revk/SolarSystem/ESP32/README.md

This is the main Solar System ESP32 based platform.

Do not build with ESP IDF beyond 5.0.1 yet - it breaks
