revk/SolarSystem/PCB/AccessWAGO/README.md

# Access

These files are for use in [KiCad](https://www.kicad.org).

## Trademark

This is an open source project, but bear in mind you cannot sell boards bearing the Andrews & Arnold Ltd name, the A&A logo, the registered trademark AJK logo, or the GS1 allocated EANs assigned to Andrews & Arnold Ltd.

## Images

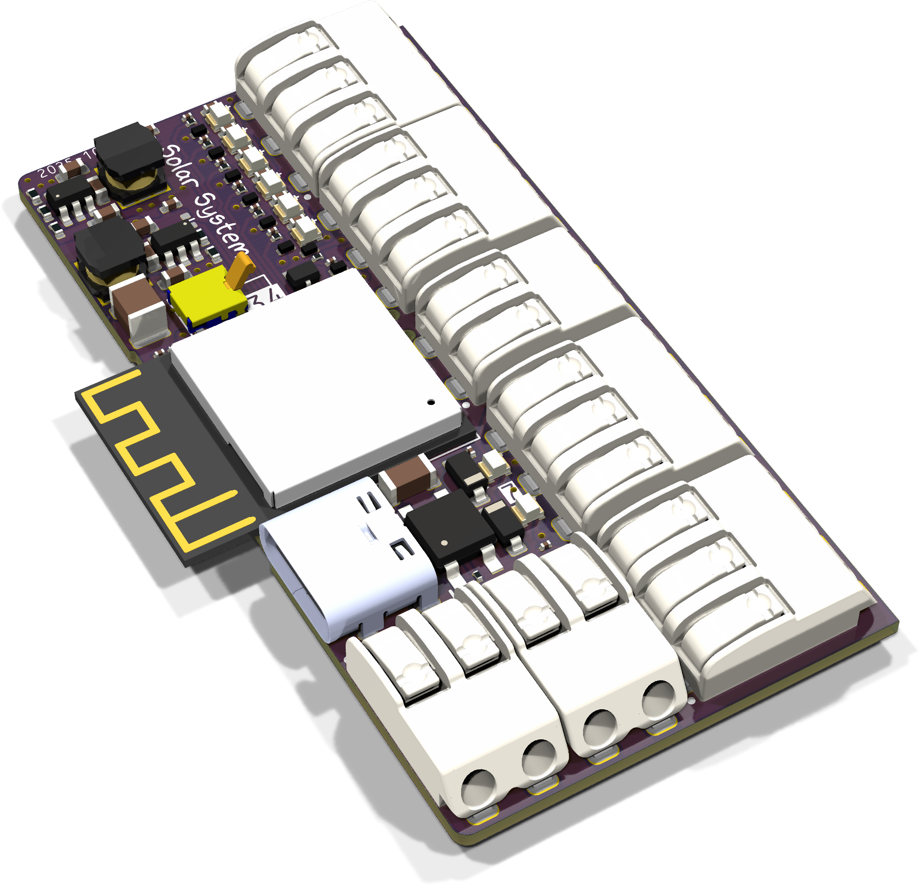
[picture p3: PCB/AccessWAGO/Access-90.png]
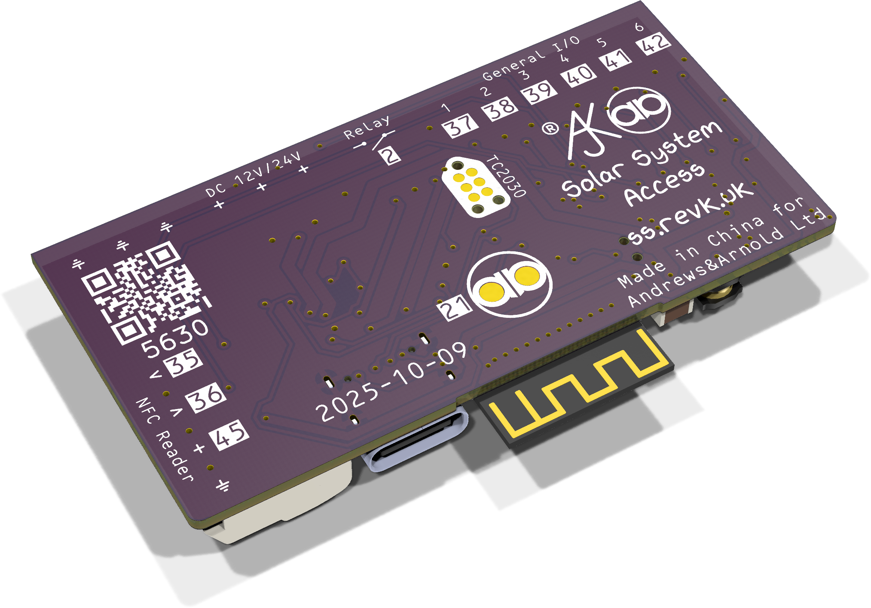
[picture p4: PCB/AccessWAGO/Access-bottom.png]

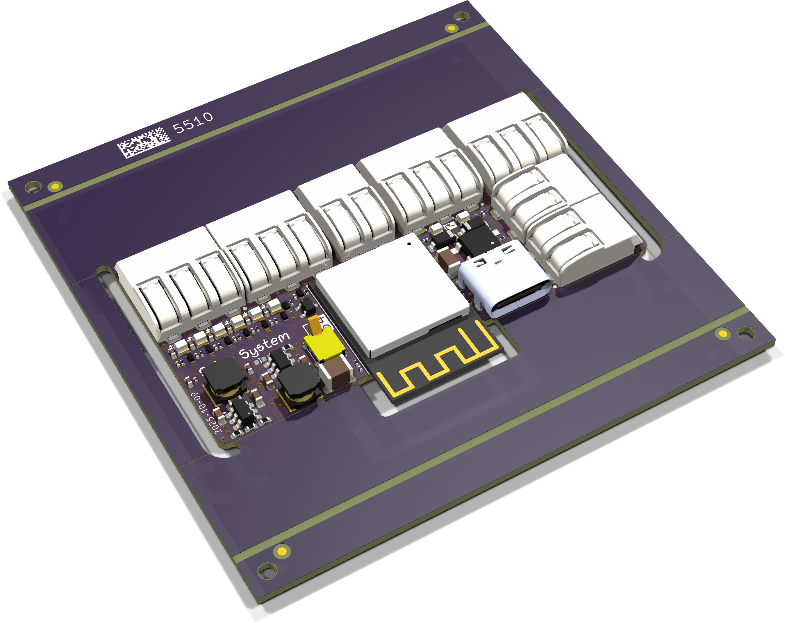
[picture p5: PCB/AccessWAGO/Access-panel.png]
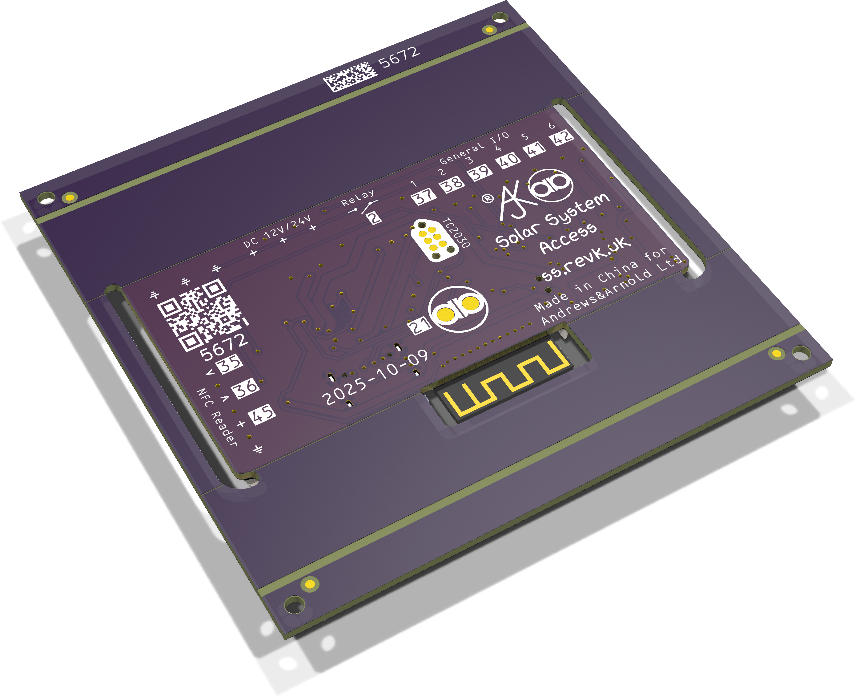
[picture p6: PCB/AccessWAGO/Access-panel-bottom.png]


*Auto generated 2025-08-13T09:46:36*
