revk/SolarSystem/PCB/Access/README.md

# Access

These files are for use in [KiCad](https://www.kicad.org).

## Trademark

This is an open source project, but bear in mind you cannot sell boards bearing the Andrews & Arnold Ltd name, the A&A logo, the registered trademark AJK logo, or the GS1 allocated EANs assigned to Andrews & Arnold Ltd.

## Images

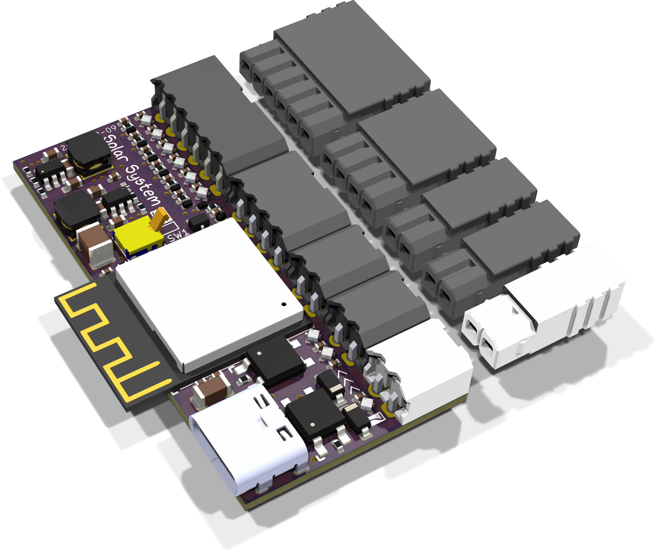
[picture p7: PCB/Access/Access-90.png]
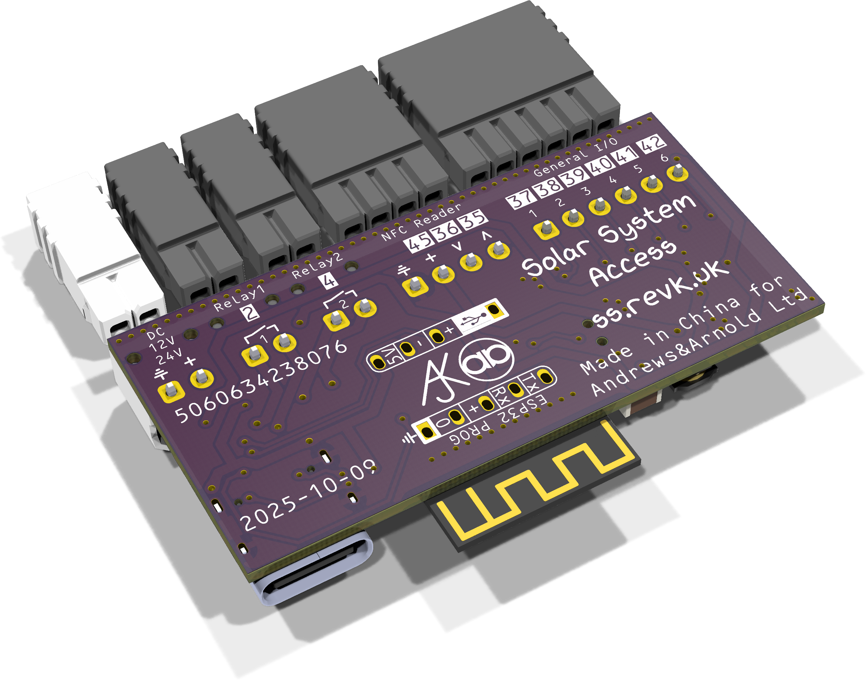
[picture p8: PCB/Access/Access-bottom.png]

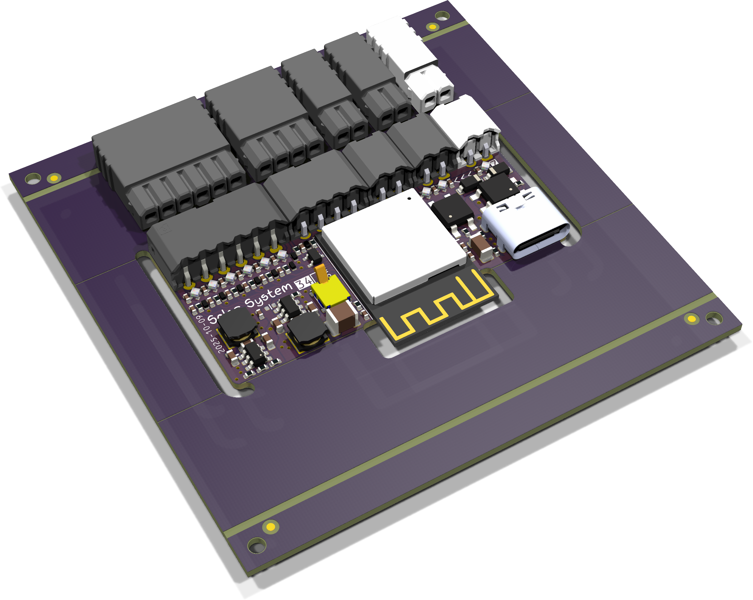
[picture p9: PCB/Access/Access-panel.png]
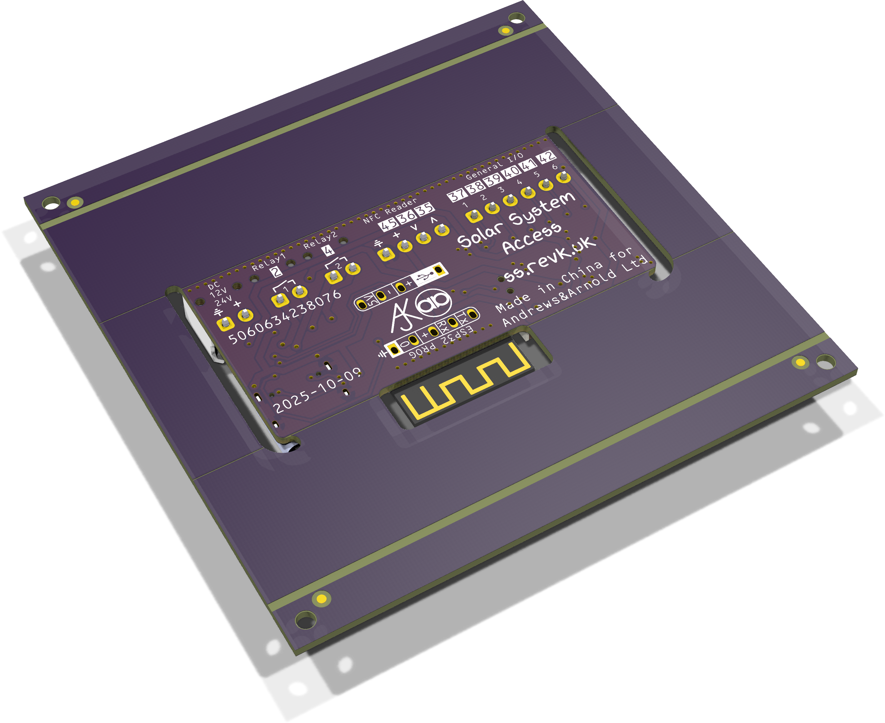
[picture p10: PCB/Access/Access-panel-bottom.png]


*Auto generated 2025-08-12T13:26:37*
