revk/SolarSystem/PCB/Bell/README.md

# Bell

These files are for use in [KiCad](https://www.kicad.org).

## Trademark

This is an open source project, but bear in mind you cannot sell boards bearing the Andrews & Arnold Ltd name, the A&A logo, the registered trademark AJK logo, or the GS1 allocated EANs assigned to Andrews & Arnold Ltd.

## Images

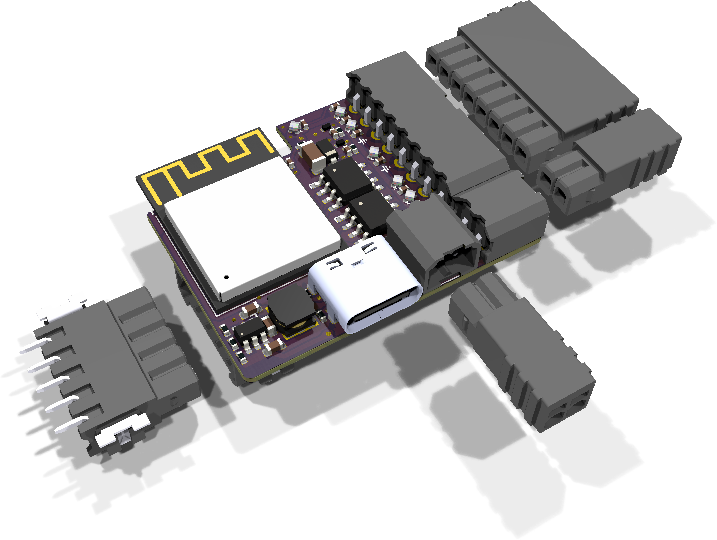
[picture p11: PCB/Bell/Bell.png]
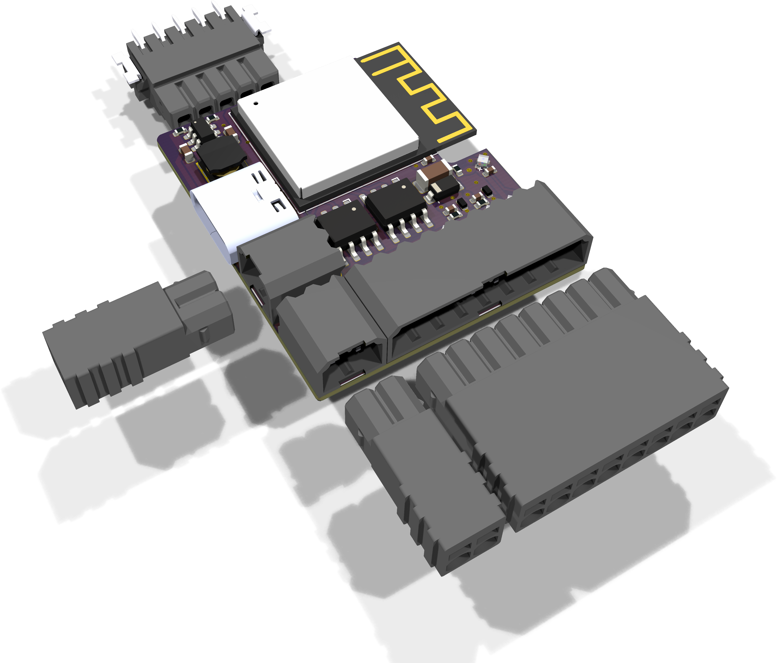
[picture p12: PCB/Bell/Bell-90.png]
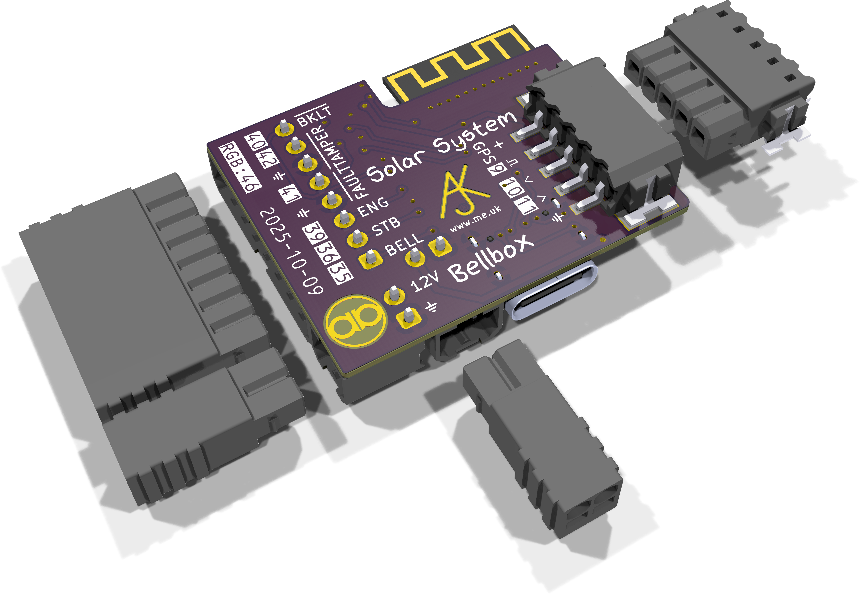
[picture p13: PCB/Bell/Bell-bottom.png]

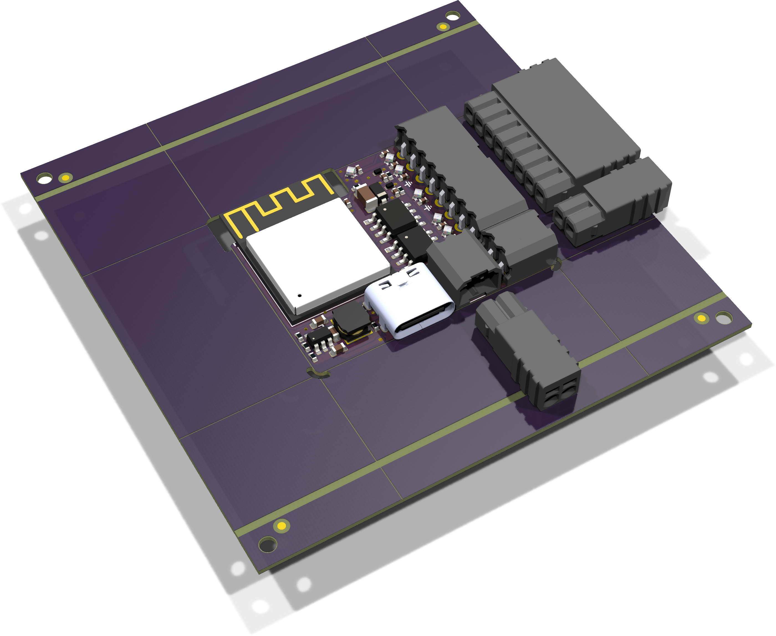
[picture p14: PCB/Bell/Bell-panel.png]
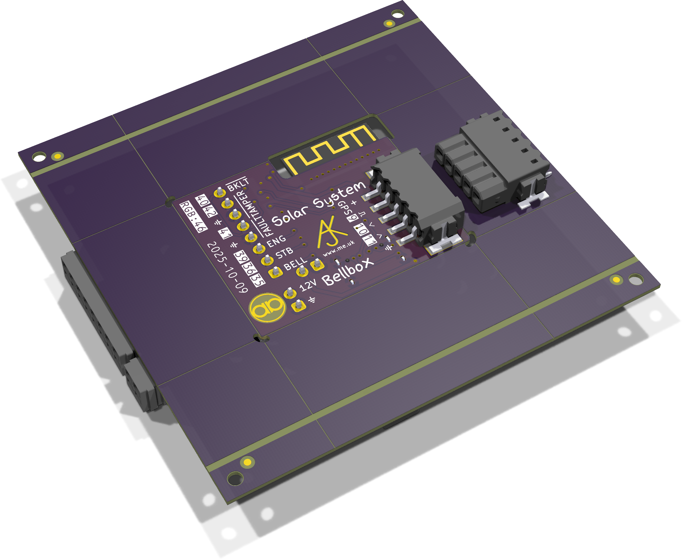
[picture p15: PCB/Bell/Bell-panel-bottom.png]


*Auto generated 2025-08-12T13:32:57*
