revk/SolarSystem/PCB/BellWAGO/README.md

# Bell

These files are for use in [KiCad](https://www.kicad.org).

## Trademark

This is an open source project, but bear in mind you cannot sell boards bearing the Andrews & Arnold Ltd name, the A&A logo, the registered trademark AJK logo, or the GS1 allocated EANs assigned to Andrews & Arnold Ltd.

## Images

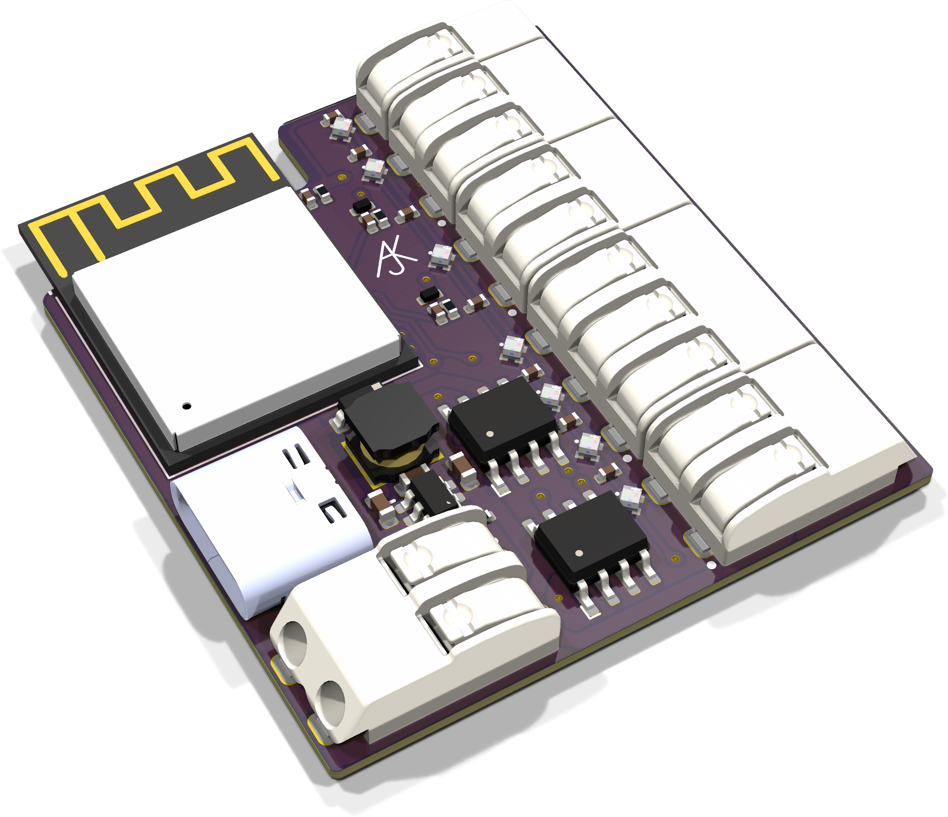
[picture p16: PCB/BellWAGO/Bell.png]
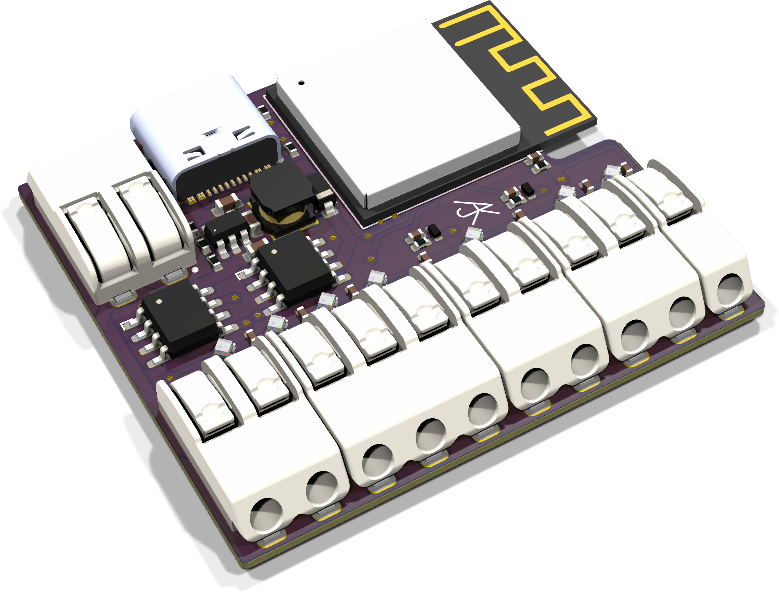
[picture p17: PCB/BellWAGO/Bell-90.png]
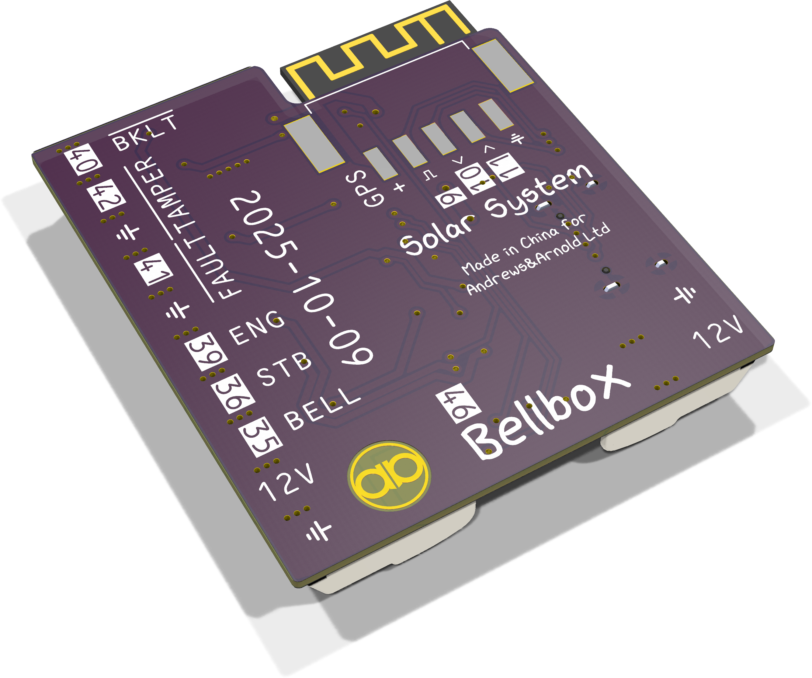
[picture p18: PCB/BellWAGO/Bell-bottom.png]

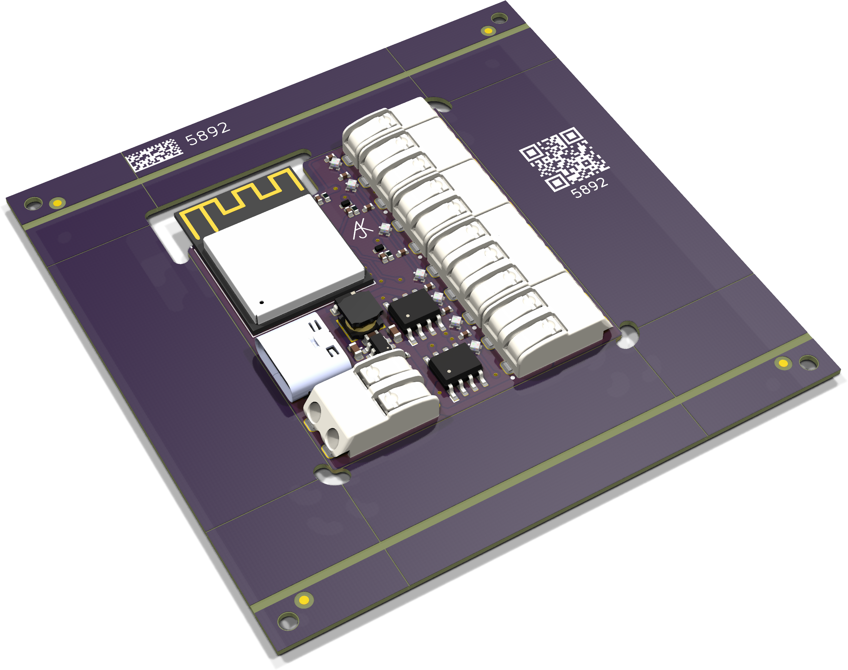
[picture p19: PCB/BellWAGO/Bell-panel.png]
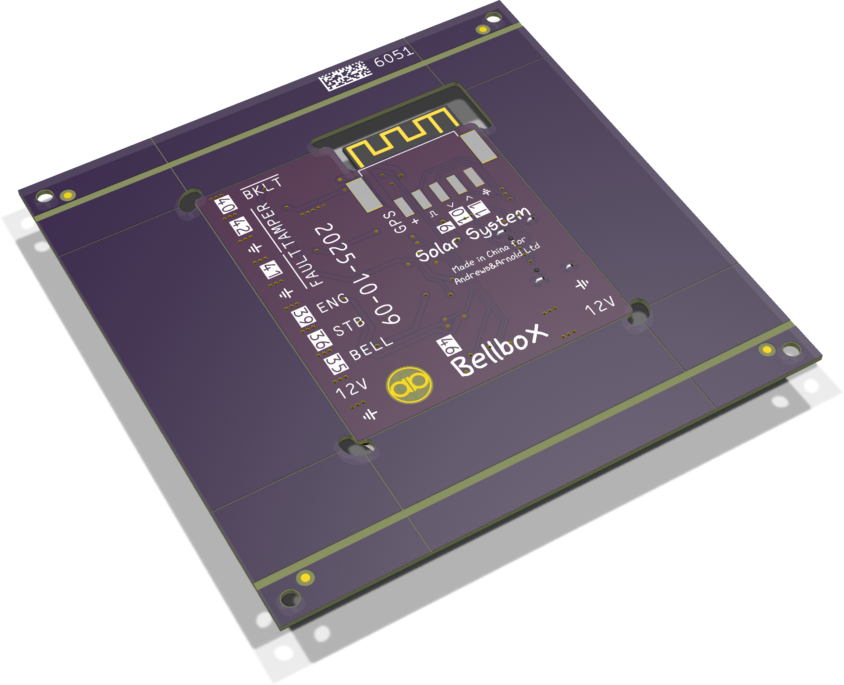
[picture p20: PCB/BellWAGO/Bell-panel-bottom.png]


*Auto generated 2025-08-12T13:36:08*
