revk/SolarSystem/PCB/Generic/README.md

# Generic

These files are for use in [KiCad](https://www.kicad.org).

## Trademark

This is an open source project, but bear in mind you cannot sell boards bearing the Andrews & Arnold Ltd name, the A&A logo, the registered trademark AJK logo, or the GS1 allocated EANs assigned to Andrews & Arnold Ltd.

## Images

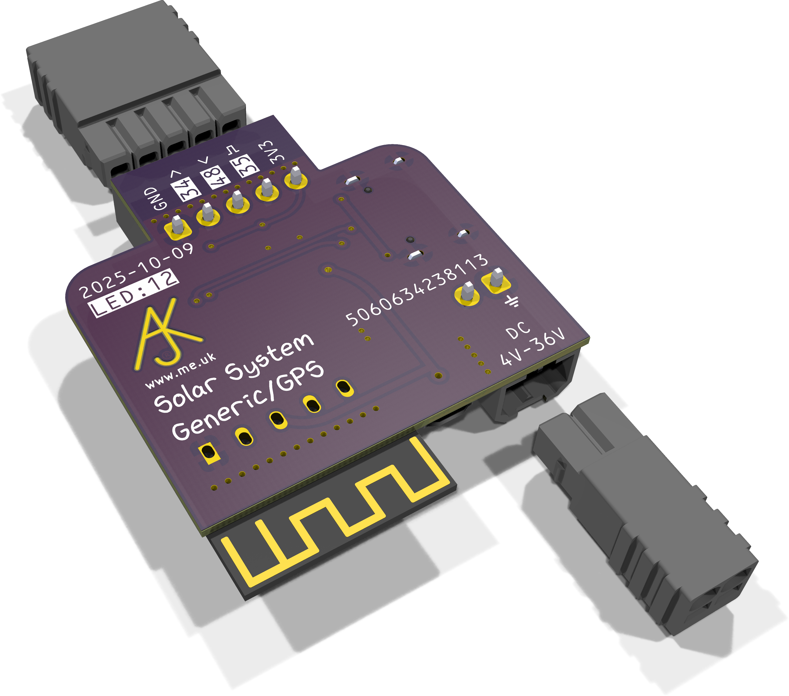
[picture p21: PCB/Generic/Generic.png]
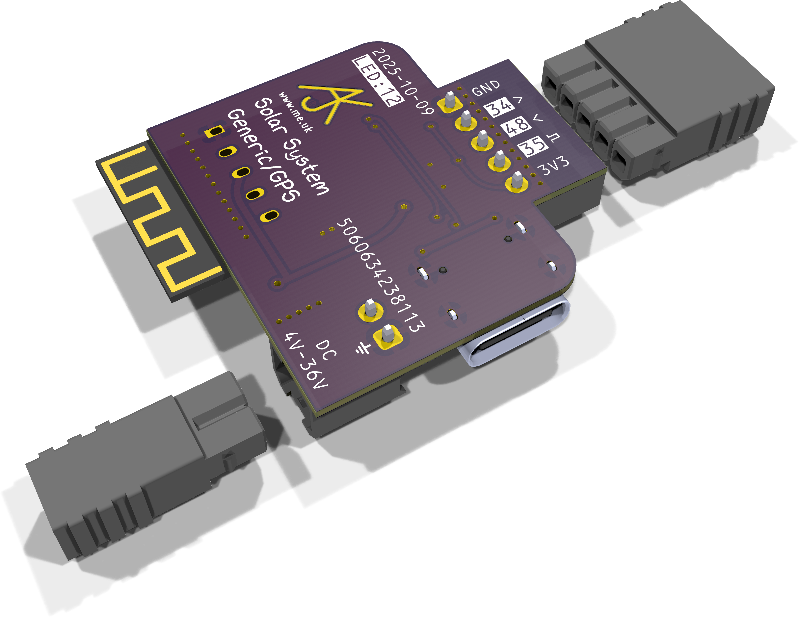
[picture p22: PCB/Generic/Generic-90.png]
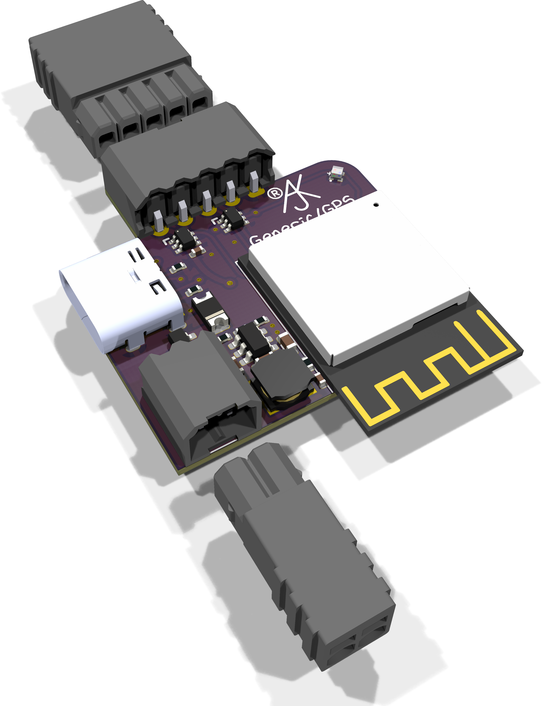
[picture p23: PCB/Generic/Generic-bottom.png]

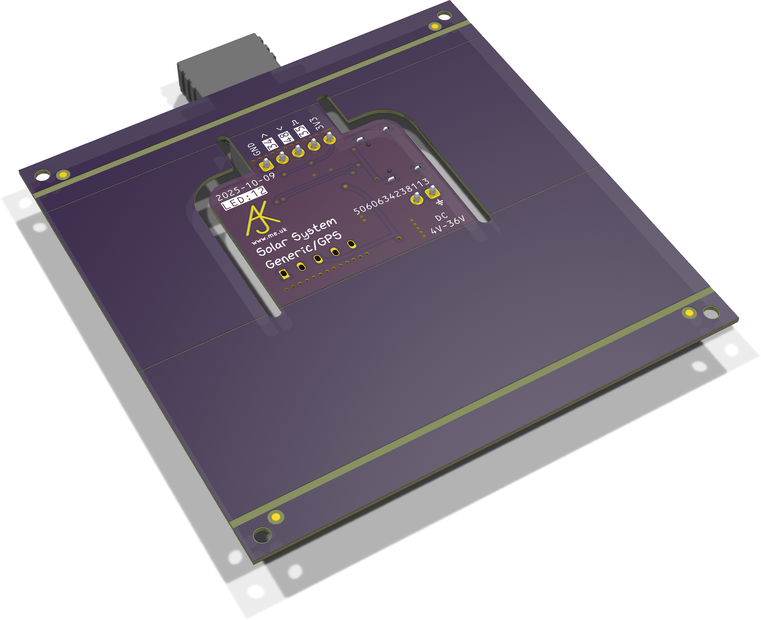
[picture p24: PCB/Generic/Generic-panel.png]
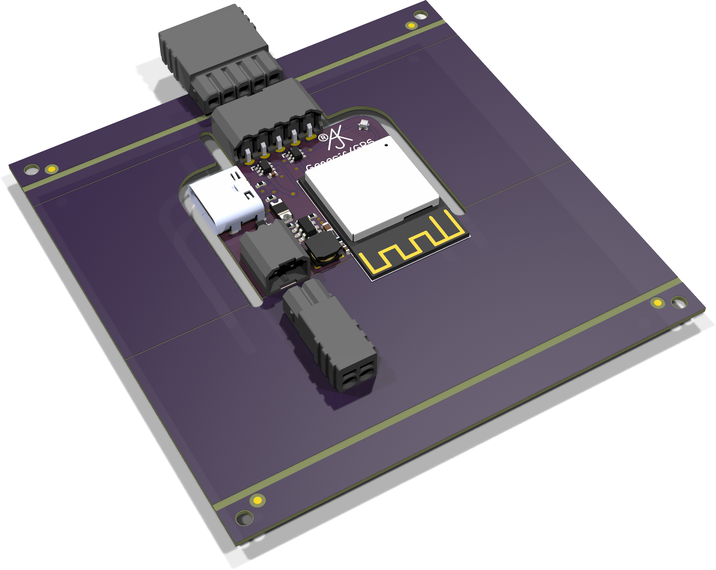
[picture p25: PCB/Generic/Generic-panel-bottom.png]


*Auto generated 2025-08-12T13:39:20*
