revk/SolarSystem/PCB/Keypad/README.md

# Keypad

These files are for use in [KiCad](https://www.kicad.org).

## Trademark

This is an open source project, but bear in mind you cannot sell boards bearing the Andrews & Arnold Ltd name, the A&A logo, the registered trademark AJK logo, or the GS1 allocated EANs assigned to Andrews & Arnold Ltd.

## Images

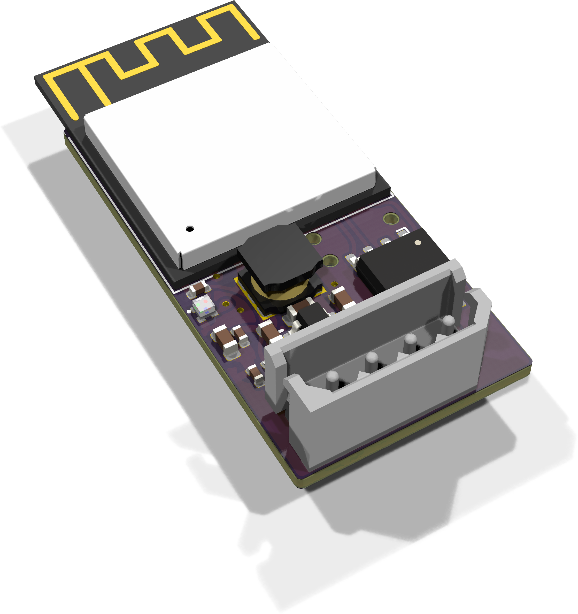
[picture p26: PCB/Keypad/Keypad.png]
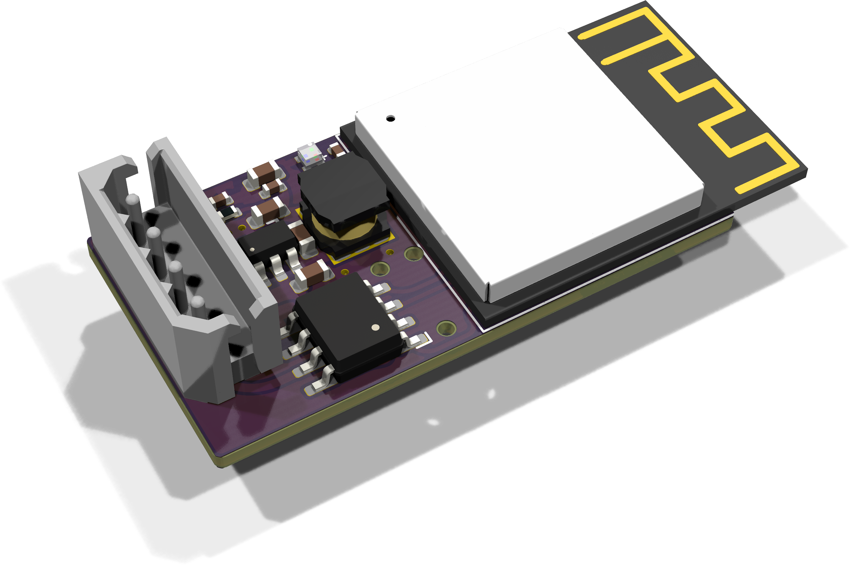
[picture p27: PCB/Keypad/Keypad-90.png]
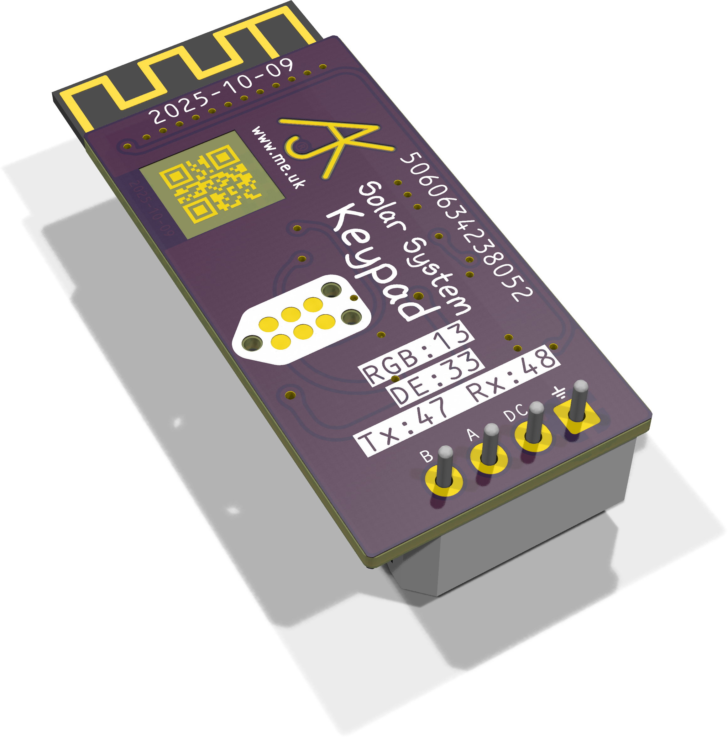
[picture p28: PCB/Keypad/Keypad-bottom.png]

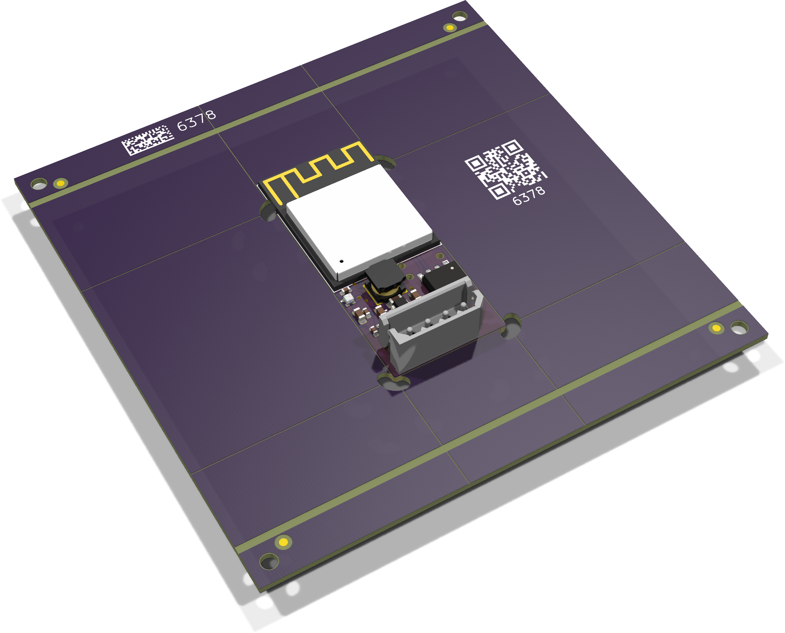
[picture p29: PCB/Keypad/Keypad-panel.png]
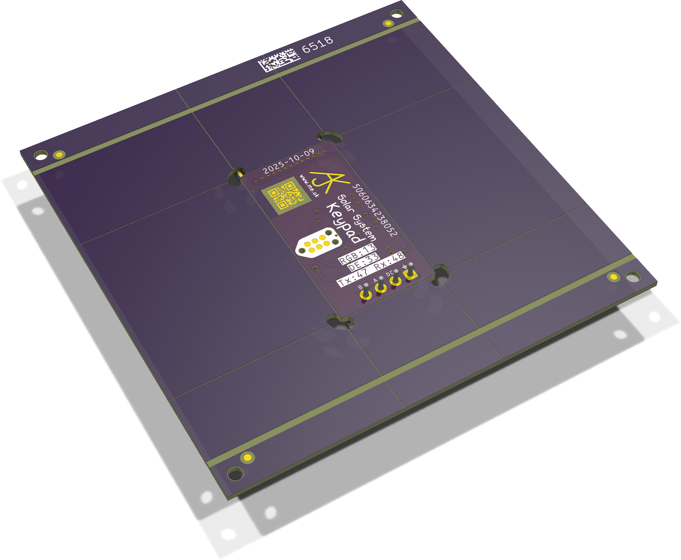
[picture p30: PCB/Keypad/Keypad-panel-bottom.png]


*Auto generated 2025-08-12T13:42:20*
