revk/SolarSystem/PCB/Output/README.md

# Output

These files are for use in [KiCad](https://www.kicad.org).

## Trademark

This is an open source project, but bear in mind you cannot sell boards bearing the Andrews & Arnold Ltd name, the A&A logo, the registered trademark AJK logo, or the GS1 allocated EANs assigned to Andrews & Arnold Ltd.

## Images

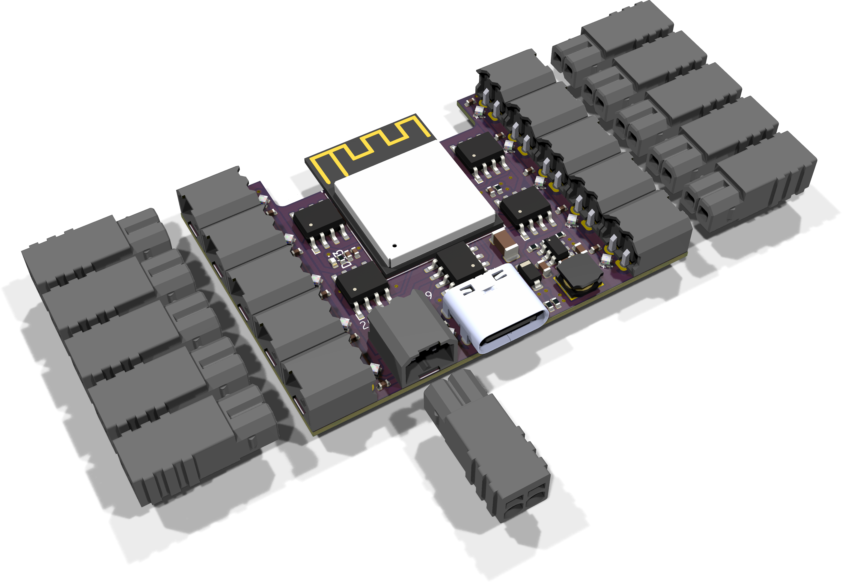
[picture p31: PCB/Output/Output.png]
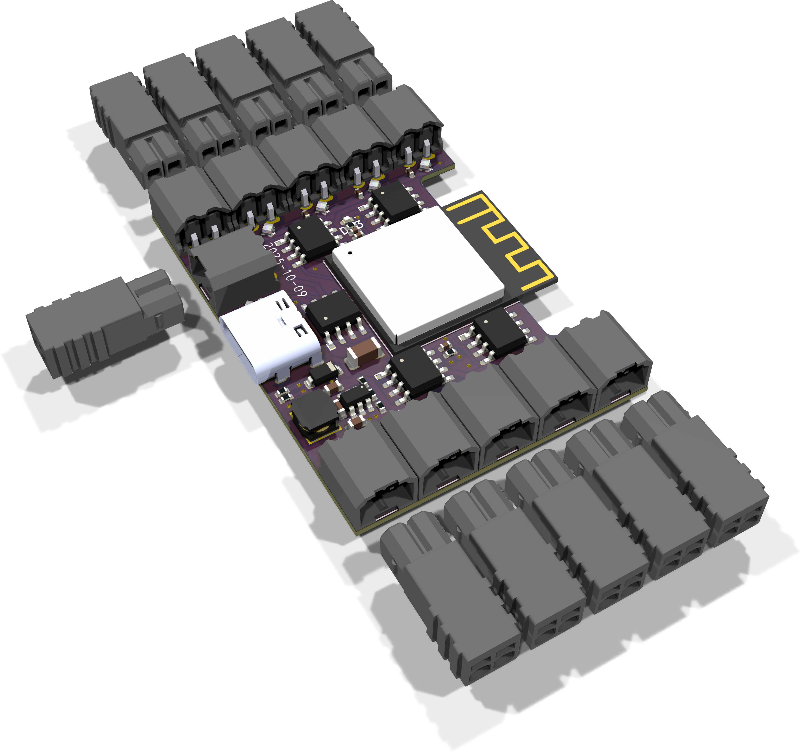
[picture p32: PCB/Output/Output-90.png]
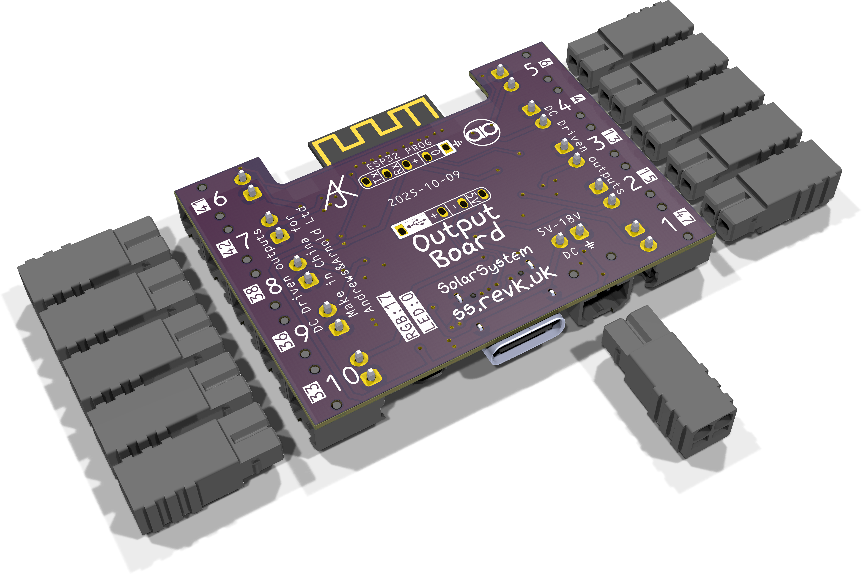
[picture p33: PCB/Output/Output-bottom.png]

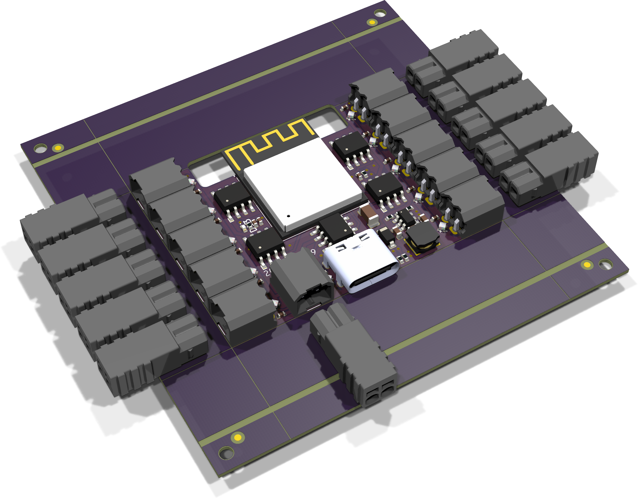
[picture p34: PCB/Output/Output-panel.png]
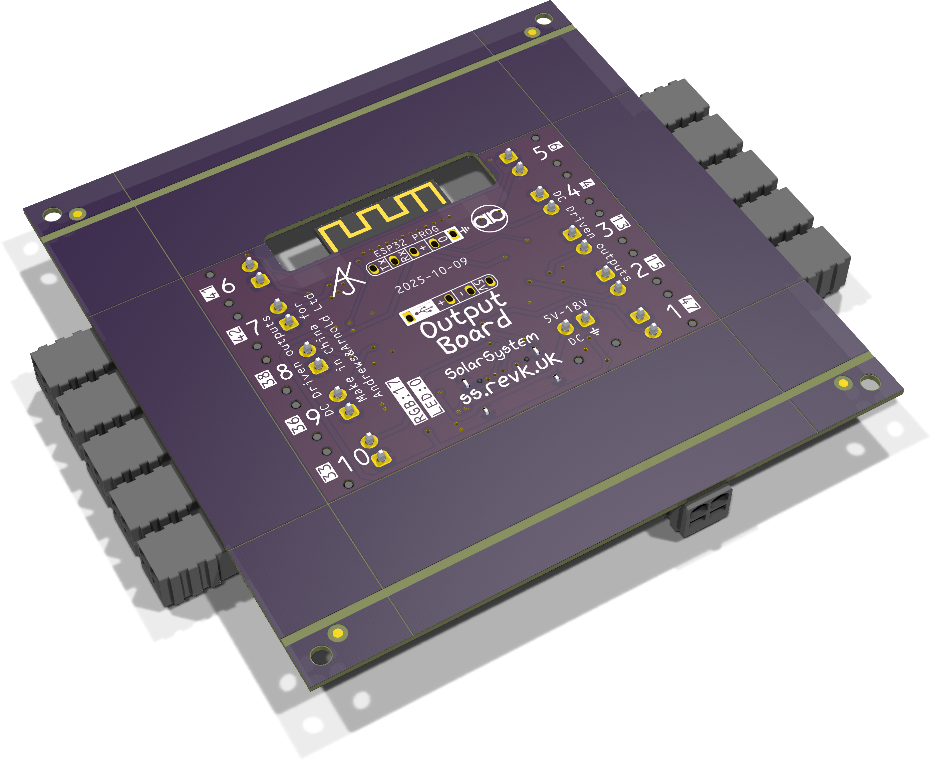
[picture p35: PCB/Output/Output-panel-bottom.png]
