revk/SolarSystem/keypad.png

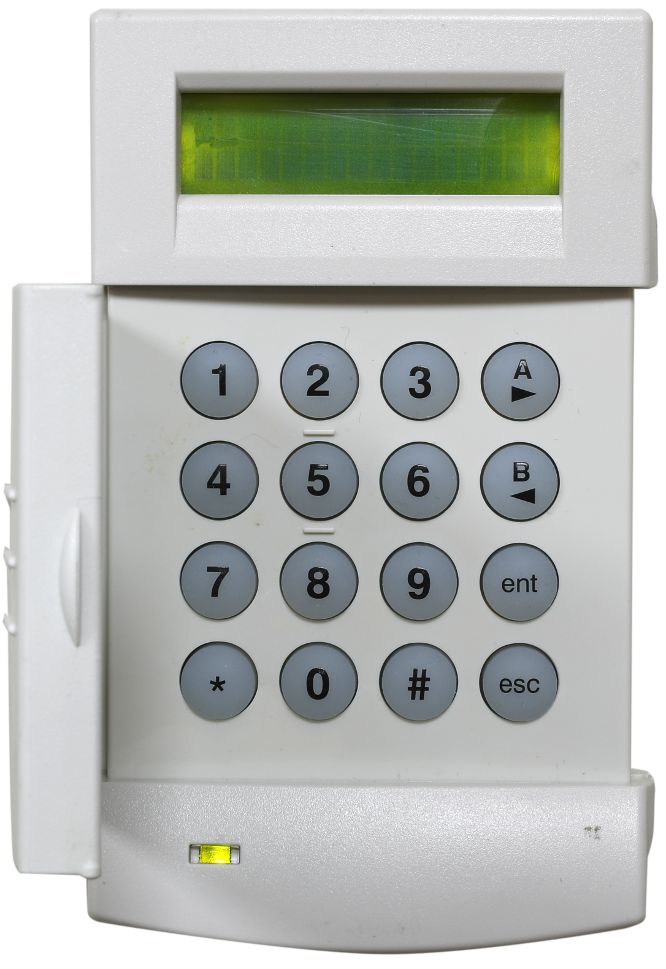
keypad.png
