revk/SolarSystem/PCB/BellWAGO/production/bom.csv

Designator | Footprint | Quantity | Value | LCSC Part #
C1 | C_0603_ | 1 | 10uF 35V | C194427
C10, C11, C12, C13, C4, C5, C6 | C_0402 | 7 | 100nF
C2, C3 | C_0402 | 2 | 33pF
C7 | C_0603_ | 1 | 10uF 6.3V | C1691
C8 | C_0402 | 1 | 1uF
C9 | C_0603_ | 1 | 100nF
D1, D10 | DFN1006-2L | 2 | ~ | C5137770
D2, D4, D5, D6, D7, D8, D9 | SMD1010 | 7 | XL-1010RGBC-WS2812B | C5349953
D3 | D_SOD-123 | 1 | MBR0530 | C5204746
J1 | USB-C-Socket-H | 1 | USB-C-Socket-V | C709357
J10, J11 | WAGO-2060-452-998-404 | 2 | FAULT | C2765055
J2 | WAGO-2060-451-998-404 | 1 | BL | C2765054
J7 | WAGO-2060-453-998-404 | 1 | BELL | C2765056
J8, J9 | WAGO-2060-452-998-404 | 2 | PWR | C2765055
L2 | L_4x4_ | 1 | 10uH | C167879
R1 | R_0402_ | 1 | 124k
R2 | R_0402_ | 1 | 40k2
R3 | R_0402_ | 1 | 1M
R4, R7 | R_0402 | 2 | 100R
R5, R6 | R_0402 | 2 | 5K1
R8 | R_0402 | 1 | 10K
U1 | SOT-23-6-MD8942 | 1 | MD8942 | C2684786
U3, U4 | SO-8_3.9x4.9mm_P1.27mm | 2 | ISL89410 | C635887
U6 | ESP32-S3-MINI-1 | 1 | ESP32-S3-MINI-1 | C3013941
