revk/SolarSystem/PCB/Access/AccessB.stl

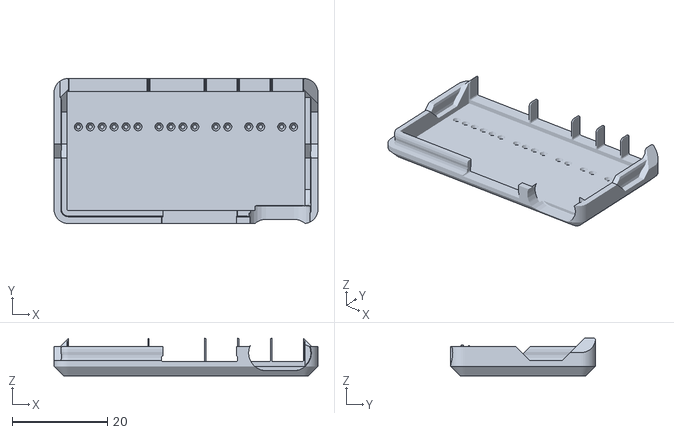
[picture p37: CAD file, 2025-10-17]
PCB/Access/AccessB.stl
55.3 x 30.4 x 7.95
