revk/SolarSystem/PCB/AccessWAGO/AccessT.stl

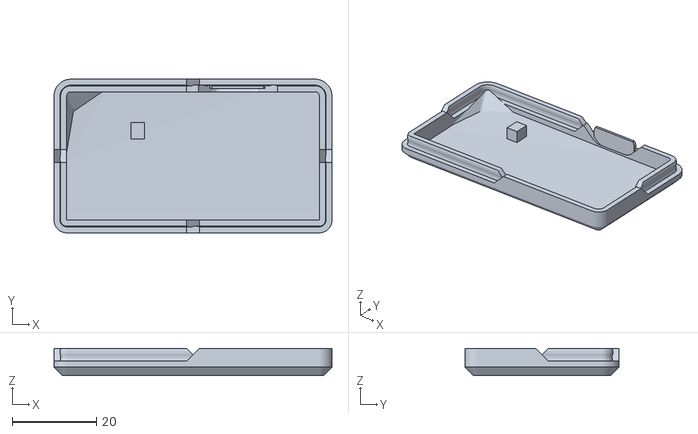
[picture p38: CAD file, 2025-10-17]
PCB/AccessWAGO/AccessT.stl
66.0 x 36.5 x 6.49
