revk/SolarSystem/PCB/Bell/BellT.stl

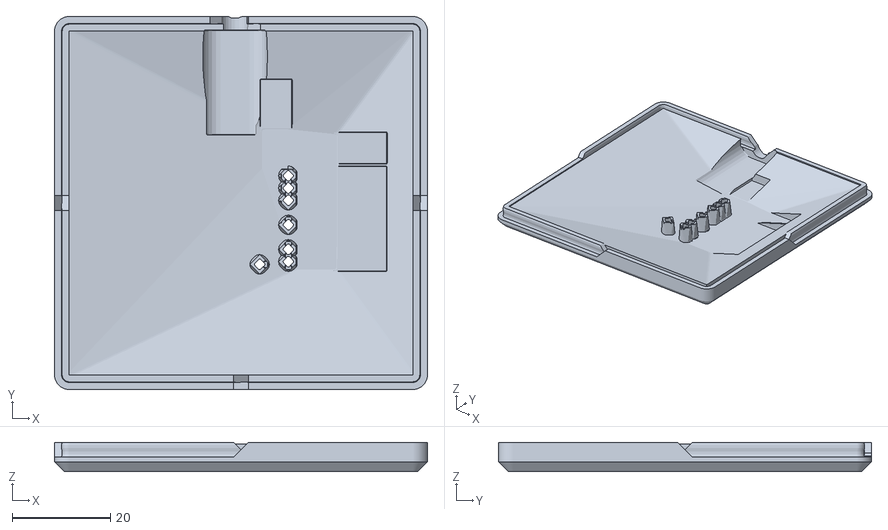
[picture p39: CAD file, 2025-10-17]
PCB/Bell/BellT.stl
76.0 x 76.0 x 5.99
