revk/SolarSystem/PCB/Bell2/Bell.stl

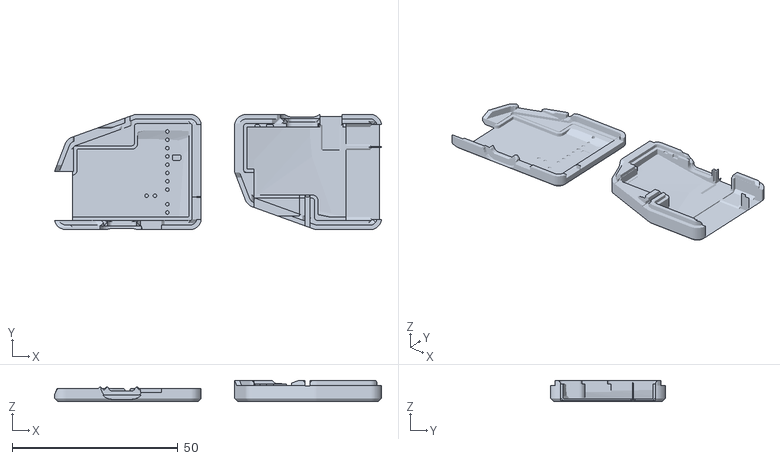
[picture p40: CAD file, 2023-04-06]
PCB/Bell2/Bell.stl
98.5 x 34.7 x 6.40
