revk/SolarSystem/PCB/Generic/GenericT.stl

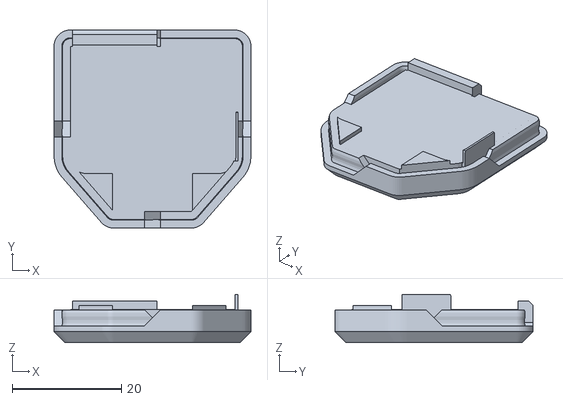
[picture p41: CAD file, 2025-10-17]
PCB/Generic/GenericT.stl
36.0 x 36.2 x 8.80
