revk/SolarSystem/PCB/Keypad/Keypad.stl

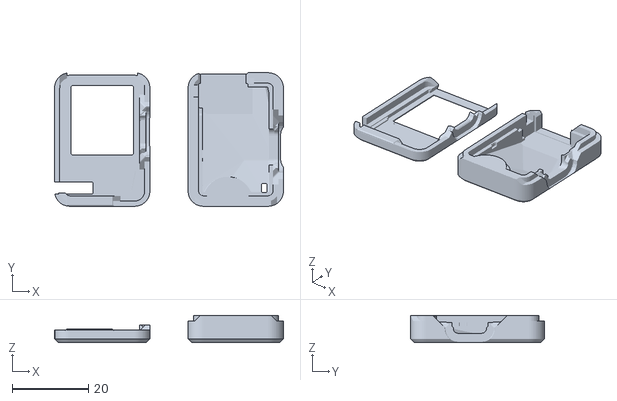
[picture p42: CAD file, 2023-01-11]
PCB/Keypad/Keypad.stl
60.0 x 35.0 x 7.20
