revk/SolarSystem/PCB/Output/OutputT.stl

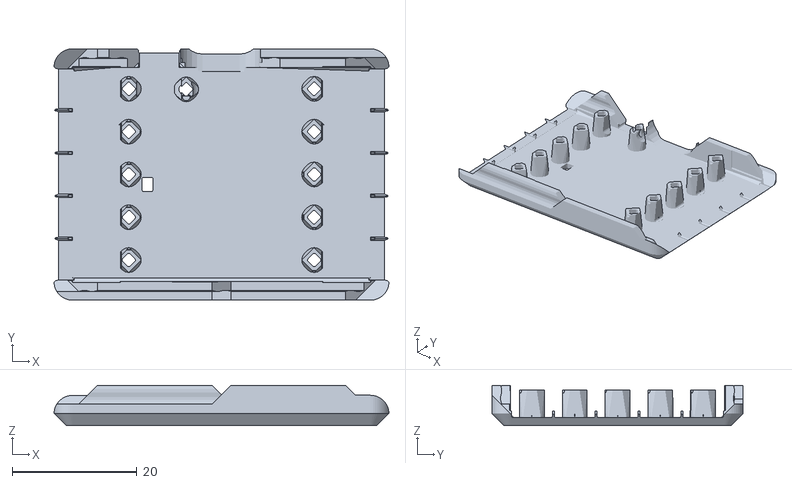
[picture p43: CAD file, 2025-10-17]
PCB/Output/OutputT.stl
53.7 x 40.3 x 6.49
