revk/SolarSystem/PCB/Relay8/Relay8.stl

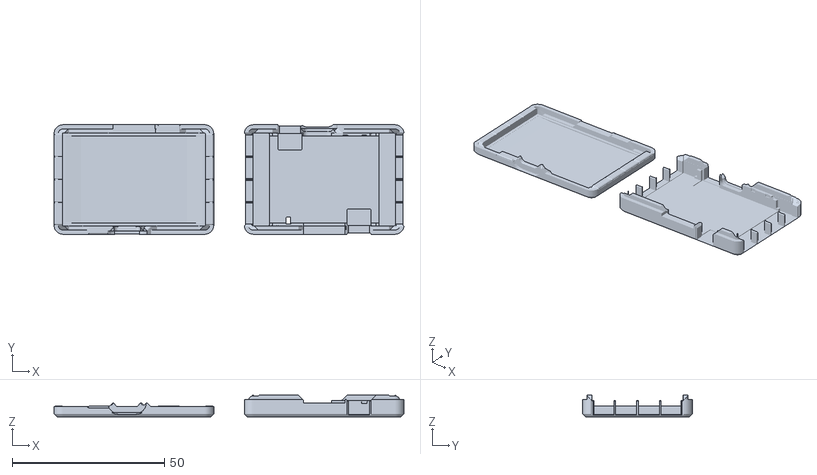
[picture p44: CAD file, 2023-03-26]
PCB/Relay8/Relay8.stl
115.0 x 36.0 x 7.20
