revk/SolarSystem/PCB/Access/AccessT.stl

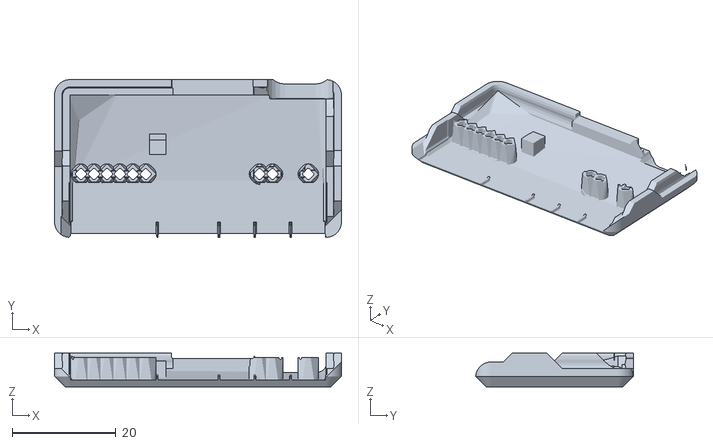
[picture p45: CAD file, 2025-10-17]
PCB/Access/AccessT.stl
55.3 x 30.4 x 6.49
