revk/SolarSystem/PCB/AccessWAGO/AccessB.stl

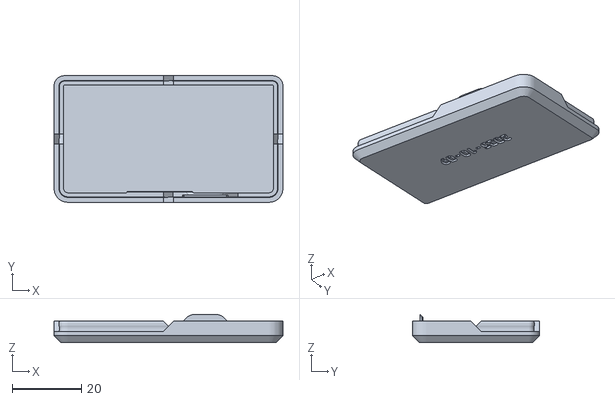
[picture p46: CAD file, 2025-10-17]
PCB/AccessWAGO/AccessB.stl
66.0 x 36.5 x 8.15
