revk/SolarSystem/PCB/Bell/BellB.stl

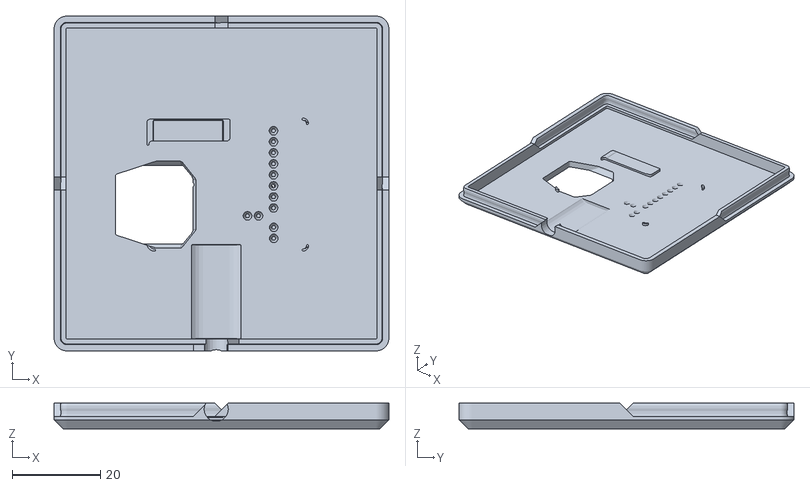
[picture p47: CAD file, 2025-10-17]
PCB/Bell/BellB.stl
76.0 x 76.0 x 5.80
