revk/SolarSystem/PCB/Generic/GenericB.stl

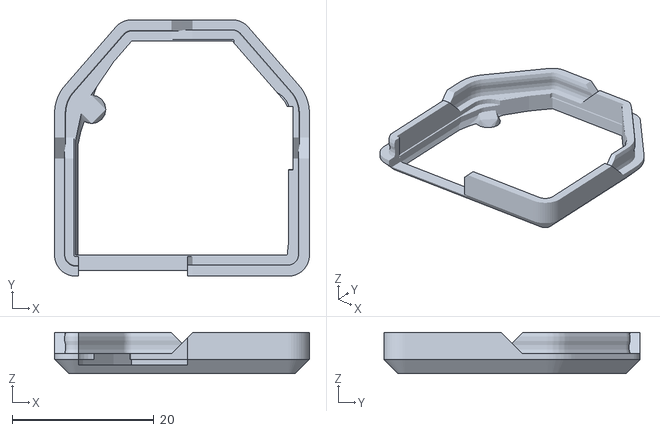
[picture p48: CAD file, 2025-10-17]
PCB/Generic/GenericB.stl
36.0 x 36.2 x 5.80
