revk/SolarSystem/PCB/Output/OutputB.stl

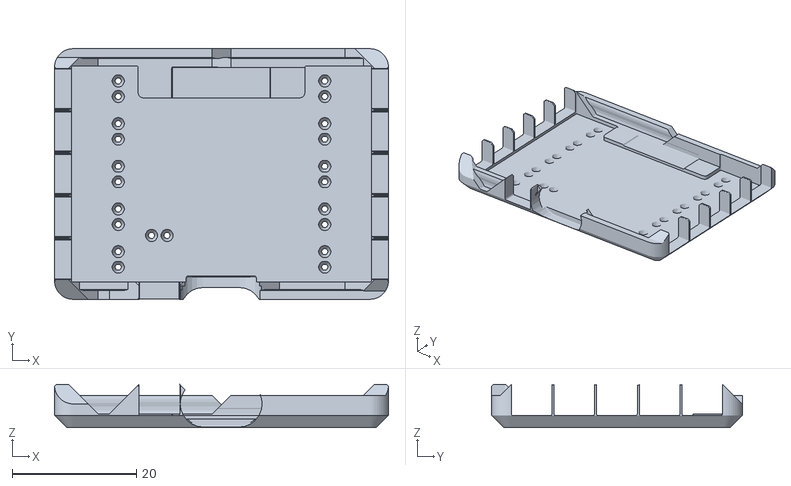
[picture p49: CAD file, 2025-10-17]
PCB/Output/OutputB.stl
53.7 x 40.3 x 6.98
