revk/SolarSystem/PCB/Bell/Bell.stl

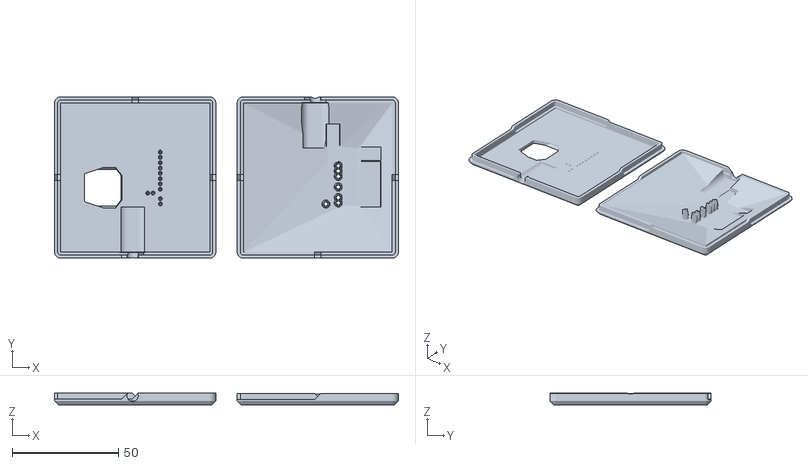
[picture p50: CAD file, 2025-08-09]
PCB/Bell/Bell.stl
162.0 x 76.0 x 5.80
