revk/SolarSystem/PCB/Generic/Generic.stl

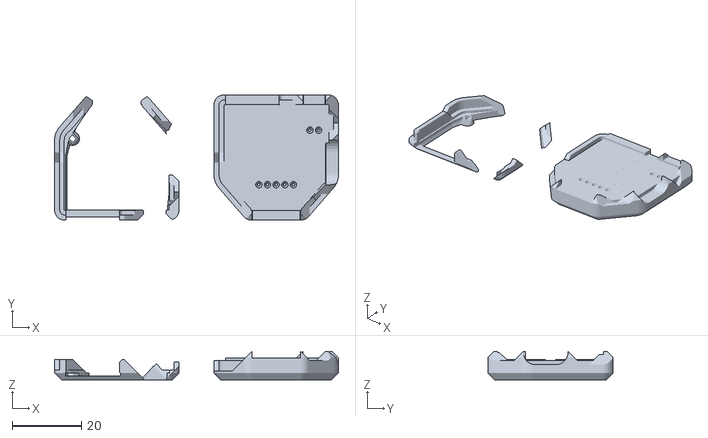
[picture p51: CAD file, 2025-08-09]
PCB/Generic/Generic.stl
82.0 x 36.2 x 8.26
