revk/SolarSystem/PCB/Output/Output.stl

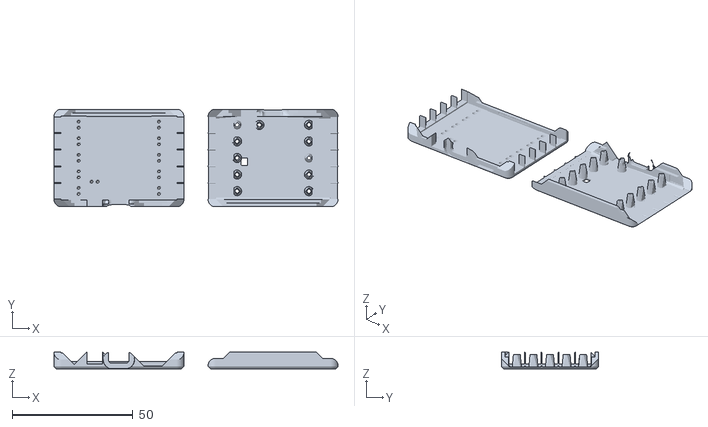
[picture p52: CAD file, 2024-01-05]
PCB/Output/Output.stl
117.4 x 40.3 x 7.03
