revk/SolarSystem/Old-PCB/Bell/Bell.stl

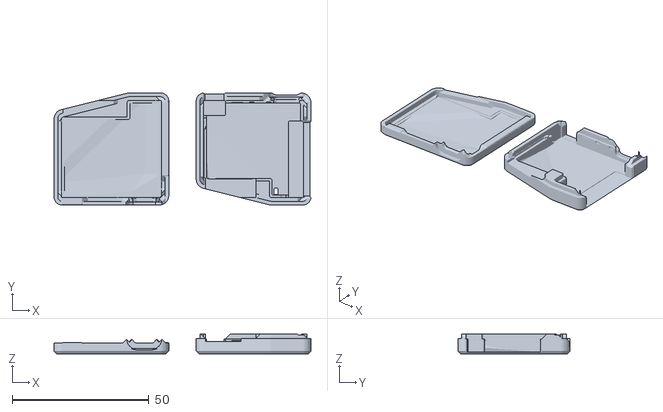
[picture p53: CAD file, 2023-01-11, an earlier design]
Old-PCB/Bell/Bell.stl
94.0 x 41.0 x 7.20
