revk/SolarSystem/(list of files, cad)

Other CAD files:
PCB/Access/AccessT.scad
PCB/AccessWAGO/AccessB.scad
PCB/AccessWAGO/AccessT.scad
PCB/Bell/BellB.scad
PCB/Bell/BellT.scad
PCB/Bell2/Bell.scad
PCB/Generic/Generic.scad
PCB/Generic/GenericB.scad
PCB/Generic/GenericT.scad
PCB/Keypad/Keypad.scad
PCB/Output/Output.scad
PCB/Output/OutputB.scad
PCB/Output/OutputT.scad
PCB/Relay8/Relay8.scad
Old-PCB/Bell/Bell.scad
Old-PCB/Keypad/Keypad.scad
Old-PCB/Relay8/Relay8.scad
