revk/SolarSystem/Manuals/Output.jpg

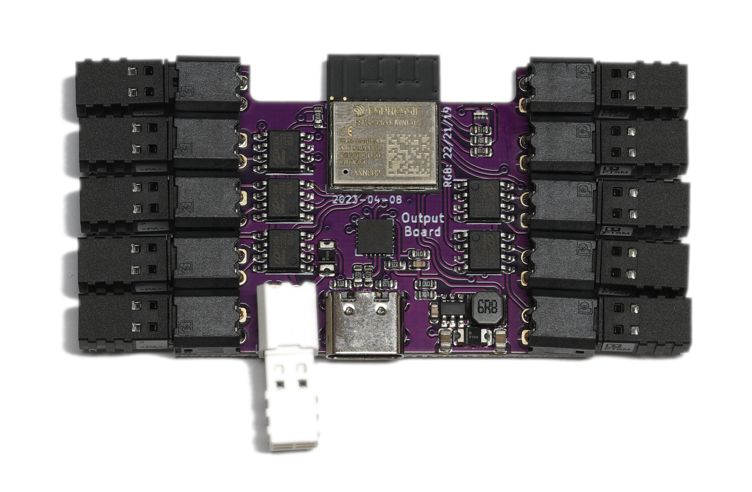
Manuals/Output.jpg
