revk/SolarSystem/(threads)

Thread 14 (2017-07-22):

Pulsed output

revk, 2017-07-22:
Current code has no pulsed output - this looks like something the galaxybus.c code would have to do, and time - it should not be too hard, but would work to resolution of next poll cycle which should be fine.

Would need config in alarmpanel.c to set the pulse time. I assume pulse cut short if output goes off?

revk, 2019-07-11:
Don't think we need this.

Closed 2019-07-11.

Thread 16 (2017-07-22):

RF/RIO

revk, 2017-07-22:
Need to decode how they work on Galaxy panel and add logic to allow them to be associated with RF PIRs and devices.

revk, 2017-07-29:
The good news is that it looks like the RF RIO simply sends the messages it receives over radio. The G2 assigns serial numbered devices to one of 8 ports it seems. However, the RIO does not get told this, it just sends the messages. So sounds like we can make a system that simply has a serial number set as an input type and allow as many as you like. Needs more testing to understand low battery and tamper and so on.

revk, 2017-07-29:
The V2GY protocol stuff looks like a doddle, the Alpha protocol not so, and not obvious how to tell apart. Plan is to code the V2GY stuff for now.

revk, 2019-05-26:
Moving away from Galaxy parts and using ESP/WiFi, I think we can drop this.

Closed 2019-05-26.

Thread 17 (2017-07-24):

Optimise poll timing

revk, 2017-07-24:
It seems that a gap after a message is used as part of the protocol, as we know. But we don't know for sure exactly what gap is needed. It is likely we need a per device type pre-send and post-send time to allow devices to be polled at maximum speed. i.e. some devices seem happy with a shorter gap and so allow faster polling. Some devices seem to vary, e.g. max readers take longer to respond when they have a fob present and even longer when one they do not understand. If talking to a device a second time we would expect it not to need as long as it is not looking for a gap. We also do not know how accurate the linux realtime scheduling is and if it is creating the timings we expect. Bus poll latency is critical to responsiveness of door entry and so on, so optimising poll cycle by adjusting timings is prudent. Needs a lot more testing, and possibly playing with a scope.

revk, 2017-07-26:
I have a scope on the bus now for more testing - seems to expect 10ms inter message gap, and some devices driver the bus before and after their message for some time within that...

revk, 2017-07-26:
Keypad seems to be happy with 5ms timeout, and then doing around 5ms driving bus at start of message, so we can talk to it with only a 5ms gap.

revk, 2017-07-29:
I think the issue with terminating resistors is we see a BREAK as a result of our own sending message, so ignoring an initial NULL now. Need to test on longer line.

revk, 2017-08-23:
I think I have done all I can for now - looking pretty good, even on longer lines.

Closed 2017-08-23.

Thread 28 (2019-01-19):

Option to use this code to monitor galaxy system?

NLRene, 2019-01-19:
More of a question/request to author instead of issue. I have an existing Honeywell Galaxy system (G2-44), and I was hoping to be able to use this code to capture the status of the various sensors (PIR, etc) for my home automation system by monitoring the RS485 bus with an rpi and this code.

So far I'm able to get consistent HEX output using the galaxybus.c code, but I struggle to get make any sense of it / trace it back to any devices/sensors/etc. Any hints/thoughts? Possible at all?

Thx!

revk, 2019-01-20:
I don't think they are well documented. The code does handle several Galaxy devices (keypad, Max reader, and I/O units) which we have mostly worked out. If you have other things, it would need some trial and error.

NLRene, 2019-01-26:
Dear RevK, Adrian,

Thank you for your response. I hope you can also help me out with just
understanding how I can use the code to read RIO and keypad data. Let me
explain my setup first:

- I have a running Honeywell Galaxy G2-44+
- I have a rPi3 running your code, using an USB RS485
- I have connected the USB with the RS 485 bus of the galaxy
- I have adapted your code a bit: not writing to the bus, only reading:

   - Use galaxybus.c / galaxubus.h only
   - Have adapted code a bit, using calling in the main function only poller
   - Outcommented function sendcmd to avoid sending commands
   - With debug on I get the following dump, which shows some repeating hex
   output, but I struggle to interpret this feed
   - Can you give me some hints on how to interpret the received bytes?

I've attached a dump of the feedback received.

Thx again!

Rene.

Op zo 20 jan. 2019 om 09:19 schreef RevK <notifications@github.com>:

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

pi@raspberrypi:~/Scripts/Galaxy $ ./galaxybus.o
starting poller, busid 1
galaxybus.o: Cannot open /sys/bus/usb-serial/devices/ttyUSB1/latency_timer: Permission denied
XXX200 < 6D B9 2D 77 42 FF FF FF FF FF A9 D7 FD 57 77 80 11 BF C3 69 77 01 02 23 4F 9F 00 77 80 8B 6D B9 2D 77 (0.0ms)
Bad checksum
XXX200 < 6D B9 (0.0ms)
XXX200 < 77 42 FF FF FF FF FF (0.0ms)
XXX200 < D7 FD (0.0ms)
XXX200 < 77 80 (0.0ms)
XXX200 < BF C3 (0.0ms)
XXX200 < 77 01 01 (0.0ms)
XXX200 < 4F 9F (0.0ms)
XXX200 < 77 80 (0.0ms)
XXX200 < 6D B9 (0.0ms)
XXX200 < 77 42 FF FF FF FF FF (0.0ms)
XXX200 < BF C3 (0.0ms)
XXX200 < 77 01 02 (0.0ms)
XXX200 < 4F 9F (0.0ms)
XXX200 < 77 (0.0ms)
XXX200 < FF FF FF FF FF FF FF FF FF FF FF (0.0ms)
PAD200 found new
PAD200 lost
PAD200 < 6D B9 (0.0ms)
PAD200 < 77 42 FF FF FF FF FF (0.0ms)
PAD200 < D7 FD (0.0ms)
PAD200 < 77 80 (0.0ms)
PAD200 < BF C3 69 77 01 02 (0.0ms)
PAD200 < 4F 9F (0.0ms)
PAD200 < 77 80 (0.0ms)
PAD200 < 6D B9 (0.0ms)
PAD200 < 77 42 FF FF FF FF FF (0.0ms)
PAD200 < BF E3 FF F3 F3 ED E7 E1 23 4D (0.0ms)
PAD200 < 77 00 B7 6A F2 (0.0ms)
PAD200 < 4F 9F 00 77 80 (0.0ms)
PAD200 < BF E3 FF F3 F3 ED E7 E1 23 4D (0.0ms)
PAD200 < 77 00 B7 6A 79 (10.8ms)
PAD200 < 6D B9 (10.2ms)
PAD200 < 77 42 FF FF FF FF FF (0.0ms)
PAD200 < D7 FD (0.0ms)
PAD200 < 77 80 (1.7ms)
PAD200 < BF C3 (0.1ms)
PAD200 < 77 07 7E 07 7E 07 7E 07 7E 07 7E 07 7E 07 7E 07 7E 07 D9 C0 FF FE E7 (8.7ms)
PAD200 < 4F 9F 00 77 80 (9.6ms)
PAD200 < 6D B9 (0.0ms)
PAD200 < 77 42 FF FF FF FF FF (0.2ms)
PAD200 < D7 FD (2.7ms)
PAD200 < 77 80 (0.2ms)
PAD200 < BF C3 (0.0ms)
PAD200 < 77 01 01 (0.0ms)
PAD200 < 4F 9F 00 77 80 (0.0ms)
PAD200 < 6D B9 (0.0ms)
PAD200 < 77 42 FF FF FF FF FF (0.0ms)
PAD200 < BF C3 (0.0ms)
PAD200 < 77 01 02 (0.0ms)
PAD200 < 4F 9F (0.0ms)
PAD200 < 77 80 (0.0ms)
PAD200 < 6D B9 (0.0ms)
PAD200 < 77 42 FF FF FF FF FF (0.0ms)
PAD200 < D7 FD (0.0ms)
PAD200 < 77 80 (4.7ms)
PAD200 < BF C3 69 77 01 02 (10.1ms)
PAD200 < 4F 9F 00 77 80 (0.0ms)
PAD200 < 6D B9 (8.8ms)
PAD200 < 77 42 FF FF FF FF FF (7.2ms)
PAD200 < BF C3 (0.0ms)
PAD200 < 77 07 7E 87 76 7E 87 76 7E 07 7E 07 7E 07 7E 07 D9 C0 FF FE E7 (0.1ms)
PAD200 < 4F 9F (0.0ms)
PAD200 < 77 80 (4.6ms)
PAD200 < 6D B9 (2.4ms)
PAD200 < 77 42 FF FF FF FF FF (5.2ms)
PAD200 < D7 FD (0.0ms)
PAD200 < 77 80 (0.0ms)
PAD200 < BF C3 69 77 01 02 (0.0ms)
PAD200 < 4F 9F 00 77 04 FF FF FF FF FF FF FF FF FF FF FF (19.4ms)
PAD200 < 6D B9 (1.4ms)
PAD200 < 77 42 FF FF FF FF FF (13.3ms)
PAD200 < D7 FD (0.0ms)
PAD200 < 77 80 (7.2ms)
PAD200 < BF C3 69 77 01 02 (0.0ms)
PAD200 < 4F 9F 00 77 80 (7.0ms)
PAD200 < 6D B9 (0.0ms)
PAD200 < 77 42 FF FF FF FF FF (6.0ms)
PAD200 < BF C3 69 77 01 01 23 4F 9F (50.2ms)
PAD200 < 77 80 (0.0ms)
PAD200 < 6D B9 (0.0ms)
PAD200 < 77 42 FF FF FF FF FF (1.4ms)
PAD200 < D7 FD (0.0ms)
PAD200 < 77 80 (0.0ms)
PAD200 < BF C3 (0.0ms)
PAD200 < 77 07 7E 07 7E 87 76 7E 87 76 7E 87 76 7E 87 99 C8 FE FF (0.0ms)
PAD200 < 4F 9F (0.0ms)
PAD200 < 77 80 (0.2ms)
PAD200 < 6D B9 (0.0ms)
PAD200 < 77 42 FF FF FF FF FF (10.2ms)
PAD200 < D7 FD 57 77 80 (16.8ms)
PAD200 < BF C3 (0.0ms)
PAD200 < 77 01 01 (0.0ms)
PAD200 < 4F 9F (0.0ms)
PAD200 < 77 80 (0.6ms)
PAD200 < 6D B9 (0.0ms)
PAD200 < 77 42 FF FF FF FF FF (0.0ms)
PAD200 < BF C3 (0.0ms)
PAD200 < 77 01 02 (0.0ms)
PAD200 < 4F 9F (0.0ms)
PAD200 < 77 80 (0.0ms)
PAD200 < 6D B9 (0.0ms)
PAD200 < 77 42 FF FF FF FF FF (0.0ms)
Bad checksum
PAD200 < 17 FD 7F 7C FB FB 9B 8D BF 71 6D 63 77 75 5B 75 63 BF BF FB BF BF BF 7B 75 53 75 6D 67 6D 71 6D 63 71 BF BF (0.0ms)
PAD200 < 77 80 (0.0ms)
PAD200 < BF C3 69 77 01 02 (6.9ms)
PAD200 < 4F 9F (0.6ms)
PAD200 < 77 80 (0.1ms)
PAD200 < 6D B9 (0.0ms)
PAD200 < 77 42 FF FF FF FF FF (2.1ms)
PAD200 < 57 FD (0.0ms)
PAD200 < 77 80 (0.1ms)
PAD200 < BF C3 (0.0ms)
PAD200 < 77 07 7E 07 7E 07 7E 07 7E 07 7E 87 76 7E 87 76 99 81 FE FF CE (0.0ms)
PAD200 < 4F 9F (0.0ms)
PAD200 < 77 80 (0.0ms)
PAD200 < 6D B9 (0.0ms)
PAD200 < 77 42 FF FF FF FF FF (1.4ms)
PAD200 < D7 FD (0.1ms)
PAD200 < 77 80 (0.0ms)
PAD200 < BF C3 (0.0ms)
PAD200 < 77 01 01 (0.1ms)
PAD200 < 4F 9F (0.0ms)
PAD200 < 77 04 FF FF FF FF FF FF FF FF FF FF FF (0.5ms)
PAD200 < 6D B9 (0.0ms)
PAD200 < 77 42 FF FF FF FF FF (0.2ms)
PAD200 < D7 FD (0.0ms)
PAD200 < 77 80 (0.0ms)
PAD200 < BF C3 (0.0ms)
PAD200 < 77 01 04 (0.0ms)
PAD200 < 4F 9F (0.0ms)
PAD200 < 77 80 (0.0ms)
PAD200 < 6D B9 (0.0ms)
PAD200 < 77 42 FF FF FF FF FF (0.0ms)
PAD200 < BF C3 (0.0ms)
PAD200 < 77 01 02 (0.0ms)
PAD200 < 4F 9F (0.0ms)
PAD200 < 77 80 (0.0ms)
PAD200 < 6D B9 (0.0ms)
PAD200 < 77 42 FF FF FF FF FF (0.0ms)
PAD200 < D7 FD (0.0ms)
PAD200 < 77 80 (0.0ms)
PAD200 < BF C3 (0.0ms)
PAD200 < 77 07 7E 07 7E 07 7E 07 7E 07 7E 07 7E 87 76 7E 07 66 0F FF FE (0.0ms)
PAD200 < 4F 9F (0.0ms)
PAD200 < 77 80 (0.0ms)
PAD200 < 6D B9 (0.0ms)
PAD200 < 77 42 FF FF FF FF FF (0.0ms)
PAD200 < BF C3 (0.0ms)
PAD200 < 77 01 02 (0.0ms)
PAD200 < 4F 9F (0.0ms)
PAD200 < 77 80 (0.0ms)
PAD200 < 6D B9 (0.0ms)
PAD200 < 77 42 FF FF FF FF FF (0.7ms)
Bad checksum
PAD200 < D7 FD (0.0ms)
PAD200 < 77 80 (0.0ms)
PAD200 < BF C3 (0.0ms)
PAD200 < 77 01 02 (0.0ms)
PAD200 < 4F 9F (0.0ms)
PAD200 < 77 80 (0.0ms)
PAD200 < 6D B9 (0.0ms)
PAD200 < 77 42 FF FF FF FF FF (0.0ms)
PAD200 < BF C3 69 77 01 02 (0.0ms)
PAD200 < 4F 9F 00 77 80 (0.0ms)
PAD200 < 6D B9 (0.0ms)
PAD200 < 77 42 FF FF FF FF FF (0.2ms)
PAD200 < D7 FD (0.0ms)
PAD200 < 77 80 (0.0ms)
PAD200 < BF C3 (0.0ms)
PAD200 < 77 07 7E 07 7E 87 76 7E 07 7E 07 7E 07 7E 07 7E 07 66 3E FF FE (0.0ms)
PAD200 < 4F 9F (0.0ms)
PAD200 < 77 80 (0.0ms)
PAD200 < 6D B9 (0.0ms)
PAD200 < 77 42 FF FF FF FF FF (0.0ms)
PAD200 < D7 FD (0.0ms)
PAD200 < 77 80 (0.0ms)
PAD200 < BF C3 (0.0ms)
PAD200 < 77 01 01 (0.7ms)
PAD200 < 4F 9F (5.2ms)
PAD200 < 77 04 FF FF FF FF FF FF FF FF FF FF FF (0.1ms)
PAD200 < 6D B9 (0.0ms)
PAD200 < 77 42 FF FF FF FF FF (0.0ms)
PAD200 < BF C3 (0.1ms)
PAD200 < 77 01 02 (0.0ms)
PAD200 < 4F 9F (0.0ms)
PAD200 < 77 80 (0.0ms)
PAD200 < BF E3 FF F5 F3 ED E7 E1 23 4F (0.0ms)
PAD200 < 77 00 B7 6A F2 (0.0ms)
PAD200 < 6D B9 (0.0ms)
PAD200 < 77 42 FF FF FF FF FF (0.0ms)
PAD200 < BF E3 FF F5 F3 ED E7 E1 23 4F (0.0ms)
PAD200 < 77 00 37 6A F2 (0.0ms)
PAD200 < D7 FD (0.0ms)
PAD200 < 77 80 (0.0ms)
PAD200 < BF C3 69 77 01 01 (0.3ms)
PAD200 < 4F 9F (0.0ms)
PAD200 < 77 80 (0.0ms)
PAD200 < 6D B9 (0.0ms)
PAD200 < 77 42 FF FF FF FF FF (0.0ms)
PAD200 < BF C3 (0.0ms)
PAD200 < 77 07 7E 87 76 7E (0.0ms)
PAD200 < 76 7E 07 7E 87 76 7E 87 99 C8 FE FF (0.0ms)
PAD200 < 4F 9F (0.0ms)
PAD200 < 77 80 (0.0ms)
PAD200 < 6D B9 (0.0ms)
PAD200 < 77 42 FF FF FF FF FF (0.1ms)
PAD200 < D7 FD (0.0ms)
PAD200 < 77 80 (0.0ms)
PAD200 < BF C3 (0.6ms)
PAD200 < 77 01 02 (0.0ms)
PAD200 < 4F 9F (0.0ms)
PAD200 < 77 80 (0.0ms)
PAD200 < 6D B9 (0.1ms)
PAD200 < 77 42 FF FF FF FF FF (0.0ms)
PAD200 < D7 FD (0.0ms)
PAD200 < 77 80 (0.0ms)
PAD200 < BF C3 (0.0ms)
PAD200 < 77 01 01 (0.1ms)
PAD200 < 4F 9F (0.0ms)
PAD200 < 77 80 (0.0ms)
PAD200 < 6D B9 (0.0ms)
PAD200 < 77 42 FF FF FF FF FF (0.0ms)
PAD200 < BF C3 (0.8ms)
PAD200 < 77 01 04 (0.0ms)
PAD200 < 4F 9F (0.1ms)
PAD200 < 77 80 (0.0ms)
PAD200 < 6D B9 (0.0ms)
PAD200 < 77 42 FF FF FF FF FF (0.0ms)
PAD200 < D7 FD (0.0ms)
PAD200 < 77 80 (0.0ms)
PAD200 < BF C3 (0.0ms)
PAD200 < 77 07 7E 07 7E 07 7E 07 7E 07 7E 87 76 7E 87 76 99 C8 FE FF (0.0ms)
PAD200 < 4F 9F (0.0ms)
PAD200 < 77 80 (0.0ms)
PAD200 < 6D B9 (0.0ms)
PAD200 < 77 42 FF FF FF FF FF (0.0ms)
PAD200 < BF C3 (0.0ms)
PAD200 < 77 01 02 (0.1ms)
PAD200 < 4F 9F (0.1ms)
PAD200 < 77 04 FF FF FF FF FF FF FF FF FF FF FF (0.4ms)
PAD200 < 6D B9 (0.0ms)
PAD200 < 77 42 FF FF FF FF FF (0.5ms)
PAD200 < D7 FD (0.0ms)
PAD200 < 77 80 (0.0ms)
PAD200 < BF C3 (0.1ms)
PAD200 < 77 01 01 (0.0ms)
PAD200 < 4F 9F (0.0ms)
PAD200 < 77 80 (0.0ms)
PAD200 < 6D B9 (0.0ms)
PAD200 < 77 42 FF FF FF FF FF (0.0ms)
PAD200 < BF C3 (0.0ms)
PAD200 < 77 01 02 (0.0ms)
PAD200 < 4F 9F (0.2ms)
PAD200 < 77 80 (0.0ms)
PAD200 < 6D B9 (0.0ms)
PAD200 < 77 42 FF FF FF FF FF (0.0ms)
PAD200 < D7 FD (0.0ms)
PAD200 < 77 80 (0.0ms)
PAD200 < BF C3 (0.0ms)
PAD200 < 77 07 7E 87 76 7E 87 76 7E 87 76 7E 87 76 99 88 FF FE (0.0ms)
PAD200 < 4F 9F (0.0ms)
PAD200 < 77 80 (0.0ms)
PAD200 < 6D B9 (0.0ms)
PAD200 < 77 42 FF FF FF FF FF (0.0ms)
PAD200 < D7 FD (0.0ms)
PAD200 < 77 80 (0.1ms)
PAD200 < BF C3 (0.0ms)
PAD200 < 77 01 01 (0.0ms)
PAD200 < 4F 9F (0.0ms)
PAD200 < 77 80 (0.0ms)
PAD200 < 6D B9 (0.1ms)
PAD200 < 77 42 FF FF FF FF FF (0.0ms)
PAD200 < BF C3 (0.0ms)
PAD200 < 77 01 02 (0.2ms)
PAD200 < 17 FD FD F1 BF BF BF 53 A3 BF 71 6D 63 77 75 5B 75 63 BF BF FB BF BF BF 7B 75 53 75 6D 67 6D (0.0ms)
PAD200 < 6D 63 71 BF BF AD (0.0ms)
PAD200 < 77 80 (0.0ms)
PAD200 < 4F 9F (0.0ms)
PAD200 < 77 80 (0.0ms)
PAD200 < 6D B9 (0.0ms)
PAD200 < 77 42 FF FF FF FF FF (0.0ms)
PAD200 < 57 FD (0.0ms)
PAD200 < 77 80 (2.8ms)
PAD200 < BF C3 (0.1ms)
PAD200 < 77 01 02 (0.3ms)
PAD200 < 4F 9F 00 77 80 (6.7ms)
PAD200 < 6D B9 (0.0ms)
PAD200 < 77 42 FF FF FF FF FF (0.0ms)
PAD200 < BF C3 (0.0ms)
PAD200 < 77 07 7E 07 7E 87 76 7E 07 7E 07 7E 07 7E 87 76 99 81 FE FF CE (0.0ms)
PAD200 < 4F 9F (0.0ms)
PAD200 < 77 80 (0.0ms)
PAD200 < 6D B9 (0.0ms)
PAD200 < 77 42 FF FF FF FF FF (0.0ms)
PAD200 < D7 FD (0.0ms)
PAD200 < 77 80 (0.0ms)
PAD200 < BF C3 (0.0ms)
PAD200 < 77 01 02 (0.0ms)
PAD200 < 4F 9F (0.0ms)
PAD200 < 77 (2.6ms)
PAD200 < FF FF FF FF FF FF FF FF FF FF FF (0.0ms)
PAD200 found
PAD200 lost
PAD200 < 6D B9 (0.0ms)
PAD200 < 77 42 FF FF FF FF FF (0.0ms)
PAD200 < D7 FD (0.0ms)
PAD200 < 77 80 (0.0ms)
PAD200 < BF C3 (0.0ms)
PAD200 < 77 01 02 (0.0ms)
PAD200 < 4F 9F (0.0ms)
PAD200 < 77 80 (0.0ms)
PAD200 < 6D B9 (0.0ms)
PAD200 < 77 42 FF FF FF FF FF (0.0ms)
PAD200 < BF C3 (0.0ms)
PAD200 < 77 01 01 (0.0ms)
PAD200 < 4F 9F (2.7ms)
PAD200 < 77 80 (0.0ms)
PAD200 < 6D B9 (0.0ms)
PAD200 < 77 42 FF FF FF FF FF (0.5ms)
PAD200 < D7 FD (0.0ms)
PAD200 < 77 80 (0.0ms)
PAD200 < BF E3 (0.0ms)
PAD200 < 77 00 B7 6A 79 (0.0ms)
PAD200 < 4F 9F (0.0ms)
PAD200 < 77 80 (0.1ms)
PAD200 < 6D B9 (0.0ms)
PAD200 < 77 42 FF FF FF FF FF (0.6ms)
PAD200 < BF C3 (0.0ms)
PAD200 < 77 07 7E 07 7E 87 76 7E 87 76 7E 87 76 7E 87 99 C8 FE FF (0.0ms)
PAD200 < 4F 9F 00 77 80 (0.0ms)
PAD200 < 6D B9 (2.7ms)
PAD200 < 77 42 FF FF FF FF FF (0.0ms)
PAD200 < D7 FD (0.0ms)
PAD200 < 77 80 (0.0ms)
PAD200 < BF C3 (0.0ms)
PAD200 < 77 01 01 (0.0ms)
PAD200 < 4F 9F (0.0ms)
PAD200 < 77 80 (0.0ms)
PAD200 < 6D B9 (0.0ms)
PAD200 < 77 42 FF FF FF FF FF (0.1ms)
PAD200 < BF C3 (0.0ms)
PAD200 < 77 01 01 (0.0ms)
PAD200 < 4F 9F (5.2ms)
PAD200 < 77 80 (0.0ms)
PAD200 < 6D B9 (0.1ms)
PAD200 < 77 42 FF FF FF FF FF (0.0ms)
PAD200 < D7 FD (0.0ms)
PAD200 < 77 80 (0.0ms)
Bad checksum
PAD200 < BF C3 (0.0ms)
PAD200 < 77 01 02 (0.0ms)
PAD200 < 4F 9F (0.1ms)
PAD200 < 77 80 (0.0ms)
PAD200 < 6D B9 (0.0ms)
PAD200 < 77 42 FF FF FF FF FF (0.0ms)
PAD200 < BF C3 (0.0ms)
PAD200 < 77 07 7E 87 76 7E 07 7E 07 7E 07 7E 07 7E 07 7E 87 99 81 FE FF CE (0.0ms)
PAD200 < 4F 9F (0.0ms)
PAD200 < 77 (0.0ms)
PAD200 < FF FF FF FF FF FF FF FF FF FF FF (0.0ms)
PAD200 found
PAD200 lost
PAD200 < BF E3 FF F7 F3 ED E7 E1 23 51 00 77 00 B7 6A 79 (0.0ms)
PAD200 < 6D B9 (0.0ms)
PAD200 < 77 42 FF FF FF FF FF (0.0ms)
PAD200 < ? BF (0.6ms)
PAD200 < E3 FF F7 F3 ED E7 E1 23 51 (0.4ms)
RIO200 clash PAD F7 F3 ED
RIO200 lost
RIO200 < 77 00 B7 D4 79 (0.1ms)
RIO200 < D7 FD (0.0ms)
RIO200 < 77 80 (0.2ms)
RIO200 < BF C3 (0.0ms)
RIO200 < 77 01 02 (0.0ms)
RIO200 < 4F 9F (0.0ms)
RIO200 < 77 80 (0.0ms)
RIO200 < 6D B9 (0.0ms)
RIO200 < 77 42 FF FF FF FF FF (0.0ms)
RIO200 < D7 FD 57 77 80 (0.2ms)
RIO200 < BF C3 69 77 01 01 (0.5ms)
RIO200 < 4F 9F (0.0ms)
RIO200 < 77 80 (0.0ms)
RIO200 < 6D B9 (0.2ms)
RIO200 < 77 42 FF FF FF FF FF (2.3ms)
RIO200 < BF C3 (0.0ms)
RIO200 < 77 01 01 (0.1ms)
RIO200 < 4F 9F (0.0ms)
RIO200 < 77 80 (0.8ms)
RIO200 < 6D B9 (0.0ms)
RIO200 < 77 42 FF FF FF FF FF (12.8ms)
RIO200 < D7 FD (0.0ms)
RIO200 < 77 80 (6.2ms)
RIO200 < BF C3 (6.1ms)
RIO200 < 77 07 7E 07 7E 87 76 7E 87 76 7E 87 76 7E 87 99 88 FF FE (0.0ms)
RIO200 < 4F 9F (0.0ms)
RIO200 < 77 80 (0.0ms)
RIO200 < 6D B9 (0.0ms)
RIO200 < 77 42 FF FF FF FF FF (0.0ms)
RIO200 < D7 FD (0.1ms)
RIO200 < 77 80 (0.0ms)
RIO200 < BF C3 (0.0ms)
RIO200 < 77 01 02 (0.0ms)
Bad checksum
RIO200 < 4F 9F 00 77 80 (0.4ms)
RIO200 < 6D B9 (0.0ms)
RIO200 < 77 42 FF FF FF FF FF (1.0ms)
RIO200 < BF C3 69 77 01 02 (20.7ms)
RIO200 < 4F 9F (0.5ms)
RIO200 < 77 80 (0.9ms)
RIO200 < 6D B9 (0.0ms)
RIO200 < 77 42 FF FF FF FF FF (0.0ms)
RIO200 < D7 FD (0.0ms)
RIO200 < 77 80 (0.0ms)
RIO200 < BF C3 (0.0ms)
RIO200 < 77 01 02 (0.0ms)
RIO200 < 4F 9F 00 77 80 (0.0ms)
RIO200 < 6D B9 (0.0ms)
RIO200 < 77 42 FF FF FF FF FF (0.0ms)
RIO200 < BF C3 (0.0ms)
RIO200 < 77 07 7E 07 7E 87 76 7E 87 76 7E 87 76 7E 87 99 01 FF FE E7 (0.0ms)
RIO200 < 4F 9F 00 77 (0.0ms)
RIO200 < FF FF FF FF FF FF FF FF FF FF FF (0.0ms)
PAD200 clash RIO FF FF FF
PAD200 lost
PAD200 < 6D B9 (0.0ms)
PAD200 < 77 42 FF FF FF FF FF (0.0ms)
PAD200 < D7 FD (0.1ms)
PAD200 < 77 80 (0.0ms)
PAD200 < BF C3 (0.1ms)
PAD200 < 77 01 01 (0.0ms)
PAD200 < 4F 9F (0.1ms)
PAD200 < 77 80 (0.0ms)
PAD200 < 6D B9 (0.0ms)
PAD200 < 77 42 FF FF FF FF FF (0.0ms)
PAD200 < BF C3 (3.4ms)
PAD200 < 77 01 02 (0.0ms)
PAD200 < 4F 9F (0.0ms)
PAD200 < 77 80 (0.9ms)
PAD200 < 6D B9 (0.0ms)
PAD200 < 77 42 FF FF FF FF FF (0.3ms)
PAD200 < D7 FD (0.0ms)
PAD200 < 77 80 (0.0ms)
PAD200 < BF C3 (0.0ms)
PAD200 < 77 01 01 (0.0ms)
PAD200 < 4F 9F (0.0ms)
PAD200 < 77 80 (0.0ms)
PAD200 < 6D B9 (0.0ms)
PAD200 < 77 42 FF FF FF FF FF (0.0ms)
PAD200 < BF C3 (5.4ms)
PAD200 < 77 07 7E 07 7E 07 7E 07 7E 87 76 7E 87 76 7E 87 99 88 FF FE (0.0ms)
^C

revk, 2019-01-27:
You will need to do more than simply not sending data. There is polling and so each response is a response to a poll. To passively monitor you need code that understands the poll and then the response to that poll. It would also have to work out, or know. What type of device is at each address.

I did write up quite a bit on my blog I believe. That may help.

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

Thread 31 (2021-03-29):

Installation guide

OptimusGREEN, 2021-03-29:
Hi,

This looks like a great project so thanks for creating it.

I am struggling to find the installation guide within the manual pages though. I see you can install it on a pi and then connect the pi to the rs485 bus which is great.

Could you point me to the install guide for installing the software on my pi please?

revk, 2021-03-29:
Hmm, I'll have to look. It used off the shelf USB->RS485 widgets, and I thought there were even RS part numbers in there. The code just needs making and running. How far did you get?

OptimusGREEN, 2021-03-29:
yeah its just the software build i couldnt find info for.

`john@MacBook SolarSystem % make
git submodule update --init
cc -g -Wall -Wextra -O -c -o galaxybus.o galaxybus.c -I. -IAXL -DLIB -pthread
galaxybus.c:28:10: fatal error: 'popt.h' file not found
#include <popt.h>
         ^~~~~~~~
1 error generated.
make: *** [galaxybus.o] Error 1`

make isn't something im familiar with.

revk, 2021-03-29:
Ah well install popt for a start!

OptimusGREEN, 2021-03-29:
yup, i've installed each requirement as it errored but now having an issue with mqtt being undeclared.

`git submodule update --init
cc -g -Wall -Wextra -O -o alarmpanel alarmpanel.c galaxybus.o port.o afile.o door.o -I. -IAXL -IDataformat -Iwebsocket -IDESFireAES/include AXL/axl.o Dataformat/dataformat.o websocket/websocketxml.o DESFireAES/desfireaes.o -lcurl -pthread -lpopt -DLIBWS   -lcrypto -lssl
alarmpanel.c: In function ‘mqtt_door’:
alarmpanel.c:382:10: warning: implicit declaration of function ‘mosquitto_publish’ [-Wimplicit-function-declaration]
          mosquitto_publish(mqtt, NULL, topic, afilelen, afile, 1, 0);
          ^~~~~~~~~~~~~~~~~
alarmpanel.c:382:28: error: ‘mqtt’ undeclared (first use in this function)
          mosquitto_publish(mqtt, NULL, topic, afilelen, afile, 1, 0);
                            ^~~~
alarmpanel.c:382:28: note: each undeclared identifier is reported only once for each function it appears in
alarmpanel.c: In function ‘mqtt_led’:
alarmpanel.c:401:22: error: ‘mqtt’ undeclared (first use in this function)
    mosquitto_publish(mqtt, NULL, topic, strlen(seq), seq, 1, 0);
                      ^~~~
alarmpanel.c: In function ‘mqtt_output’:
alarmpanel.c:417:22: error: ‘mqtt’ undeclared (first use in this function)
    mosquitto_publish(mqtt, NULL, topic, 1, &msg, 1, 0);
                      ^~~~
alarmpanel.c: In function ‘keypad_send’:
alarmpanel.c:766:25: error: ‘mqtt’ undeclared (first use in this function)
       mosquitto_publish(mqtt, NULL, topic, 32, message, 1, 0);
                         ^~~~
alarmpanel.c: In function ‘doevent’:
alarmpanel.c:3664:34: error: ‘mqtt’ undeclared (first use in this function)
                mosquitto_publish(mqtt, NULL, topic, afilelen, afile, 1, 0);
                                  ^~~~
make: *** [Makefile:33: alarmpanel] Error 1`

im just running make from the main solar system directory. Are there other steps required to build?
Sorry, this stuff is kind of new, i know some python but thats no help here lol.

OptimusGREEN, 2021-03-29:
ok, i had the wrong mosquitto lib installed and have got passed that bit.

I'm now stuck with what only seems like warnings to me rather than the build erroring out but I don't have a build so I guess I'm wrong.

`git submodule update --init
Submodule path 'DESFireAES': checked out 'b61d46c4ac81d042bb7dc18f8539fde37a1c596b'
make -C DESFireAES
make[1]: Entering directory '/media/psf/Home/Development/git/SolarSystem/DESFireAES'
cc -fPIC -O -DLIB -c -o desfireaes.o -Iinclude desfireaes.c
make[1]: Leaving directory '/media/psf/Home/Development/git/SolarSystem/DESFireAES'
cc -g -Wall -Wextra -O -o alarmpanel alarmpanel.c galaxybus.o port.o afile.o door.o -I. -IAXL -IDataformat -Iwebsocket -IDESFireAES/include AXL/axl.o Dataformat/dataformat.o websocket/websocketxml.o DESFireAES/desfireaes.o -lcurl -pthread -lpopt -DLIBWS  -DLIBMQTT -lmosquitto -lcrypto -lssl
alarmpanel.c: In function ‘do_keypad_update’:
alarmpanel.c:2992:27: warning: ‘%02d’ directive output may be truncated writing between 2 and 11 bytes into a region of size between 5 and 12 [-Wformat-truncation=]
    snprintf(l2, 17, "%04d-%02d-%02d %02d:%02d", lnow.tm_year + 1900, lnow.tm_mon + 1, lnow.tm_mday, lnow.tm_hour, lnow.tm_min);
                           ^~~~
alarmpanel.c:2992:21: note: directive argument in the range [-2147483647, 2147483647]
    snprintf(l2, 17, "%04d-%02d-%02d %02d:%02d", lnow.tm_year + 1900, lnow.tm_mon + 1, lnow.tm_mday, lnow.tm_hour, lnow.tm_min);
                     ^~~~~~~~~~~~~~~~~~~~~~~~~~
alarmpanel.c:2992:4: note: ‘snprintf’ output between 17 and 60 bytes into a destination of size 17
    snprintf(l2, 17, "%04d-%02d-%02d %02d:%02d", lnow.tm_year + 1900, lnow.tm_mon + 1, lnow.tm_mday, lnow.tm_hour, lnow.tm_min);
    ^~~~~~~~~~~~~~~~~~~~~~~~~~~~~~~~~~~~~~~~~~~~~~~~~~~~~~~~~~~~~~~~~~~~~~~~~~~~~~~~~~~~~~~~~~~~~~~~~~~~~~~~~~~~~~~~~~~~~~~~~~~
alarmpanel.c:2805:42: warning: ‘%2d’ directive output may be truncated writing between 2 and 10 bytes into a region of size 3 [-Wformat-truncation=]
          snprintf(l1, 17, "SETTING ALARM %2d", left);
                                          ^~~
alarmpanel.c:2805:27: note: directive argument in the range [0, 2147483647]
          snprintf(l1, 17, "SETTING ALARM %2d", left);
                           ^~~~~~~~~~~~~~~~~~~
alarmpanel.c:2805:10: note: ‘snprintf’ output between 17 and 25 bytes into a destination of size 17
          snprintf(l1, 17, "SETTING ALARM %2d", left);
          ^~~~~~~~~~~~~~~~~~~~~~~~~~~~~~~~~~~~~~~~~~~
alarmpanel.c: In function ‘doevent’:
alarmpanel.c:3549:51: warning: ‘%02u’ directive output may be truncated writing between 2 and 10 bytes into a region of size 4 [-Wformat-truncation=]
             snprintf(doorno, sizeof(doorno), "DOOR%02u", d);
                                                   ^~~~
alarmpanel.c:3549:46: note: directive argument in the range [0, 2147483647]
             snprintf(doorno, sizeof(doorno), "DOOR%02u", d);
                                              ^~~~~~~~~~
alarmpanel.c:3549:13: note: ‘snprintf’ output between 7 and 15 bytes into a destination of size 8
             snprintf(doorno, sizeof(doorno), "DOOR%02u", d);
             ^~~~~~~~~~~~~~~~~~~~~~~~~~~~~~~~~~~~~~~~~~~~~~~
alarmpanel.c:3304:51: warning: ‘%02u’ directive output may be truncated writing between 2 and 10 bytes into a region of size 4 [-Wformat-truncation=]
             snprintf(doorno, sizeof(doorno), "DOOR%02u", d);
                                                   ^~~~
alarmpanel.c:3304:46: note: directive argument in the range [0, 2147483647]
             snprintf(doorno, sizeof(doorno), "DOOR%02u", d);
                                              ^~~~~~~~~~
alarmpanel.c:3304:13: note: ‘snprintf’ output between 7 and 15 bytes into a destination of size 8
             snprintf(doorno, sizeof(doorno), "DOOR%02u", d);
             ^~~~~~~~~~~~~~~~~~~~~~~~~~~~~~~~~~~~~~~~~~~~~~~
cc -g -Wall -Wextra -O -o cardissue cardissue.c -I. -IDESFireAES/include DESFireAES/desfireaes.o -IAXL AXL/axl.o -lcrypto -lpopt -pthread -lcurl -lmosquitto afile.o
cardissue.c: In function ‘recvt’:
cardissue.c:334:29: warning: passing argument 2 to restrict-qualified parameter aliases with argument 4 [-Wrestrict]
     int r = select (fd + 1, &fset, NULL, &fset, &t);
`

Any help would be greatly appreciated.

revk, 2021-03-30:
You can probably ignore the warnings. I'll have to look at them sometime as compilers have got a lot more fussy these days.

OptimusGREEN, 2021-04-03:
Ok so I've managed to get it built and installed on my pi using the following deps command

`sudo apt install git libpopt-dev libxmlsec1-dev libcurl4-openssl-dev libmosquitto-dev mosquitto mosquitto-clients mosquitto-dev`

I'm having issues getting it to tie in with my existing system without it saying reset tamper etc but I think this is mostly because I don't understand how to setup my xml file properly for my components.

My existing setup:

- Galaxy g2-20 panel
- RF Portal (Address 5)
- 3 x RF PIR
- 1 x RF reed switch
- CP038 keypad with built in prox reader (Address 0)

The existing keypad is connected to my panel using the A:B lines.

My pi is connected to my panel using the A:B lines via a max485 usb adapter.

This is what i have in my config. I know PAD110 is my physical pad, I have also tried with a virtual pad at 120.

`<?xml version="1.0" encoding="UTF-8"?>
<panel>
   <system name="SolarSystem" ws-port="80" engineering="*" mqtt-host="ssmqtt.iot" mqtt-user="solarsystem" mqtt-pass="**********" mqtt-ca="/etc/mosquitto/ca.crt" iot-$
   <group id="0" name="TeamGREEN"/>
   <keypad id="PAD110" message="KeyPad" name="Kpad" prox="190" silent="true" groups="*"/>
   <user name="john" pin="1234" pass="test" full-name="John Green" reset="*" arm="*" disarm="*" rearm="*"/>
</panel>`

If you had my setup, what would your config file look like?

I have also pasted my log [here](https://pastebin.com/raw/hczjTgzy) case there is any info in there that might trigger something. It just keeps saying there is a tamper on my keypad but when I remove my pi/SS and reset my alarm it is all normal.

Any detailed help would be greatly appreciated.

selfmon-automation, 2021-04-10:
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

@OptimusGREEN the SolarSystem is supposed to replace your G2-20 panel, so you need to disconnect the panel and replace it with something like a power RIO.

While the SolarSystem project adds additional features and workarounds for some of the Galaxy settings that annoyed @revk with his own Galaxy system, it does lack some features that the standard Galaxy panels provide in their efforts to cover many installation scenarios and as part of their standards compliance for insurance approved systems.

OptimusGREEN, 2021-04-11:
AHH, I didn't realise this. I thought it was in addition to the panel to allow mqtt communication.

I appreciated you taking the time to give me this info.

I'll close this now as it's obviously not the project for me.

selfmon-automation, 2021-04-11:
Take a look at the SelfMon vmod.  It adds mqqt and will provide RF device payloads along with virtualised keypad and more. Unfortunately, the vmod module is a product and not an open source project.

Closed 2021-04-11.

Thread 32 (2021-07-14):

Keypad operation

revk, 2021-07-14:
We need a whole UI for the keypad in the SS code.

A simple matter of covering specific areas and showing key states such as PREARM, PREALARM, ALARM, TAMPER, FAULT, WARNING, etc.

A way to arm, perhaps one button (A).

A way to disarm with a PIN.

Options for silent, and light off, and so on.

revk, 2021-07-19:
Fixed several bugs in galaxy bus code - amazed it used to work!

Display and keypad working properly - just needs a UI or some sort to be devices.

revk, 2021-07-20:
A basic Ui is in place - needs some beeps

revk, 2021-07-20:
Beeps, blinking LED, backlight, and all tidied up.

revk, 2021-07-21:
I'm going to close this one for now - once we have keypads in use we can look at the requirements for operation. We currently have beeps for pre-alarm, and display status. Once we have logging we can review how to show log entries locally.

Closed 2021-07-21.

Thread 34 (2021-07-14):

Clearing of faults, tampers, alarmed

revk, 2021-07-14:
Should fobs be able to clear faults, tampers, alarms?

This could be a fob setting, and a device setting, so using an admin fob at a special reader, to clear things?

That means new fob tag for what areas can be cleared, and a new device setting for what areas can be cleared.

Would it be simpler to have a self clear time for these, even if like 12 hours as default?

Another possibility is clearing on re-arming - simple and clean.

Clearing alarmed on rearm makes sense, certainly.

revk, 2021-07-15:
I think, at least for now, simplest is to clear these latched states by re-arm.

Closed 2021-07-15.

Thread 35 (2021-07-14):

Pre-alarm timer, and needs to latch

revk, 2021-07-14:
Pre-alarm needs to latch so causes alarm even if triggers go.

Pre-alarm needs timer, with site wide config and code in ESP.

Only cleared by ALARM bits or ARM cleared.

revk, 2021-07-15:
Done

Closed 2021-07-15.

Thread 40 (2021-07-14):

Button disarm/arm

revk, 2021-07-14:
Have option in SS code and management to set a disarm area for exit button.

Have option in SS code and management to set arm area for exit button held down. Configure hold down time.

revk, 2021-07-15:
Added to ESP code

revk, 2021-07-15:
Done

Closed 2021-07-15.

Thread 42 (2021-07-14):

Split settings

revk, 2021-07-14:
Server needs to auto split settings to ensure never too long for mesh relay.

revk, 2021-07-14:
Done

Closed 2021-07-14.

Thread 45 (2021-07-14):

LED

revk, 2021-07-14:
Some devices have one LED, some now have full RGB LED.

Devise and document a meaningful set of LED codes.

revk, 2021-07-16:
Of course, I could cheat and make this configurable :-)

revk, 2021-07-16:
Documented, needs cloud back end.

revk, 2021-07-16:
Make cloud back end

revk, 2021-07-18:
To be honest, this is all overkill - people will not see these LEDs, so leave for now.

revk, 2021-07-18:
Simplify this all - make a slow/fast LED but for RGB make it a single colour to mean something.

revk, 2021-07-18:
Done, and documented

Closed 2021-07-18.

Thread 49 (2021-07-14):

mbedTLS bug

revk, 2021-07-14:
mbedTLS has buffer overrun when using dynamic buffers.

Once fixed, change default config and warnings to recommend dynamic buffers so we can free the certs, etc, once negotiated.

revk, 2021-07-17:
Fix will be to switch to wolfSSL

Closed 2021-07-17.

Thread 50 (2021-07-14):

Document modules

revk, 2021-07-14:
Document each ESP32 device as separate document.

For separate projects, like the ESP32-BatMon, this can be based on that documentation, but specifically documented for its use in solarsystem.

Include pictures, pin outs, and examples of usage.

revk, 2021-07-15:
Done

Closed 2021-07-15.

Thread 51 (2021-07-14):

Fob name

revk, 2021-07-14:
The design allows for a name to be stored in the fob. At present nothing reads that.

Consider reading fob name for arm and disarm so can be logged or even included in SMS for arm/disarm. This will be slower, but not an issue for fob-held for arm. Probably not an issue for disarm.

It means fob provisioning needs to be able to set the name, which is easy.

Tricky to allow name to be changed as fobs are not good at that. Maybe we do a fixed 16 byte name field or some such so easy to overwrite. If reporting for arm/disarm sends name then control system can send a corrected name if it has changed.

Needs SS code to read name, and command to change name.

It may be better to include the name in the access file, that makes it easier to read and change if needed. If so, we may want to adjust the initial read to more data, but overall we allow 256 bytes, so plenty of space for a name. The current design would limit to 15 characters, which is not really an issue for logging. We could even make a name len 0 record in the access file (as opposed to no record) meaning "read the name file", or maybe name len 1 means read the name file, it is this long... Simple enough to prohibit one letter names by having 0 pad if needed.

revk, 2021-07-16:
Ok decided `40` will be name in name file, no writable, and `4X` means name in access file so easy to change.

revk, 2021-07-16:
Done

Closed 2021-07-16.

Thread 60 (2021-07-15):

More settings for devices

revk, 2021-07-15:
There are a load of timers and so on for door control, lock engage timeout, etc.

We should add these to database, settings sending, and web UI so users can find tune as needed.

revk, 2021-07-15:
Done

Closed 2021-07-15.

Thread 66 (2021-07-15):

warning and fault for mesh

revk, 2021-07-15:
Until we get 100% stable we probably want missing devices to count as warning, and below quorum as a fault.

A bell box could consider local fault as an area for which it rings bell...

revk, 2021-07-15:
Fault for no quorum is easy

A persistent warning locally created is not really in system - may want to add something...

Closed 2021-07-15.

Thread 68 (2021-07-15):

Re-test late-arm logic as may have been broken by door logic improvements

revk, 2021-07-15:

revk, 2021-07-16:
Looks like a simple bug.

Closed 2021-07-16.

Thread 71 (2021-07-16):

Slight restructure of mesh reporting cycle

revk, 2021-07-16:
The RevK library handles settings, wifi, OTA and MQTT. It makes sense for it to handle mesh.

This means it handles mesh OTA relaying binary data (even though mesh seems unreliable for some reason), and MQTT relaying mesh messages to/from broker(s).

This works well with other applications which do not have to care that they are direct WiFi or via a mesh (apart from MQTT message size limitations).

However it all handles the alarm reporting cycle, which is inconsistent - this is SS specific, and means messy hooks in to SS.

I suggest leaving ReVk library handling binary (OTA) and MQTT messages, but passing inter device JSON to the application and providing a call to allow sending of inter device JSON. The alarm reporting cycle can them move more cleanly to alarm.c. This then allows it to better handle the missing device logic that is planned without embroiling the RevK library in storing the AWOL flags for devices, etc.

revk, 2021-07-16:
Sorted - ready for more complicated work if needed.

Closed 2021-07-16.

Thread 74 (2021-07-16):

Inconsistent armok/disarmok

revk, 2021-07-16:
In JSON event reporting for a fob event...

We say armok if arming is allowed for the areas we arm.
We say disarmok if disarming is allowed for areas we disarm, and those are armed.

We should do one or the other really. Or an attribute to say we did the arm/disarm.

Maybe we do like we do like elsewhere as a third state, `"armok":null` meaning we are allowed to arm but there is nothing to arm...

ghenry, 2021-07-16:
armstat:

armok
disarmok
null

Something like that or https://vanderlee.github.io/tristate/

Just an enum, no?

revk, 2021-07-16:
They are separate flags, and currently boolean. A fob can be Ok to arm, and Ok to disarm. It is mainly down to the settings in the fob.

I could just report based on fob setting, or report on whether there is any effect, i.e. we are armed, so armok false.

I am thinking armok:true means we are allowed to arm, amok:false means we are not allowed to arm, and amok:null means it is a moot point as we are not armed for what the fob is allowed to do. Or some such.

It's all JSON based, and would be used by a control system decided what to do if the door is not in an autonomous mode.

ghenry, 2021-07-16:
OK, understood.

Is it not better to report what state it is in?

armed: true
armed: false

Thanks.

revk, 2021-07-16:
Well armed is slightly more complex and reported in a different way.
But I think the best one is not send armok if armed. Same with disarmok... No confusion then.

ghenry, 2021-07-16:
That makes more sense and doesn't hurt my head.

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

revk, 2021-07-17:
OK, I am going to write up the logic and implement it separately - this ends up as part of a larger clarification of the operation of fobs at doors.

Closed 2021-07-17.

Thread 77 (2021-07-17):

Possibility of an input button to open a door remotely

revk, 2021-07-17:

revk, 2021-07-19:
Covered by https://github.com/revk/SolarSystem/issues/91

Closed 2021-07-19.

Thread 87 (2021-07-18):

Consider new door control board

revk, 2021-07-18:
Would need to be a bit longer, but would be nice to have push/pull drivers for outputs rather than the solid state relay.

Would be nice for two or maybe even 4 outputs, so the full set of lock, deadlock, error, beep.

Would be nice to have the extra PCB space for RGB LED as well.

Would make one hell of a RIO as well, 6 inputs and 4 outputs.

revk, 2021-07-21:
Stared a more general RIO board with 8 in and 4 out and NFC which may get finished.
Non urgent, closing.

Closed 2021-07-21.

Thread 92 (2021-07-19):

Better control of IoT messages

revk, 2021-07-19:
We have IoT messages linked to door control for open/close/arm/disarm.

This is good for open/close, but for arm/disarm it should be when the arm/disarm is complete. At present it will happen immediately on arm attempt. If used as an indication of arming, e.g. office lights all go off, someone could leave before lights come back on due to arm fail.

Maybe have arm/disarm IoT messages as part of and/set logic.

revk, 2021-07-21:
Moved to arm/set logic

Closed 2021-07-21.

Thread 93 (2021-07-19):

Less clutter to cloud MQTT

revk, 2021-07-19:
Currently the RevK library handles connections to multiple MQTT servers. This is used for secure MQTT to cloud and local IoT MQTT.

The library has _copy functions allow messages to the main MQTT connection and copies to addition connections. These are used with various hot settings to copy messages to local IoT server.

However, this means a lot of clutter to main cloud server which is unnecessary - e.g. every input or output change or door state changed.

- Change library to allow sending to a bit map of servers
- Change MQTT mesh relay to cater for bit map
- Handle "none" as option, simply discarding message
- Change all calls to send to selected servers - only selected necessary messages to cloud server
- Add setting to send all messages to cloud for debug
- Add cloud control of debug setting (probably site wide)

revk, 2021-07-19:
Done

ghenry, 2021-07-19:
I'm sure you're aware, but in your git commit message, if you do Closes #93 then this issue gets closed when you git push. It's a nice way to tie up your work with the issue. Or Fixes #95

https://github.blog/2013-01-22-closing-issues-via-commit-messages/

Thanks.

revk, 2021-07-19:
Thank, I a far from an expert in git.

Closed 2021-07-19.

Thread 95 (2021-07-19):

Fob arm and disarm separate from door control

revk, 2021-07-19:
At present fob arm/disarm is tied to door control.

This could logically not need a door.

This does mean NFC LED controls related to non door control.

revk, 2021-07-22:
We have actually made arm/disarm a level of setting of door control.

Simplest for a non door control access is set door control but no I/O or areas defined.

Closed 2021-07-22.

Thread 96 (2021-07-19):

Looks like power cycle is coming back armed

revk, 2021-07-19:
We should store armed state in flash, are we failing to store disarmed?

revk, 2021-07-19:
Yep, was never setting a non armed state, D'Oh.

Closed 2021-07-19.

Thread 97 (2021-07-19):

Keypad PCB layout does not fit!!!

revk, 2021-07-19:

revk, 2021-07-19:
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

Should now fit - space (top right in image) for where the buzzer goes, and connector (top left in image) should clear the notches and allow cable.

Closed 2021-07-19.

Thread 98 (2021-07-19):

Document keypad UI proposal

revk, 2021-07-19:

revk, 2021-07-19:
- keypadarea to control displayed state in idle screen
- keypadidle for idle text top line
- keypadarm for what can be armed, say hold A key?
- keypadforcearm for what can be force armed, say hold B key?
- ESC key to cancel arm
- keypadpin - PIN to disarm or clear things
- keypaddisarm - what areas can be disarmed
- A/B as arrow so scroll through states
- Eventually more details logs - maybe ENT on a state to access logs, A/B scroll, ESC back
- ESC back to idle, until something changes?

revk, 2021-07-21:
That is pretty much it ^
Revising if/when we add more.

Closed 2021-07-21.

Thread 100 (2021-07-23):

Buffering logs in flash when off line

revk, 2021-07-23:

revk, 2021-08-13:
We ideally need to allow for some 4MB devices. If we report details the root can pick a device to ask as a flash log.

revk, 2022-07-29:
Work on PICO with bigger flash is a start to this - I suspect we want to only log where we have the flash capacity

Thread 101 (2021-07-23):

EV2 provisioning sometimes fails, and needs retry

revk, 2021-07-23:
Odd, sometimes fails on format

revk, 2021-07-23:
It was then failing all fobs until we power cycled the reader/controller. Odd.

revk, 2021-09-18:
Need sample EV2 to test

revk, 2021-09-20:
For now, I'll recommend using EV1.
Re-open when we have new EV2 samples to test.

Closed 2021-09-20.

Thread 106 (2021-08-13):

Control system to allow strong-arm

revk, 2021-08-13:
Actually more likely to be needed as remote than from fob, if someone cannot arm due to an issue, then remote admin may want to force arm for now so issue can be addressed later / next day.

Closed 2021-08-18.

Thread 126 (2021-08-31):

PCB defaults and active low

revk, 2021-08-31:
At president the GPIO settings can be set active low, and defaults configured.

The issue is that if an input is default something that needs active low, you end up with a GPIO fixed as active low even if used for something different. Yes, it can be inverted but then the logic is all wrong. Worse when some GPIO are active low and some are not on the same connector, etc.

Propose an initinvert on the GPIO to allow the default invert status to be set for uses that expect an active low, allowing the GPIO to be set as normal. Obviously some will still be active low if the circuit itself needs this (e.g. LEDs, even relays), but for general PIO they can be set normal.

Closed 2021-08-31.

Thread 142 (2021-09-04):

Somehow can lock up until power cycle

revk, 2021-09-04:
During my various stuff, I got some nodes stuck never reconnecting.

Sounds like we need a last resort - if root and not online reboot say every hour or something?

revk, 2021-09-05:
Added a system to determine that we are alone and off line, and force a reset.

Should avoid reset if part of a mesh and off line.

Closed 2021-09-05.

Thread 147 (2021-09-07):

Clarify high/low on PCB

revk, 2021-09-07:
Best suggestion is PCB pin definitions actually have a label for what "on" and "off" mean, e.g. "low"/"high", "closed"/"open", etc, so these terms can be used on the device GPIO settings.

Closed 2021-09-07.

Thread 149 (2021-09-08):

Door catch issue

revk, 2021-09-08:
Some types of "catch" lock may need to be treated differently to a mag lock or motorised lock.

The issue is that an unlock will only be "cleared" by the door opening from closed, so if unlock done when door already open, it means closing will not lock.

This could be an option, or perhaps a general change as it may be OK with other lock types. Solonoid and motorised locks usually have their own detection of door close to avoid operating when the door is open. Do we need to cater for when this is not the case.

Basically...

Now: Unlock applied when unlock needed and maintained until door opened and then closed again.

Required: Unlock applied only if currently closed, and applied until door is opened. All other cases unlock is not applied.

revk, 2021-09-08:
Actually this is not as simple, we used the output state for unlock to control the lock state (ie locking) I think. But may be ok as long as door open also considered. Need to carefully check the lock state stuff.

Also need to consider case of no open input so unlocked for a time period only.

revk, 2021-09-08:
I have decided to make this a config option.

Closed 2021-09-08.

Thread 150 (2021-09-08):

More consistency in system level fault/tamper

revk, 2021-09-08:
Some way to event log the top level fault and tamper (eg on board tamper switch, nfc reader fault, etc).

And maybe make the state output for these also include an areas set from gpio on that device.

That was way we have events and state that cover both ways for faults and tampers to exist.

revk, 2021-09-15:
We can remove the main board tamper and set up as simple GPIO, so can be configured as normal tamper input.

We can map the NFC GPIO to high GPIO numbers and make input handle that, this means we can remove the NFC bell and tamper handling completely.

We can map the Keypad tamper to a high GPIO number, and remove keypad tamper.

The only remaining top level tamper is then the "lonely" state. This can be removed, and handled in a different way. Maybe also a high GPIO.

The control system needs to understand the high number GPIO mappings and so when selecting these they are listed as NFC 71, etc, and not as GPIO 63. Ideally a common include file to ensure consistency.

This removes all top level tamper state from the system.

Top level faults will have to be considered in a separate way I expect. There are many more, and they have textual explanation.

revk, 2021-09-15:
Changed made to pick up logical inputs, and provide as PCB template options. Have yet to remove existing tamper logic and NFC and keypad specific logic for these, so old and new in parallel for now.

revk, 2021-09-15:
Changes made now to remove system level tamper.

revk, 2021-09-15:
I think the changes will do for now - may revisit the fault stuff later.

revk, 2021-09-17:
Fault inputs moved to logic inputs

Closed 2021-09-15.

Thread 152 (2021-09-08):

Legacy references to organisation and site in session table

Serenity-Whitefall, 2021-09-08:
As per our chat there are a couple of cgi scripts with references to organisation and site fields in session table that no longer exist.

https://github.com/revk/SolarSystem/blob/675953dc5633a2a7e53566aa6f8cab09c8b52533/www/editorganisation.cgi#L14
https://github.com/revk/SolarSystem/blob/675953dc5633a2a7e53566aa6f8cab09c8b52533/www/editorganisation.cgi#L30

https://github.com/revk/SolarSystem/blob/675953dc5633a2a7e53566aa6f8cab09c8b52533/www/editsite.cgi#L27

Closed 2021-09-08.

Thread 153 (2021-09-08):

Initial table creation issue

Serenity-Whitefall, 2021-09-08:
When starting solarsystem for the first time it fails on database initialisation.

>solarsystem@debian:\~/SolarSystem$ ./solarsystem
solarsystem@debian:~/SolarSystem$ solarsystem: Creating database SSKey
solarsystem: Creating database SS
solarsystem: Creating table user
solarsystem: Creating table session
solarsystem: Creating table userorganisation
solarsystem: Creating link userorganisation/user/user
solarsystem: Creating link userorganisation/organisation/organisation
solarsystem: Creating table organisation
solarsystem: Creating table site
solarsystem: Creating table area
solarsystem: Creating table access
solarsystem: Creating table fob
solarsystem: Creating table fobaid
solarsystem: Creating link fobaid/fob/fob
solarsystem: Creating link fobaid/aid/aid
solarsystem: Creating table foborganisation
solarsystem: Creating link foborganisation/fob/fob
solarsystem: Creating link foborganisation/organisation/organisation
solarsystem: Creating table device
solarsystem: Creating table devicegpio
solarsystem: Creating link devicegpio/device/device
solarsystem: Creating link devicegpio/gpio/gpio
solarsystem: Creating table pending
solarsystem: Creating table pcb
solarsystem: Creating table gpio
solarsystem: Creating table aid
solarsystem: Creating table event
solarsystem: Creating field user/username
solarsystem: Creating field user/email
solarsystem: Creating field user/hash
solarsystem: Creating field user/admin
solarsystem: Creating link user/organisation/organisation
solarsystem: Creating link user/site/site
solarsystem: Creating link session/user/user
solarsystem: Creating field session/logintime
solarsystem: Creating field session/expires
solarsystem: Creating field session/loginip
solarsystem: Creating field session/useragent
solarsystem: Creating field userorganisation/userorganisationname
solarsystem: Creating field userorganisation/admin
solarsystem: Creating field userorganisation/caneditorganisation
solarsystem: Creating field userorganisation/caneditaccess
solarsystem: Creating field userorganisation/caneditsite
solarsystem: Creating field userorganisation/canedituser
solarsystem: Creating field userorganisation/caneditdevice
solarsystem: Creating field userorganisation/canviewdevice
solarsystem: Creating field userorganisation/canadoptfob
solarsystem: Creating field userorganisation/caneditfob
solarsystem: Creating field userorganisation/caneditarea
solarsystem: Creating field userorganisation/canarm
solarsystem: Creating field userorganisation/canstrongarm
solarsystem: Creating field userorganisation/candisarm
solarsystem: Creating field userorganisation/canunlock
solarsystem: Creating field userorganisation/canviewlog
solarsystem: Creating field userorganisation/canapi
solarsystem: Creating field userorganisation/apiexpires
solarsystem: Creating field organisation/organisationname
solarsystem: Creating link site/organisation/organisation
solarsystem: Creating field site/sitename
solarsystem: Creating field site/wifissid
solarsystem: Creating field site/wifibssid
solarsystem: Creating field site/wifipass
solarsystem: Creating field site/wifichan
solarsystem: Creating field site/iothost
solarsystem: Creating field site/nomesh
solarsystem: Creating field site/meshid
solarsystem: Creating field site/meshpass
solarsystem: Creating field site/meshkey
solarsystem: Creating field site/meshlr
solarsystem: Creating link site/device/root
solarsystem: Creating field site/smsuser
solarsystem: Creating field site/smspass
solarsystem: Creating field site/hookbearer
solarsystem: Creating field site/hookfob
solarsystem: Creating field site/hookalarm
solarsystem: Creating field site/hookpanic
solarsystem: Creating field site/hookfire
solarsystem: Creating field site/hooktamper
solarsystem: Creating field site/hookwarning
solarsystem: Creating field site/hookfault
solarsystem: Creating field site/engineer
solarsystem: Creating field site/faulted
solarsystem: Creating field site/tampered
solarsystem: Creating field site/alarmed
solarsystem: Creating field site/armed
solarsystem: Creating field site/prearm
solarsystem: Creating field site/prealarm
solarsystem: Creating field site/alarm
solarsystem: Creating field site/nodes
solarsystem: Creating field site/missing
solarsystem: Creating field site/armcancel
solarsystem: Creating field site/alarmdelay
solarsystem: Creating field site/alarmhold
solarsystem: Creating field site/ioteventarm
solarsystem: Creating field site/iotstatesystem
solarsystem: Creating field site/engineer
SQL failed (SS): Duplicate column name 'engineer'
ALTER TABLE `site` ADD `engineer` set('A','B','C','D','E','F','G','H','I','J','K','L','M','N','O','P','Q','R','S','T','U','V','W','X','Y','Z') NOT NULL DEFAULT ''
solarsystem: SQL query failed

A subsequent run seems to finish off the creation...

>solarsystem@debian:\~/SolarSystem$ ./solarsystem
solarsystem@debian:~/SolarSystem$ solarsystem: Creating field site/smsnumber
solarsystem: Creating field site/smsafp1
solarsystem: Creating field site/smsafp2
solarsystem: Creating field site/smsafp3
solarsystem: Creating field site/smsfrom
solarsystem: Creating field site/smsarm
solarsystem: Creating field site/smsdisarm
solarsystem: Creating field site/smsarmfail
solarsystem: Creating field site/smsalarm
solarsystem: Creating field site/smspanic
solarsystem: Creating field site/smsfire
solarsystem: Creating field site/mixand1
solarsystem: Creating field site/mixset1
solarsystem: Creating field site/mixarm1
solarsystem: Creating field site/mixdisarm1
solarsystem: Creating field site/mixand2
solarsystem: Creating field site/mixset2
solarsystem: Creating field site/mixarm2
solarsystem: Creating field site/mixdisarm2
solarsystem: Creating field site/mixand3
solarsystem: Creating field site/mixset3
solarsystem: Creating field site/mixarm3
solarsystem: Creating field site/mixdisarm3
solarsystem: Creating field site/mixand4
solarsystem: Creating field site/mixset4
solarsystem: Creating field site/mixarm4
solarsystem: Creating field site/mixdisarm4
solarsystem: Creating field site/mixand5
solarsystem: Creating field site/mixset5
solarsystem: Creating field site/mixarm5
solarsystem: Creating field site/mixdisarm5
solarsystem: Creating field site/debug
solarsystem: Creating link area/organisation/organisation
solarsystem: Creating link area/site/site
solarsystem: Creating field area/tag
solarsystem: Creating field area/areaname
solarsystem: Creating link access/organisation/organisation
solarsystem: Creating link access/site/site
solarsystem: Creating field access/accessname
solarsystem: Creating field access/enter
solarsystem: Creating field access/arm
solarsystem: Creating field access/strongarm
solarsystem: Creating field access/prop
solarsystem: Creating field access/disarm
solarsystem: Creating field access/expiry
solarsystem: Creating field access/sunfrom
solarsystem: Creating field access/sunto
solarsystem: Creating field access/monfrom
solarsystem: Creating field access/monto
solarsystem: Creating field access/tuefrom
solarsystem: Creating field access/tueto
solarsystem: Creating field access/wedfrom
solarsystem: Creating field access/wedto
solarsystem: Creating field access/thufrom
solarsystem: Creating field access/thuto
solarsystem: Creating field access/frifrom
solarsystem: Creating field access/frito
solarsystem: Creating field access/satfrom
solarsystem: Creating field access/satto
solarsystem: Creating field access/clock
solarsystem: Creating field access/override
solarsystem: Creating field access/armlate
solarsystem: Creating field access/log
solarsystem: Creating field access/count
solarsystem: Creating field access/commit
solarsystem: Creating field fob/provisioned
solarsystem: Creating field fob/capacity
solarsystem: Creating field fob/mem
solarsystem: Creating field fobaid/adopted
solarsystem: Creating field fobaid/ver
solarsystem: Creating link fobaid/access/access
solarsystem: Creating field foborganisation/blocked
solarsystem: Creating field foborganisation/confirmed
solarsystem: Creating field foborganisation/fobname
solarsystem: Creating field foborganisation/expires
solarsystem: Creating link device/device/via
solarsystem: Creating field device/devicename
solarsystem: Creating field device/keypadidle
solarsystem: Creating link device/organisation/organisation
solarsystem: Creating link device/site/site
solarsystem: Creating link device/pcb/pcb
solarsystem: Creating field device/outofservice
solarsystem: Creating field device/iotstatedoor
solarsystem: Creating field device/iotstateinput
solarsystem: Creating field device/iotstateoutput
solarsystem: Creating field device/iotstatefault
solarsystem: Creating field device/iotstatewarning
solarsystem: Creating field device/iotstatetamper
solarsystem: Creating field device/ioteventfob
solarsystem: Creating field device/iotkeypad
solarsystem: Creating field device/nfc
solarsystem: Creating field device/rgb
solarsystem: Creating field device/nfcadmin
solarsystem: Creating field device/nfctrusted
solarsystem: Creating field device/door
solarsystem: Creating field device/doorexitarm
solarsystem: Creating field device/doorexitdisarm
solarsystem: Creating field device/keypad
solarsystem: Creating field device/version
solarsystem: Creating field device/build
solarsystem: Creating field device/chan
solarsystem: Creating field device/bssid
solarsystem: Creating field device/ssid
solarsystem: Creating field device/encryptednvs
solarsystem: Creating field device/secureboot
solarsystem: Creating field device/flash
solarsystem: Creating link device/aid/aid
solarsystem: Creating field device/areaenter
solarsystem: Creating field device/areaarm
solarsystem: Creating field device/areastrongarm
solarsystem: Creating field device/areadisarm
solarsystem: Creating field device/areawarning
solarsystem: Creating field device/areafault
solarsystem: Creating field device/areatamper
solarsystem: Creating field device/areabell
solarsystem: Creating field device/areadeadlock
solarsystem: Creating field device/arealed
solarsystem: Creating field device/areakeypad
solarsystem: Creating field device/online
solarsystem: Creating field device/boot
solarsystem: Creating field device/lastonline
solarsystem: Creating field device/offlinereport
solarsystem: Creating field device/offlinereason
solarsystem: Creating field device/upgrade
solarsystem: Creating field device/progress
solarsystem: Creating field device/address
solarsystem: Creating field device/id
solarsystem: Creating field device/poke
solarsystem: Creating field device/tamper
solarsystem: Creating field device/fault
solarsystem: Creating field device/doorunlock
solarsystem: Creating field device/doorlock
solarsystem: Creating field device/dooropen
solarsystem: Creating field device/doorclose
solarsystem: Creating field device/doorprop
solarsystem: Creating field device/doorexit
solarsystem: Creating field device/doorpoll
solarsystem: Creating field device/doordebounce
solarsystem: Creating field device/dooriotunlock
solarsystem: Creating field devicegpio/type
solarsystem: Creating field devicegpio/invert
solarsystem: Creating field devicegpio/name
solarsystem: Creating field devicegpio/hold
solarsystem: Creating field devicegpio/pulse
solarsystem: Creating field devicegpio/engineer
solarsystem: Creating field devicegpio/faulted
solarsystem: Creating field devicegpio/tampered
solarsystem: Creating field devicegpio/alarmed
solarsystem: Creating field devicegpio/armed
solarsystem: Creating field devicegpio/prearm
solarsystem: Creating field devicegpio/prealarm
solarsystem: Creating field devicegpio/alarm
solarsystem: Creating field devicegpio/doorbell
solarsystem: Creating field devicegpio/warning
solarsystem: Creating field devicegpio/fault
solarsystem: Creating field devicegpio/access
solarsystem: Creating field devicegpio/presence
solarsystem: Creating field devicegpio/tamper
solarsystem: Creating field devicegpio/fire
solarsystem: Creating field devicegpio/panic
solarsystem: Creating field pending/online
solarsystem: Creating field pending/address
solarsystem: Creating field pending/id
solarsystem: Creating field pending/version
solarsystem: Creating field pending/build
solarsystem: Creating field pending/chan
solarsystem: Creating field pending/bssid
solarsystem: Creating field pending/ssid
solarsystem: Creating field pending/encryptednvs
solarsystem: Creating field pending/secureboot
solarsystem: Creating field pending/authenticated
solarsystem: Creating field pending/flash
solarsystem: Creating field pcb/pcbname
solarsystem: Creating field pcb/tamper
solarsystem: Creating field pcb/leda
solarsystem: Creating field pcb/ledr
solarsystem: Creating field pcb/ledg
solarsystem: Creating field pcb/ledb
solarsystem: Creating field pcb/keypadtx
solarsystem: Creating field pcb/keypadrx
solarsystem: Creating field pcb/keypadde
solarsystem: Creating field pcb/keypadre
solarsystem: Creating field pcb/nfctx
solarsystem: Creating field pcb/nfcrx
solarsystem: Creating field pcb/nfcpower
solarsystem: Creating field pcb/nfcred
solarsystem: Creating field pcb/nfcamber
solarsystem: Creating field pcb/nfcgreen
solarsystem: Creating field pcb/nfctamper
solarsystem: Creating field pcb/nfcbell
solarsystem: Creating field pcb/nfccard
solarsystem: Creating link gpio/pcb/pcb
solarsystem: Creating field gpio/pin
solarsystem: Creating field gpio/io
solarsystem: Creating field gpio/inittype
solarsystem: Creating field gpio/initname
solarsystem: Creating field gpio/inithold
solarsystem: Creating field gpio/initpulse
solarsystem: Creating field gpio/initinvert
solarsystem: Creating field gpio/value0
solarsystem: Creating field gpio/value1
solarsystem: Creating link aid/organisation/organisation
solarsystem: Creating link aid/site/site
solarsystem: Creating field aid/aidname
solarsystem: Creating link event/device/device
solarsystem: Creating field event/logged
solarsystem: Creating field event/suffix
solarsystem: Creating field event/data

Closed 2021-09-08.

Thread 154 (2021-09-08):

Code query

Serenity-Whitefall, 2021-09-08:
Initially I was wondering why there is no
>power[i]=0;

after https://github.com/revk/SolarSystem/blob/675953dc5633a2a7e53566aa6f8cab09c8b52533/ESP32/main/output.c#L231 similar to https://github.com/revk/SolarSystem/blob/675953dc5633a2a7e53566aa6f8cab09c8b52533/ESP32/main/output.c#L220

If I'm understanding correctly that is to disregard an output if it's not valid from the task and start functions. That then lead me to wonder about https://github.com/revk/SolarSystem/blob/675953dc5633a2a7e53566aa6f8cab09c8b52533/ESP32/main/output.c#L249

Looks to be logic to only start the task if there is at least 1 valid output. But if there are only power pins it still seems to start the task, is that necessary?

Also do you need a REVK_ERR_CHECK(gpio_hold_en(p)); after https://github.com/revk/SolarSystem/blob/675953dc5633a2a7e53566aa6f8cab09c8b52533/ESP32/main/output.c#L236 ?

Closed 2021-09-08.

Thread 159 (2021-09-10):

Keypad display use design

revk, 2021-09-10:
The current keypad use is to display the areas from summary from root, and PIN entry which does nothing.

Whilst an enhancement for PIN entry to allow arm/disarm is obvious, the display is probably the main use of the keypad.

I suggest we make the keypad display work as a remote from root. The root then advises (via JSON) if beeping, and if LED, and if backlight, and one or more messages to be displayed and cycled through. The root is likely to be in the best position to know what to display.

For this to work the keypad will need to advise the root, via its reports of areas it covers so the root can direct appropriate messages to the keypad.

Further, we need a way for devices that are, for example, producing active fault, tamper, panic, and warning conditions, and any active pre-arm inhibit conditions (i.e. access and presence while pre-arm), to tell root what is causing the condition.

There will need to be limits on what leafs tell root, and what root tells display, probably limited to one JSON message involved, and even then maybe system wide limits due to memory restrictions. This almost certainly needs to therefore apply in a priority order. So active inhibits first (presence, access, tampers), and then active panics, tampers, faults, warnings, so that most important always apply and can be picked for display.

revk, 2021-09-15:
It may be keypad display messages would work better as an area specific log. The beeping needs to relate to active events, but, for example, after a pre-arm fail, you want to be able to check keypad for what caused the inhibit, even though you are no longer trying to arm. As such it may make sense for keypad to hold a number of log type events (with timestamps)...

revk, 2021-09-16:
Events are not via root, so easier to capture for display messages now...

revk, 2021-09-16:
OK, events via root, nice, but I am not convinced we should do this as a log. I think a status is better.

revk, 2021-09-16:
OK, next step is making display show list of texts that it gets from root. Simple. How root decides on list is the more complex issue, and could, initially, be simple status like now.

revk, 2021-09-17:
Update now sends all input reports to root, and root makes display list, and root sends display to keypad, and keypad shows.

Needs improvement, separate issue.

Closed 2021-09-17.

Thread 161 (2021-09-11):

Setting alarm and lock forced condition

revk, 2021-09-11:
Seeing issue with lock forced, should not be forced, but not cleanly inhibiting alarm set either... May be nothing, but worth checking.

revk, 2021-09-11:
Given that the lock (dis)engaged and door open can themselves be alarm inputs, it may not be necessary for "lock forced" to be a fault condition in the same way anyway, or may be that it should be configurable. We have a door that can be affected by heat and expand and create lock errors that are transient and not an issue.

Closed 2021-09-14.

Thread 171 (2021-09-24):

Better reporting on arming and arm fail

revk, 2021-09-24:
We event the arm, and an armfail. The arming has details of why, including fob id and name.

The armfail is on the same device that started the arming, as it clears the control_arm setting.

We could make arming record the last set of details from the arm event, and use these when armfail. It could also use these when control_arm is fully cleared to report an armok event.

Obviously if, on the same device, someone does more than one arm (somewhat unlikely) the report will be the latest of these events only.

Further - it may be nice to have an sms for armok/armfail to fob holder, but that would mean number stored in fob if done on device.

We could also log disarm when disarm done?

revk, 2021-09-24:
It may make sense to consider that we are only ever, as an end device, trying to arm, strong-arm, or disarm.

revk, 2021-09-24:
Maybe we only log arm, strong-arm, armfail, disarm, when actually done - holding the JSON from the request until then?

revk, 2021-09-24:
OK, changed to make it event log when done. Overlapping requests are not ideal, but log relates to the last request.

Closed 2021-09-24.

Thread 175 (2021-10-11):

May be useful to allow more door inputs

revk, 2021-10-11:
Rather than fixed 4 in and 4 out make it that any input or output can be linked to a door related function.

This would allow more door functions such as explicit disarm (for key used outputs from some types of lock).

Need to consider if/how multiple inputs or outputs on same function is handed. May make sense for output where say one is inverted. May make sense for input where they do different alarm functions but the same door function.

revk, 2021-10-11:
Config could generate input and output bit maps for each function making it simple to see if the function is defined and if the raw input has any set and what outputs to control.

revk, 2022-06-04:
I suspect we need to define a function code for an input or output as an extra field. We need to make this backwards compatible, knowing not to do this if we are before a certain version. This would then allow each of the special door inputs and outputs to be assigned to multiple inputs or outputs. Multiple outputs is logically simple. Multiple inputs needs to be an or of the non idle state really, e.g. any door open input means door open, any exit button input means exit button pressed, same for lock disengaged, deadlock disengaged. Logging should identify the named input(s) used ideally so you can have separate logged triggers.

In addition we may want to add a "manual" operation input for doors. This would mean delaying door forced event to allow for a delayed manual input trigger from some locks which may electrically happen at around the same time as the lock disengaged input. I suspect the logic would be door forced, delayed reporting, and then changed to a normal door open if the manual input is triggered.

As mentioned, function tags for arm and disarm make sense, and if allowed combined with say an exit button, they could replace the existing special flags for these functions on exit button.

As for the config for this - the back end allows a function on any input/output already, so that needs no change (apart from extra input for manual), but we would need an inputfunc and output function field. This could be a simple int for a function number, with the default 0 meaning no special function. This does beg the question as to whether an input or output should be able to be attached to more than one function? Maybe a string of letters which are actually bit fields? Needs some consideration.

Any older device would have existing fixed assignments, and newer version would instead have function tags on inputs/outputs instead.

revk, 2022-06-04:
Actually, arm/disarm (and strongarm) probably should be area sets associated with an input rather than a "door function".

And use, a field set of letters makes sense for the inputfunc and outputfunc, e.g. (L)lock, (D)eadlock, (C)lose, (E)xit, (M)anual, for inputs, and (L)ock, (D)eadlock, (B)eep, (E)rror, outputs. This does, of course, also remove the "silent" mode setting as you simply don't set a beep output.

revk, 2022-06-05:
Interesting, input has arm/strongarm/disarm area sets. So I must have done that already. Once this can be set in parallel to an exit button, we won't need some of the special cases.

revk, 2022-06-06:
I have added input and output "function" records which are bit field uint8_t, and functions to test any/any inputs and set all outputs against function codes. Next step is config and ability to send these. Once done, then the change to door control logic to use these new settings.

Closed 2022-06-12.

Thread 184 (2022-01-16):

Memory leak?

Serenity-Whitefall, 2022-01-16:
https://github.com/revk/SolarSystem/blob/b17ef467bc8be78533f6f216191b6a4629d5daec/solarsystem.c#L992-L1003

I think this sql_free_result at line 1000 doesn't want to be inside the else.

Also I'm not sure of the purpose of line 994 "deviceid = v". It gets overwritten in line 998 and if there wasn't a result returned then it would return from the function at line 1002 anyway?

revk, 2022-01-16:
I agree on the free, that looks like a leek. Setting deviceid may be used later anyway as it has wider scope even after the return.

ghenry, 2022-01-16:
Since thus us an open source project you should put in. Coverity auto scan. Very helpful. See here https://github.com/SentryPeer/SentryPeer/actions/runs/1704107864/workflow

revk, 2022-01-16:
No idea how you do that...

ghenry, 2022-01-16:
Sign up:

https://scan.coverity.com/users/sign_up

Add your project.

Get your key from the bottom of that page.

Add it to https://github.com/revk/SolarSystem/settings/secrets/actions like
attached.

then create this file in a .github/worksflow folder in your repo:

https://github.com/SentryPeer/SentryPeer/blob/main/.github/workflows/coverity-scan.yml

Change these lines:

https://github.com/SentryPeer/SentryPeer/blob/main/.github/workflows/coverity-scan.yml#L57
https://github.com/SentryPeer/SentryPeer/blob/main/.github/workflows/coverity-scan.yml#L36
https://github.com/SentryPeer/SentryPeer/blob/main/.github/workflows/coverity-scan.yml#L64

etc.

That's it.

Want me to do a fork and PR for you? You do the sign up bit and get your
Project Token from the Settings page in Coverity.

Thanks.

revk, 2022-01-16:
Yeh, a PR would be easiest for me as I have never done that! Give me a mo.

revk, 2022-01-16:
Ok not finding the settings, sorry, not trying to be thick here!

ghenry, 2022-01-16:
Settings on GitHub or Coverity?

revk, 2022-01-16:
Coverity - I have account settings. It has a thing asking me to add projects...

revk, 2022-01-16:
Ok I added solar system on there

revk, 2022-01-16:
Ah, Ok I have a token.

ghenry, 2022-01-16:
Cool. Are you going to figure it out using the example SentryPeer one?

revk, 2022-01-16:
Somewhat out of my depth with this one, to be honest. I don't even see a .github directory let alone workflow, so I assume I have to make them. Happy to take any help I can get!

ghenry, 2022-01-16:
Yeah, create that folder and file in your local git repo and then commit
etc.

It will then show up here:

https://github.com/revk/SolarSystem/actions

You'll need to read the yml file and update it on how to build your project
as if you're on a Ubuntu machine. Ubuntu containers come with these
installed:

https://github.com/actions/virtual-environments/blob/main/images/linux/Ubuntu2004-Readme.md

Also, other things you can do for reporting issues:

https://github.com/SentryPeer/SentryPeer/tree/main/.github/ISSUE_TEMPLATE

and the free analysis tools from Github:

https://github.com/SentryPeer/SentryPeer/tree/main/.github/workflows

https://github.com/SentryPeer/SentryPeer/blob/main/.github/workflows/codeql-analysis.yml

revk, 2022-01-16:
OK on debian... I may try and catch up with this later...

ghenry, 2022-01-16:
Feel free to give me repo access and add me to the coverity project
and I'll set it all up for you. Then revoke my project access.
Probably easiest :)

Closed 2022-01-16.

Thread 187 (2022-02-14):

Keypad PIN entry flakey

revk, 2022-02-14:
Very hard too pin down, but PIN entry not always working.

Also, noticed sometimes extra input on start of PIN entry, so keypad input itself is slightly flakey, but even when exact PIN entered correctly with no extra *s shown it could still fail until next reset.

Also, noticed the iot logging for keys not working?

revk, 2022-02-14:
- Fixed iotkeypad as was not being set.
- Fixed keypad entry - much simpler
- Fixed PIN check - was not terminated so extra digits ever would linger in the PIN, e.g. 88888 then 1234 looked like 12348.

Closed 2022-02-14.

Thread 189 (2022-03-14):

Improve GPS time sync

revk, 2022-03-14:
Some reporting for signal, e.g. number of sats, as otherwise you can find GPS loses any sync, but because of battery it holds clock which could drift. It has fault for no GPS module, but needs some warning for no GPS sync so maybe extra logical input for such. Obviously as only used for clock sync only needs to report if no signal at all or something meaning clock not reliable.

revk, 2022-03-14:
OK added new GPSWarn set when no sats seen.

Closed 2022-03-14.

Thread 190 (2022-03-14):

s/w upgrade does not relay right file

revk, 2022-03-14:
In mixed environment with ESP32-WROOM and ESP32-PICO, the upgrade done via  root node will be the root node's URL not the leaf node's and so wrong code can be loaded.

revk, 2022-03-14:
OK I think I have it now.

Thread 197 (2022-06-12):

Making one device out of server reboots all

revk, 2022-06-12:
We change meshmax based on number out of service so they all reboot.

revk, 2022-06-12:
Have separate meshexpect for alerting and make meshmax be max devices for site regardless of in/out service.

revk, 2022-06-12:
Needs second commit once devices updated so they know meshexpect.

Closed 2022-06-12.

Thread 201 (2022-07-28):

Auto arm

revk, 2022-07-28:
It may be useful to have an automatic arm feature, i.e. a time of day when it arms, or at least tries to.

No idea if this needs to be per area, or needs a set of areas to auto arm.

revk, 2022-07-28:
I have created a Timer1 which is a logical input, active for 1 minute at a specified time. This can be configured to do something like any other input.

Closed 2022-07-28.

Thread 203 (2022-07-29):

ESP32 temperature

revk, 2022-07-29:
Read and log temperature, even show on control pages

revk, 2022-07-29:
Ok I am not sure if the basic ESP32 has a temp sensor or not now.

Closed 2022-07-29.

Thread 206 (2022-08-22):

Disarm / presence race

revk, 2022-08-22:
Need to improve case where disarm and presence at same time trip pre-alarm...

revk, 2023-03-22:
I believe this is all fixed now

Closed 2023-03-22.

Thread 207 (2022-12-07):

Multi occupancy site issues

revk, 2022-12-07:
Setting a classic two floor working where some robes arm/disarm/enter one floor and some the other, but both can work the lobby.

It is not working. Fobs allowed to disarm one floor could not enter or disarm if the other floor was armed.

Needs checking, fixing if a bug, and documenting as an example.

Thread 210 (2022-12-11):

Additional security

revk, 2022-12-11:
I have been almost paranoid about the enrolment of new blank fobs. If someone was to fake a card, they could get the keys for a whole site.

This is an inherent risk with the DESFire. It was a bit theoretical, but with things like a flipper zero, it becomes a lot easier. Indeed I have put in a feature request to emulate a new blank DESFire EV1 and show keys - which seems to fit with a pen-test device.

But I had an idea of one small improvement, which, with a bit of care, could be backwards compatible.

At present the AID used has a key used for the whole site. But what if the key was actually the card UID encrypted using the site key. We get the UID up front and so can make the keys to use on the fly in the reader.

It would mean that if you emulate a card you get keys, but only keys for that UID. The same key would not work for another UID, and you could not enrol an existing UID.

It is a risk still, as the key on the UID you have made would allow you to change the underlying security settings on that fob, and hope to be quick enough to allow access before it was corrected by the system. Indeed, we could log such changes when something other than just expiry refresh as added security.

But you would not get keys allowing you to make other card UIDs, or to access other cards to make changes on other cards.

I am not sure how much it is worth while doing this as the compromise even on one card is enough to allow some access.

But it is such a simple change that it seems like it may be worth considering - and as I say, in a backwards compatible way.

It probably means, at the same time, implementing a key roll over in the linux side. The readers already have key roll over logic if sent new and old keys. The trick would be to add a flag saying the keys are "indirect", and we can then roll over a site from current to new logic in controlled ways.

revk, 2023-04-09:
Incorporated in to issue #226

Closed 2023-04-09.

Thread 212 (2022-12-20):

Debounce PN532 inputs

revk, 2022-12-20:
Seeing very occasional tamper input when clearly not chance of tamper switch tripping, so simple debounce needed.

revk, 2022-12-20:
Looks like may have been red herring as looks like sensor in question had a dry joint, but a simple debounce does no harm.

Closed 2022-12-20.

Thread 215 (2023-01-13):

DoorFault input

revk, 2023-01-13:
We have some types of door fault, or lock fault, status, including exit button stuck.

Maybe these should be flagged as a new logical input.

Thread 217 (2023-02-24):

Devices can be left in pending table

revk, 2023-02-24:
Looks like it relates to provisioning of a previously provisioned device. Should be simple enough to fix.

Closed 2023-02-24.

Thread 218 (2023-03-22):

Pulsed output on either edge

revk, 2023-03-22:
We have pulsed output, ie only active for a specific period.

However some locks need separate pulsed LOCK and UNLOCK. Rather than making a distinct LOCK output type we could have UNLOCK with and inverted pulsed output. Perhaps using a signed timer for this, negative meaning pulse the “off” state and revert to “on” after timer.

Closed 2023-03-28.

Thread 219 (2023-03-22):

Better provisioning of new controllers

revk, 2023-03-22:
Currently connects to pre-set SSID/password.

Could be built with AP mode and WiFi config - but only until it is provisioned when AP mode is disabled.

One delete it should be reset to have AP mode again for sale.

revk, 2023-03-28:
Closing for now as this means a major change to library logic which currently does not do AP mode when configured for mesh logic.

May want change to manual to explain maybe simple mobile hotspot as way to get on line and switched to right wifi.

Closed 2023-03-28.

Thread 220 (2023-03-23):

Consider choice of connector on controller

revk, 2023-03-23:
Can we try pluggable screw terminals in the same space?

Look in to circuit design options that still allow space saving SPOX connectors but allow alternatives as well.

revk, 2023-03-28:
Pheonix Contact seem a good compromise, no crimp tool needed but pluggable.

only board not done is keypad as no space, so supply with plug and leads to solder.

Closed 2023-03-28.

Thread 223 (2023-03-28):

Better MQTT setup as part of provisioning

revk, 2023-03-28:
In line with easier provisioning, allow insecure 1883 which simple sends the setting for secure connect (`mqttcert`) to get a reconnect.

Yes this opens man in the middle but as the next stage to assign a client cert should only be done from trusted local IP this should be pretty safe.

it allows simple set up from WiFi AP mode without knowing the cert and simple deport to other controller (which does not set a cert).

revk, 2023-03-28:
Obviously change default factory reset of ESP32 to expect this (as well as allowing AP mode)

Closed 2023-03-28.

Thread 224 (2023-03-28):

Edge input logic for multiple (or) inputs

revk, 2023-03-28:
When, for example, multiple exit buttons, handle button stuck per button and still allow a working exit button.

At present it is aggregate of inputs.

One way to handle this would be the pulsed “input” logic so the stuck input is seen as logically no longer active after a while. This is a previous issue which was never done but now has a practical use case. However it would hide that the input is stuck and make diagnosis really difficult.

So maybe this needs some “edge” logic for aggregated inputs more generally such as “exit” button. Indeed exit button may be the only one?

We report name of input now, from the function, maybe always report most recent name and we can see name changed as new trigger when needed.

Closed 2023-03-29.

Thread 234 (2023-05-04):

feature: time profiles for doors

relaystar, 2023-05-04:
ie this door should be unlocked between these times on these days of the week

revk, 2024-02-21:
Slightly messy possibly fix, you can set a "TIMER" input on some devices, actually any devices, only one timer so far (maybe I make a second one). And you can set that, like any input, to change the armed state of a zone. You can use that zone to control door open.

I use to "arm" a door zone at 10pm, but have a button to manually arm sooner, on a Shelly I4.

It is not day of week specific as yet.

Thread 235 (2023-05-18):

feature: fob metadata

relaystar, 2023-05-18:
being able to store more information about the fob, the person that fob has been assigned to would be very useful.

Arbitrary key:value pairs would be best, but otherwise fields like:

- firstname
- lastname
- username (ie to key with another system such as an ldap)
- email address
- department
- status (ie permenant, visitor, contractor etc.)

These would be useful when doing things like:

- viewing logs
- searching for a user to block when they loose a fob
- setting expiry on all of 1 type of card, for instance visitor badges.

revk, 2023-05-18:
Given https://www.kalzumeus.com/2010/06/17/falsehoods-programmers-believe-about-names/ I am inclined to go for "fullname" as a simple text field to be honest. But yes, I'll look next week.

revk, 2023-05-18:
Actually, considering the "Arbitrary key:value pairs" and given this is all done as JSON (in logs and on posts to third party servers) it could be a general JSON object format "userdata" field perhaps. Would that make sense?

relaystar, 2023-05-18:
> Actually, considering the "Arbitrary key:value pairs" and given this is all done as JSON (in logs and on posts to third party servers) it could be a general JSON object format "userdata" field perhaps. Would that make sense?

Yes, that's a bit more work to display, filter, update etc. but it does allow more flexibility in the long term.

Thread 236 (2023-05-22):

updating the 'name' of a fob doesn't work on its own

relaystar, 2023-05-22:
If you update _only_ the name of a fob in the management system, it continues to log with the previous name, until you do something more drastic, such as change the access rights.

revk, 2023-05-22:
It should log with what is on the fob.

It can take time to update fob. If use is too brief it does not.

You can force updates but makes access slower.

But usually after one or two uses the fob will have updated.

Closed 2023-05-23.

Thread 239 (2023-08-15):

More GPIOs

revk, 2023-08-15:
The current design allows for GPIOs: 0, 2, 4, 5, 7, 8, 12, 13, 14, 15, 16, 17, 18, 19, 20, 21, 22, 23, 25, 26, 27, 32, 33, 34, 35, 36, and 39.

These specifically related to the ESP32 S1. However, with ESP32-S3 builds, this needs changing. The ESP32-S3 has GPIOs 0-48 (with some that are unusable).

# GPIO 48

The current code uses an 8 bit value or GPIO, with top bit for *set* and next for *inverted*, leaving 0-63. This is enough for S3, except for the fact that the general inputs have special cases for GPIOs 48 to 63. GPIO 48-55 are mapped to the eight NFC GPIOPs, and 56-63 (as well as inverted 56-63) are mapped to logical inputs such as `NFCFault`, etc. This means GPIO 48 clashes.

The obvious change is to move to 16 bits, with top bit for *set*, and next for *inverted* we could add other port specific bits such as *pull-down* (which is currently bodged in to `inputfunc`) and so on. This would easily allow more than enough GPIOs, so suggesting at least 0-255 for future proofing. We could also make *logical* GPIOs a prefix such as `L` rather than simply using otherwise unused GPIO numbers.

The downside is this is a change to the PCB table and existing code all at the same time. We could, perhaps, map new GPIOs to old based on version number of device. This is probably worth doing in the long run.

# Module table

Another change that makes sense is to have a table defining which GPIOs are usable for which module, and assigning a module to the PCB table entries. This would then restrict which PCBs are available to a device, so as to avoid mistakes, and keep the GPIO selections sensible.

Even so, the GPIO selection could be improved rather than just a big pull down.

# Short term fix

One short term fix is don't use GPIO 48, but the current S3 Access board in production uses it for NFC.

A short term fix for now is allowing all GPIOs 0-47 everywhere, and allowing 48 for anything other than `input`. This would allow GPIO 48 for NFC.

revk, 2023-08-15:
Database changes for all GPIOs done.

Internal port validity checks on module code for S1/S3 done.

Port duplicate checks will fall foul of P30 NFC clash with GPIO 48... Needs working out.

revk, 2023-08-15:
Ready for testing on new S3 Access board later this week.

revk, 2023-09-07:
OK, working now - but is the simple solution of allowing extra ports where there is no clash with special port functions.

Closed 2023-09-07.
