revk/SolarSystem/Reader532/Reader532.ino

// RFID Card reader for Solar System
// ESP-12F based for use with PN532

// Wiring for ESP-12F
// PN531 connnections (in addition to GND/3V3)
// GPIO13 MOSI
// GPIO12 MISO
// GPIO14 SCK (CLK)
// GPIO16 SDA (SS)

#define HOLDTIME 3000
#define RELEASETIME 1000

#include <ESP8266RevK.h>

ESP8266RevK revk(__FILE__, __DATE__ " " __TIME__);

#include <PN532_SPI.h>
#include "PN532.h"

PN532_SPI pn532spi(SPI, 16);
PN532 nfc(pn532spi);

boolean app_setting(const char *setting, const byte *value, size_t len)
{ // Called for settings retrieved from EEPROM
  return false; // Done
}

boolean app_cmnd(const char*suffix, const byte *message, size_t len)
{ // Called for incoming MQTT messages
  return false;
}

void setup()
{
  Serial.begin(115200);
  nfc.begin();

  uint32_t versiondata = nfc.getFirmwareVersion();
  if (! versiondata) {
    Serial.println("Didn't find PN53x board");
    while (1); // halt
  }
  Serial.printf("Version %u\n", versiondata);
  nfc.setPassiveActivationRetries(1);
  nfc.SAMConfig();
}

static byte lastuid[7] = {}, lastlen = 0;
void report(const char *tag)
{
  char tid[15];
  int n;
  for (n = 0; n < lastlen && n * 2 < sizeof(tid); n++)sprintf(tid + n * 2, "%02X", lastuid[n]);
  revk.stat(tag, tid);
}

void loop()
{
  revk.loop();

  long now = (millis() ? : 1); // Allowing for wrap, and using 0 to mean not set
  static long cardcheck = 0;
  if ((int)(cardcheck - now) < 0)
  {
    cardcheck = now + 100;
    static long first = 0;
    static long last = 0;
    static boolean held = false;
    byte uid[7] = {}, uidlen = 0;
    if (nfc.readPassiveTargetID(PN532_MIFARE_ISO14443A, uid, &uidlen))
    {
      last = now;
      if (!first || uidlen != lastlen || memcmp(lastuid, uid, uidlen))
      {
        if (held)
          report("gone");
        first = now;
        held = false;
        memcpy(lastuid, uid, lastlen = uidlen);
        report("id");
      } else if (!held && first && (int)(now - first) > HOLDTIME)
      {
        held = true;
        report("held");
      }
    } else if (last && (int)(now - last) > RELEASETIME)
    {
      if (held)
        report("gone");
      first = 0;
      last = 0;
      held = false;
    }
  }
}
