revk/SolarSystem/ESP32/main/gps.c

// GPS time reference
// Copyright © 2019-22 Adrian Kennard, Andrews & Arnold Ltd. See LICENCE file for details. GPL 3.0
static const char TAG[] = "gps";
#include "SS.h"

#include "desfireaes.h"
#include "alarm.h"
#include "gps.h"
#include <driver/uart.h>
#include <driver/gpio.h>

uint8_t gpsseen = 0;            // Have we seen any data
uint8_t gpslocked = 0;          // Do we have a current time lock
uint8_t gpsfixed = 0;           // Do we have a location lock
uint8_t gpstime = 0;            // Remote GPS time
uint8_t gpsp = 255,             // Counts of sats, 255 so we pick up change to 0 and do NoSats
   gpsl = 0,
   gpsa = 0;                    // Sats in view
uint32_t gpslast = 0;           // Last status update
double gpslat = 0,
   gpslon = 0;

const char *
gps_send_status (const char *why)
{
   jo_t j = jo_make (NULL);
   if (gpsfixed)
   {
      jo_litf (j, "lat", "%lf", gpslat);
      jo_litf (j, "lon", "%lf", gpslon);
   }
   if (gpsp)
      jo_int (j, "GPS", gpsp);
   if (gpsa)
      jo_int (j, "Galileo", gpsa);
   if (gpsl)
      jo_int (j, "GLONASS", gpsl);
   if (why)
      jo_string (j, "reason", why);
   const char *err = alarm_event (gpsfixed ? "fix" : gpslocked ? "clock" : "lost", &j, iotgps);
   if (!err)
      gpslast = uptime ();
   return err;
}

static void
nmea (char *data)
{
   if (*data != '$' || data[1] != 'G' || !data[2] || !data[3] || !data[4] || !data[5])
      return;                   // Recommended Minimum Position Data
   if (iotgps)
      ESP_LOGI (TAG, "<%s", data);      // Debug
   if (!gpsseen)
   {
      void send (const char *msg)
      {
         uint8_t c = 0;
         for (int i = 1; msg[i]; i++)
            c ^= msg[i];
         char csum[6];
         sprintf (csum, "*%02X\r\n", c);
         uart_write_bytes (gpsuart, msg, strlen (msg));
         uart_write_bytes (gpsuart, csum, 6);
         ESP_LOGI (TAG, ">%s%.3s", msg, csum);
      }
      send ("$PMTK255,1");      // Enable PPS
      send ("$PMTK256,1");      // Enable timing product mode (PPS accuracy)
      send ("$PMTK286,1");      // Enable AIC (Active interference cancellation)
      send ("$PMTK314,0,1,0,0,0,1,0,0,0,0,0,0,0,0,0,0,0,1,0");  // RMC, GSV, ZDA
      send ("$PMTK353,1,1,1,1,0");      // GPS, GLONASS, GALILEO(full)
      gpsseen = 1;
   }
   logical_gpio &= ~logical_GPSFault;   // No fault, does not mean locked though
   char *f[13];
   int n = 0;
   char *p = data;
   while (*p && n < sizeof (f) / sizeof (*f))
   {
      while (*p && *p != ',')
         p++;
      if (*p != ',')
         break;
      *p++ = 0;
      f[n++] = p;
   }
   const char *why = NULL;
   if (!strncmp (data + 3, "GSV", 3) && n >= 3)
   {                            // $GPGSV,2,1,05,31,63,226,17,26,47,287,,25,38,104,,20,12,057,,0
      int n = atoi (f[2]);
      if (data[2] == 'P' && gpsp != n)
         gpsp = n;
      if (data[2] == 'L' && gpsl != n)
         gpsl = n;
      if (data[2] == 'A' && gpsa != n)
         gpsa = n;
      int countnow = gpsp + gpsl + gpsa;
      static int countwas = 0;
      int satsnow = gpsp * 10000 + gpsl * 100 + gpsa;
      static int satswas = 0;
      if (satsnow != satswas
          && (countnow > countwas + 3 || countwas > countnow + 3 || (countnow && !gpslast) || gpslast + 3600 < uptime ()))
      {                         // Notable change in number of sats or any change and it has been a while
         why =
            (countwas ? countnow ? "GPS count changed" : "Hello darkness, my old friend (no GPS sats seen)" :
             "I have seen the light (GPS sats seen)");
         if (countnow)
            logical_gpio &= ~logical_GPSNoSats; // sats
         else
            logical_gpio |= logical_GPSNoSats;  // No sats
         if (!revk_link_down ())
         {
            countwas = countnow;        // log what was reported
            satswas = satsnow;  // log what was reported
         }
      }
   }
   if (!strncmp (data + 3, "RMC", 3) && n >= 13)
   {                            // $GPRMC,140305.832,V,,,,,0.00,0.00,140322,,,N,V
      if (*f[11] != 'N' && strlen (f[2]) > 5 && strlen (f[4]) > 6)
      {
         double lat = (f[2][0] - '0') * 10 + (f[2][1] - '0') + strtod (f[2] + 2, NULL) / 60.0;
         if (*f[3] == 'S')
            lat = 0 - lat;
         double lon = (f[4][0] - '0') * 100 + (f[4][1] - '0') * 10 + (f[4][2] - '0') + strtod (f[4] + 3, NULL) / 60.0;
         if (*f[5] == 'W')
            lon = 0 - lon;
         if (!gpsfixed
             || ((lat != gpslat || lon != gpslon)
                 && (lat - gpslat > 1 || gpslat - lat > 1 || lon - gpslon > 1 || gpslon - lon > 1 || gpslast + 3600 < uptime ())))
         {                      // New fix, or moved notably, or moved at all and been a while
            if (!revk_link_down ())
            {
               gpslat = lat;
               gpslon = lon;
            }
            why = (gpsfixed ? "Position changed" : "Position fixed");
            gpsfixed = 1;
            ESP_LOGI (TAG, "Fixed");
         }
         //ESP_LOGI(TAG, "Fix %lf %lf", lat, lon);
      }
   }
   if (!strncmp (data + 3, "ZDA", 3) && n >= 4 && strlen (f[0]) >= 6 && *f[3] == '2')
   {                            // GNZDA,140226.832,14,03,2022,,
      struct tm tm = { 0 };
      tm.tm_year = atoi (f[3]) - 1900;
      tm.tm_mon = atoi (f[2]) - 1;
      tm.tm_mday = atoi (f[1]);
      tm.tm_hour = (f[0][0] - '0') * 10 + (f[0][1] - '0');
      tm.tm_min = (f[0][2] - '0') * 10 + (f[0][3] - '0');
      tm.tm_sec = (f[0][4] - '0') * 10 + (f[0][5] - '0');
      int usec = 0,
         m = 100000;
      if (strlen (f[0]) > 6 && f[0][6] == '.')
      {
         p = f[0] + 7;
         while (*p && m)
         {
            usec = m * (*p++ - '0');
            m /= 10;
         }
      }
      // TODO needs to be timegm but not seeing that in the ESP IDF
      time_t new = mktime (&tm);
      struct timeval tv = { new, usec };
      if (settimeofday (&tv, NULL))
         ESP_LOGE (TAG, "Time set %d failed", (int) new);
      else if (!gpslocked)
      {
         gpslocked = 1;
         why = "Locked";
         ESP_LOGI (TAG, "Locked");
      }
   }
   if (why)
      gps_send_status (why);
}

static void
task (void *pvParameters)
{
   esp_task_wdt_add (NULL);
   pvParameters = pvParameters;
   uint8_t buf[200],
    *p = buf;
   uint64_t timeout = esp_timer_get_time () + 10000000;
   while (1)
   {                            // Get line(s), the timeout should mean we see one or more whole lines typically
      esp_task_wdt_reset ();
      int l = 0;
      if (p < buf + sizeof (buf))
         l = uart_read_bytes (gpsuart, p, buf + sizeof (buf) - p, 100 / portTICK_PERIOD_MS);
      ESP_LOGE(TAG,"l=%d len %d level %d tick %d",l, buf + sizeof (buf) - p,revk_gpio_get(gpsrx),revk_gpio_get(gpstick));
      if (l <= 0)
      {                         // Timeout
         p = buf;               // Start of line again
         if (timeout < esp_timer_get_time ())
         {
            ESP_LOGE (TAG, "GPS timeout");
            logical_gpio |= logical_GPSFault;   // Timeout
            logical_gpio |= logical_GPSNoSats;  // Timeout
            if (gpslocked || gpsfixed)
            {
               gpsseen = 0;
               gpslocked = 0;
               gpsfixed = 0;
               gps_send_status ("Timeout");
            }
            timeout = esp_timer_get_time () + 10000000;
         }
         continue;
      }
      uint8_t *e = p + l;
      p = buf;
      while (p < e)
      {
         uint8_t *l = p;
         while (l < e && *l >= ' ')
            l++;
         if (l == e)
            break;
         if (*p == '$' && (l - p) >= 4 && l[-3] == '*' && isxdigit (l[-2]) && isxdigit (l[-1]))
         {                      // Checksum
            uint8_t c = 0,
               *x;
            for (x = p + 1; x < l - 3; x++)
               c ^= *x;
            if (((c >> 4) > 9 ? 7 : 0) + (c >> 4) + '0' != l[-2] || ((c & 0xF) > 9 ? 7 : 0) + (c & 0xF) + '0' != l[-1])
            {
               ESP_LOGE (TAG, "[%.*s] (%02X)", l - p, p, c);
            } else
            {                   // Process line
               timeout = esp_timer_get_time () + 60000000;
               l[-3] = 0;
               nmea ((char *) p);
            }
         } else if (l > p)
            ESP_LOGE (TAG, "[%.*s]", l - p, p);
         while (l < e && *l < ' ')
            l++;
         p = l;
      }
      if (p < e && (e - p) < sizeof (buf))
      {                         // Partial line
         memmove (buf, p, e - p);
         p = buf + (e - p);
         continue;
      }
      p = buf;                  // Start from scratch
   }
}

const char *
gps_command (const char *tag, jo_t j)
{
   if (!gpstx.set || !gpsrx.set)
      return NULL;              // Not running
   return NULL;
}

void
gps_boot (void)
{
   if (gpstx.set && gpsrx.set)
   {
      const char *e = port_check (gpstx.num, TAG, 0);
      if (!e)
         e = port_check (gpsrx.num, TAG, 1);
      if (!e&&gpstick.set)
         e = port_check (gpstick.num, TAG, 1);
      if (e)
         logical_gpio |= logical_GPSFault;
      else
      {
         esp_err_t err = 0;
         if (!err && !uart_is_driver_installed (gpsuart))
         {
            ESP_LOGE (TAG, "Installing GPS UART driver %d tx %d rx %d", gpsuart,gpstx.num,gpsrx.num);
            err = uart_driver_install (gpsuart, 256, 0, 0, NULL, 0);
         }
         uart_config_t uart_config = {
            .baud_rate = 9600,
            .data_bits = UART_DATA_8_BITS,
            .parity = UART_PARITY_DISABLE,
            .stop_bits = UART_STOP_BITS_1,
            .flow_ctrl = UART_HW_FLOWCTRL_DISABLE,
            .source_clk = UART_SCLK_DEFAULT,
         };
         if (!err)
            err = uart_param_config (gpsuart, &uart_config);
         if (!err)
            err = uart_set_pin (gpsuart, gpstx.num, gpsrx.num, -1, -1);
         if (err)
            ESP_LOGE (TAG, "GPS UART fail %s", esp_err_to_name (err));
      }
   } else if (gpsrx.set || gpstx.set)
      logical_gpio |= logical_GPSFault;
}

void
gps_start (void)
{
   if (gpstx.set && gpsrx.set)
      revk_task (TAG, task, NULL, 4);
}
