revk/SolarSystem/ESP32/main/door.h

// Autonomous door control
// Copyright © 2019-21 Adrian Kennard, Andrews & Arnold Ltd. See LICENCE file for details. GPL 3.0

const char *door_fob (fob_t *); // Check fob
void door_act (fob_t *);        // Action fob (unlock/lock/arm/disarm);
const char *door_unlock (const char *id, const uint8_t * a, const char *why);
const char *door_lock (const char *id, const uint8_t * a, const char *why);
void door_check (void);         // Call if arm state changes
const char *door_state_name (void);
