revk/SolarSystem/ESP32/main/gps.h

// GPS time reference
// Copyright © 2019-22 Adrian Kennard, Andrews & Arnold Ltd. See LICENCE file for details. GPL 3.0

extern uint8_t gpstime;         // Time
extern uint8_t gpsfixed;        // Location
extern uint8_t gpslocked;       // Remote time from GPS
extern double gpslat,
  gpslon;                       // Where
