revk/SolarSystem/(commit log)

2017-07-19 Current version
2017-07-20 Try and carry on if cannot set latency timer - not sure a good idea, but may make non root running easier
2017-07-20 galaxybus.c: Define _GNU_SOURCE
    When compiling under Fedora 26 with GCC 7.1.1 we get the following
    compiler warning
    galaxybus.c: In function ‘bus_init’:
    galaxybus.c:1339:3: warning: implicit declaration of function ‘pipe2’; did you mean ‘pipe’? [-Wimplicit-function-declaration]
    pipe2 (qpipe, O_NONBLOCK); // We check queue anyway an we don't want to risk stalling if app is stalled for some reason and a lot of events
    ^~~~~
    pipe
    PIPE(2) says we need _GNU_SOURCE for pipe2(), which gets rid of the
    above warning.
2017-07-20 alarmpanel: Fix a compiler warning
    With GCC 7.1.1 when compiling with -Wall we get
    cc -Wall -O -o alarmpanel alarmpanel.c galaxybus.o -I. -I../AXL -I ../Dataformat ../AXL/axl.o ../Dataformat/dataformat.o -lcurl -lexpat -pthread -lpopt
    alarmpanel.c: In function ‘keypad_update’:
    alarmpanel.c:2011:37: warning: ‘snprintf’ output truncated before the last format character [-Wformat-truncation=]
    snprintf (l2, 17, "ACTIVE %-10s", state_name[t]);
    ^
    alarmpanel.c:2011:6: note: ‘snprintf’ output 18 or more bytes into a destination of size 17
    snprintf (l2, 17, "ACTIVE %-10s", state_name[t]);
    ^~~~~~~~~~~~~~~~~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
2017-07-21 Added -Wextra, and sorted the warnings, all of which were a waste of time except one (curl GET arguments missing tag)
    [trace.h]
2017-07-22 Blink LED on keypad
2017-07-22 Some blinking LED now we can
2017-07-23 Initial poll retries on configured devices
2017-07-26 Debug for trace.h
2017-07-29 Separated out the new RF RIOs (RFR) and started code for RF devices
2017-10-08 Much more work on web socket interface and web pages
2017-10-08 Keypad buttons working
2017-10-08 Group and state reports and arm/disarm logic
2017-10-08 Odd timeout case so changed pin input to use when_logout timeout
2017-10-09 Neater arm/disarm commands
2017-10-09 Handling edge case of door with no lock better
2017-10-11 Reed Switches
2017-10-12 Fit drag of rotated objects, and allow floorplan in other places. Updated instructions for web socket attributes
2017-10-13 User specific logins for web sockets and controls of actions that user is allowed.
2017-12-28 Allow reset on keypad for groups beyond scope of keypad Fix so arm on keypad only for groups allowed on keypad Allow ESC or login to acknowledge an "alert" so it no longer beeps, but just flashes LED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
2017-12-28 LED looked wrong
2018-07-31 Changed power/battery to warnings
2018-08-21 New door prop authorisation allowed before waiting for door propped timeout
2019-04-23 New PCB layout
2019-04-23 Started on 3D box, needs work
    [Box.scad]
2019-04-23 Revised PCB
2019-04-25 Rename reader, and tweaks to initial keypad code
    [Box.scad]
2019-04-25 Started work on PN532 reader
    [Box.scad]
2019-04-25 PCB layout
2019-04-26 Major restructure of ESP code, two main modules now, SS and Keypad
    [Box.scad]
2019-04-28 Relay code
2019-04-28 PCB for door control
2019-04-28 Revised PCB to use GPIO0/2
2019-04-29 Reader box
    [PN532Outside.scad]
2019-04-29 Invert in manual
    [PN532Outside.scad]
2019-04-29 Missing a screw
    [PN532Outside.scad]
2019-04-29 Not making any difference to power
2019-04-29 Fine tuninng
    [PN532Outside.scad]
2019-04-30 more work...
    [PN532Outside.scad]
2019-04-30 Added beeper
    [PN532Outside.scad]
2019-05-01 Ranger board
2019-05-02 Changed to Elechouse part with proper molex header
    [PN532ElecHouseOutside.scad]
2019-05-02 PIN entry fix
2019-05-03 MIssing device check
2019-05-03 Tweak to use D24V5F3 power supply
2019-05-03 General door control for use with simpler relay board
2019-05-03 Fix key hold logic
    [Keypad.ino]
2019-05-03 Pick up missing devices properly
2019-05-03 Revised layout for better connectors
2019-05-04 New box design for testing
    [MFRC522RobotDynOutside.scad]
2019-05-04 Tidy up some of the PCB and 3D designs
    [MFRC522RobotDynOutside.scad]
2019-05-04 Group on keypad device
2019-05-04 Tidy designs up
    [MFRC522RobotDynOutside.scad]
2019-05-04 Change t back to 0.1
    [MFRC522RobotDynOutside.scad]
2019-05-04 Reed switch
2019-05-05 Revised keypad logic, and tweak pin selection on ESP-12F
2019-05-05 Use solid state relay
2019-05-05 Leaving reset pin
2019-05-07 Tracks were too fine to solder cleanly
2019-05-07 Name on device
2019-05-07 Fix key hold time
    [Keypad.ino]
2019-05-08 4 in / 4 out RIO board design
2019-05-08 Allow output pin GPIO 0
2019-05-08 Improved layout after prototype
2019-05-09 Revised logic for input and output controls, and updated manual and PCB text.
2019-05-09 Integrated relay and beeper in to Output.ino
2019-05-13 New PN532 functions including hold logic
    [PN532ElecHouseOutside.scad]
2019-05-20 Arrrg, you need 0,0 to be clear so you can probe, else you snap off a drill bit.
2019-05-24 LED colour sequence
2019-05-24 Blinking LED
2019-05-25 New Door Control - separate power regulator to avoid simple shorting the reader power as way to force open, and changed Tx/GPIO2 logic so no lock opening when debug serial.
    [FacePlate.scad]
2019-05-26 Some minor tweaks
    [FacePlate.scad, PN532ElecHouseOutside.scad]
2019-05-26 More tamper logic
    [FacePlate.scad, PN532ElecHouseOutside.scad]
2019-05-26 Design for Tamper
    [PN532ElecHouseOutside.scad]
2019-05-26 Better lip design
    [PN532ElecHouseOutside.scad]
2019-05-26 Use GPIO as relay
    [PN532ElecHouseOutside.scad]
2019-05-27 Longer range
    [PN532ElecHouseOutside.scad]
2019-05-28 Revised PCBs
2019-05-28 Various alternative ways to mount a VL53L0x
2019-06-03 LED status
2019-06-04 Various tweaks, new box design.
    [PN532ElecHouse.scad]
2019-06-05 Show reader device name from config
2019-06-05 Library update
    [DoorControlBox.scad, PN532ElecHouse.scad]
2019-06-05 Revised - LED support
    [PN532ElecHouse.scad]
2019-06-05 LED init
2019-06-06 Need to work out why not setting led
2019-06-06 LED pins config
2019-06-07 Fix holes
    [DoorControlBox.scad]
2019-06-08 Re-work after various testing
    [DoorControlBox.scad, PN532ElecHouse.scad]
2019-06-08 Tidy position of cable
    [DoorControlBox.scad]
2019-06-08 V2 is SPI and V3 is HSU
    [12VDoorControlV2Box.scad, 12VDoorControlV3Box.scad]
2019-06-08 Updating for different SPI and HSU versions
2019-06-09 Tweak to take VL53L0X directly
    [12VDoorControlV3Box.scad]
2019-06-09 Thicker walls to avoid breaking around LED and tamper
    [PN532ElecHouse.scad]
2019-06-09 Fix VL53L0X hole placement
    [12VDoorControlV3Box.scad]
2019-06-09 Ranger hole options
    [12VDoorControlV3Box.scad]
2019-06-11 Smoke and mirrors
    [12VDoorControlV3Box.scad]
2019-06-12 Tweak blip LED logic for ESP8266 devices
2019-06-12 Tidy the designs slightly
    [12VDoorControlV3Box.scad, PN532ElecHouse.scad]
2019-06-14 Tidy up documentation of door controller, and various tweaks
    [ExitPlug.scad, vl53l0x.scad]
2019-06-14 Typos and stuff
    [12VDoorControlV3Box.scad]
2019-06-15 Lots of fine tuning and testing
    [12VDoorControlV3Box.scad, ExitPlug.scad, vl53l0x.scad]
2019-06-16 Tweaked after testing
    [12VDoorControlV3Box.scad, ExitPlug.scad]
2019-06-16 Using smaller screw terminals in some places
2019-06-17 Various tidy and testing
    [ExitPlug.scad]
2019-06-18 PWM frequency setting
2019-06-18 Variation using milli-grid 4 pin connector instead
2019-06-19 Box for V4 board
    [12VDoorControlV4Box.scad]
2019-06-22 Tweak V4A board
    [12VDoorControlV4Box.scad]
2019-06-24 Slight tidy for 10k resistor
2019-06-24 Cut start point fix
2019-06-30 Allow system level settings for some device settings
2019-07-02 Test board for door control logic
2019-07-03 Prop beep
2019-07-03 LED setting
2019-07-06 LED pattern fix
2019-07-07 Edge case
2019-07-14 LED pattern error
2019-07-14 New doors
    [Door.scad]
2019-07-14 Tweak artwork
    [Door.scad]
2019-07-15 New door states
    [Door.scad]
2019-07-15 LED pattern change
2019-07-16 Fix edge case
2019-07-17 New erraccess code, and fix LED
2019-07-18 Door state track better
2019-07-19 LED on card use
2019-07-23 Web door prop auth
2019-07-26 Started work on new relay board, not finished
2019-08-13 ESP32 designs
2019-08-13 Swap back - needs to work on programming head before pin re-assignments
2019-08-15 Started on ESp32
2019-08-15 New ESP32 keypad looks OK
2019-08-15 Swap Tx/Rx to be consistent with controller board
2019-08-16 Rework to clear antenna area, using SMD solid state relay
2019-08-16 Tweak around milligrid pads
2019-08-16 Tweak margins to allow for mounting more easily in 3D printed box
2019-08-18 Reworked to allow for unusable pins - taped over button of ESP32
2019-08-18 Reworded for ESP32, avoiding use of unusable pins, tape over end of ESP32
2019-08-18 Starting ESP32 system
2019-08-18 Make exactly 20mm wide
2019-08-20 Update for ESP32
2019-08-25 Separate manuals for ESP822 and ESP32 based SS modules
2019-08-25 Swap I2C and PN532 to avoid GPI0 boot
2019-08-26 Added from arduino
2019-08-27 New ESP32-PN532 project
2019-08-27 Correct way around for power
2019-08-28 Track over lap fixed
2019-08-29 PCB suggested GPIO
2019-08-29 New V5 case
    [12VDoorControlV5Box.scad]
2019-08-30 Updated for new box design and allowing a pin for GPIO0 when in the box base
    [12VDoorControlV5Box.scad]
2019-08-31 aes1 for new ESP32 units
2019-09-03 Fix initial door state lofic
    [door.c]
2019-10-03 Revised parts and part numbers
    [12VDoorControlV5Box.scad]
2019-10-04 Updated for tight fitting 3D case, and correct resistor value
2019-10-04 Allow edge case for access and opening door
2019-10-06 New 3D library
    [12VDoorControlV5Box.scad]
2019-10-21 PCB design for bell box controller
2019-11-12 New case logic
    [12VDoorControlV5Box.scad]
2019-12-26 Reorganise, but not the underlying issue
    [keypad.c]
2019-12-26 No real change, bug was in library
    [output.c]
2020-01-16 Log power up
2020-05-12 Change default UART
2020-06-23 Send commands on mqtt regardless, leave the door to work out the logic if sensible in current state or not
2021-04-09 New PCB for Keypad
    [Keypad-B_Cu.gbr, Keypad-B_Mask.gbr, Keypad-B_Paste.gbr, Keypad-B_SilkS.gbr, Keypad-Edge_Cuts.gbr, Keypad-F_Cu.gbr, Keypad-F_Mask.gbr, Keypad-F_Paste.gbr]
2021-04-10 Started on the new main PCB
    [Controller.kicad_pcb, Controller.sch, Keypad.sch]
2021-04-12 Started on a PN532 board
    [PN532.kicad_pcb, PN532.sch]
2021-04-12 Closer - not quite tracked yet
    [PN532.kicad_pcb, PN532.sch]
2021-04-12 Tidy tracks
    [PN532.kicad_pcb]
2021-04-13 Tracked, and pretty much ready to try it.
    [PN532-B_Cu.gbr, PN532-B_Mask.gbr, PN532-B_Paste.gbr, PN532-B_SilkS.gbr, PN532-Edge_Cuts.gbr, PN532-F_Cu.gbr, PN532-F_Mask.gbr, PN532-F_Paste.gbr]
2021-04-13 As ordered from PCB Train today...
    [PN532-B_Cu.gbr, PN532-B_Mask.gbr, PN532-B_Paste.gbr, PN532-B_SilkS.gbr, PN532-Edge_Cuts.gbr, PN532-F_Cu.gbr, PN532-F_Mask.gbr, PN532-F_Paste.gbr]
2021-04-13 Fixed crystal
    [PN532-B_Cu.gbr, PN532-B_Mask.gbr, PN532-B_Paste.gbr, PN532-B_SilkS.gbr, PN532-Edge_Cuts.gbr, PN532-F_Cu.gbr, PN532-F_Mask.gbr, PN532-F_Paste.gbr]
2021-04-13 Tweak tracks
    [PN532-B_Cu.gbr, PN532-B_Mask.gbr, PN532-B_Paste.gbr, PN532-B_SilkS.gbr, PN532-Edge_Cuts.gbr, PN532-F_Cu.gbr, PN532-F_Mask.gbr, PN532-F_Paste.gbr]
2021-04-13 Refined tracks.
    [PN532-B_Cu.gbr, PN532-B_Mask.gbr, PN532-B_Paste.gbr, PN532-B_SilkS.gbr, PN532-Edge_Cuts.gbr, PN532-F_Cu.gbr, PN532-F_Mask.gbr, PN532-F_Paste.gbr]
2021-04-13 Reverse tx/rx to match other boards
    [PN532-B_Cu.gbr, PN532-B_Mask.gbr, PN532-B_Paste.gbr, PN532-B_SilkS.gbr, PN532-Edge_Cuts.gbr, PN532-F_Cu.gbr, PN532-F_Mask.gbr, PN532-F_Paste.gbr]
2021-04-13 Tweak GND fill
    [PN532-B_Cu.gbr, PN532-B_Mask.gbr, PN532-B_Paste.gbr, PN532-B_SilkS.gbr, PN532-Edge_Cuts.gbr, PN532-F_Cu.gbr, PN532-F_Mask.gbr, PN532-F_Paste.gbr]
2021-04-13 Smaller GND
    [PN532-B_Cu.gbr, PN532-B_Mask.gbr, PN532-B_Paste.gbr, PN532-B_SilkS.gbr, PN532-Edge_Cuts.gbr, PN532-F_Cu.gbr, PN532-F_Mask.gbr, PN532-F_Paste.gbr]
2021-04-13 Allow cut for I2C
    [PN532-B_Cu.gbr, PN532-B_Mask.gbr, PN532-B_Paste.gbr, PN532-B_SilkS.gbr, PN532-Edge_Cuts.gbr, PN532-F_Cu.gbr, PN532-F_Mask.gbr, PN532-F_Paste.gbr]
2021-04-13 Matching milli-grid pin numbering
    [PN532-B_Cu.gbr, PN532-B_Mask.gbr, PN532-B_Paste.gbr, PN532-B_SilkS.gbr, PN532-Edge_Cuts.gbr, PN532-F_Cu.gbr, PN532-F_Mask.gbr, PN532-F_Paste.gbr]
2021-04-13 Date on copper
    [PN532-B_Cu.gbr, PN532-B_Mask.gbr, PN532-B_Paste.gbr, PN532-B_SilkS.gbr, PN532-Edge_Cuts.gbr, PN532-F_Cu.gbr, PN532-F_Mask.gbr, PN532-F_Paste.gbr]
2021-04-13 Fix 3D view
    [PN532.kicad_pcb]
2021-04-13 Tweak silk screen
    [PN532.kicad_pcb]
2021-04-14 Moved to top
    [Controller.kicad_pcb, Controller.sch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]
2021-04-14 Started layout for controller board
    [Controller.kicad_pcb, Controller.sch]
2021-04-14 Tracked teh controller PCB
    [Controller-B_Cu.gbr, Controller-B_Mask.gbr, Controller-B_Paste.gbr, Controller-B_SilkS.gbr, Controller-Edge_Cuts.gbr, Controller-F_Cu.gbr, Controller-F_Mask.gbr, Controller-F_Paste.gbr]
2021-04-15 Make easier to change to I2C if wanted
    [PN532-B_Cu.gbr, PN532-B_Mask.gbr, PN532-B_Paste.gbr, PN532-B_SilkS.gbr, PN532-Edge_Cuts.gbr, PN532-F_Cu.gbr, PN532-F_Mask.gbr, PN532-F_Paste.gbr]
2021-04-15 QFN40 corners
    [PN532-B_Cu.gbr, PN532-B_Mask.gbr, PN532-B_Paste.gbr, PN532-B_SilkS.gbr, PN532-Edge_Cuts.gbr, PN532-F_Cu.gbr, PN532-F_Mask.gbr, PN532-F_Paste.gbr]
2021-04-15 SImple serial PN532 connection test
    [PN532.kicad_pcb]
2021-04-19 Fix crystal
    [PN532.kicad_pcb, PN532.sch]
2021-04-20 Re-designed for 0804 components
    [PN532-B_Cu.gbr, PN532-B_Mask.gbr, PN532-B_Paste.gbr, PN532-B_SilkS.gbr, PN532-Edge_Cuts.gbr, PN532-F_Cu.gbr, PN532-F_Mask.gbr, PN532-F_Paste.gbr]
2021-04-20 SIlk screen tweak
    [PN532-B_Cu.gbr, PN532-B_Mask.gbr, PN532-B_Paste.gbr, PN532-B_SilkS.gbr, PN532-Edge_Cuts.gbr, PN532-F_Cu.gbr, PN532-F_Mask.gbr, PN532-F_Paste.gbr]
2021-04-20 New LED controls
2021-04-20 Position LEDs neater
    [PN532-B_Cu.gbr, PN532-B_Mask.gbr, PN532-B_Paste.gbr, PN532-B_SilkS.gbr, PN532-Edge_Cuts.gbr, PN532-F_Cu.gbr, PN532-F_Mask.gbr, PN532-F_Paste.gbr]
2021-04-20 Way better silk screen
    [PN532-B_Cu.gbr, PN532-B_Mask.gbr, PN532-B_Paste.gbr, PN532-B_SilkS.gbr, PN532-Edge_Cuts.gbr, PN532-F_Cu.gbr, PN532-F_Mask.gbr, PN532-F_Paste.gbr]
2021-04-20 MOre silk screen
    [PN532-B_Cu.gbr, PN532-B_Mask.gbr, PN532-B_Paste.gbr, PN532-B_SilkS.gbr, PN532-Edge_Cuts.gbr, PN532-F_Cu.gbr, PN532-F_Mask.gbr, PN532-F_Paste.gbr]
2021-04-21 Reworked various bits and added dimensions
    [PN532-B_Cu.gbr, PN532-B_Mask.gbr, PN532-B_Paste.gbr, PN532-B_SilkS.gbr, PN532-Edge_Cuts.gbr, PN532-F_Cu.gbr, PN532-F_Mask.gbr, PN532-F_Paste.gbr]
2021-04-21 Moved PCB to ESP32-PN532 repositary
    [PN532-B_Cu.gbr, PN532-B_Mask.gbr, PN532-B_Paste.gbr, PN532-B_SilkS.gbr, PN532-Edge_Cuts.gbr, PN532-F_Cu.gbr, PN532-F_Mask.gbr, PN532-F_Paste.gbr]
2021-04-21 Changed defaults to match PCB design
2021-04-22 New LED control logic
2021-04-22 Document update for LED
2021-04-22 Added LED
    [Controller.kicad_pcb, Controller.sch]
2021-04-22 New controller layout
    [Controller-B_Cu.gbr, Controller-B_Mask.gbr, Controller-B_Paste.gbr, Controller-B_SilkS.gbr, Controller-Edge_Cuts.gbr, Controller-F_Cu.gbr, Controller-F_Mask.gbr, Controller-F_Paste.gbr]
2021-04-22 Allow number of periods in LED sequence
2021-04-22 Sequence count for LED
2021-04-24 Tidy up LED blink, and added amber blink for non autonomous door control
2021-04-30 Working on case stuff
    [Controller-B_Cu.gbr, Controller-B_Mask.gbr, Controller-B_Paste.gbr, Controller-B_SilkS.gbr, Controller-Edge_Cuts.gbr, Controller-F_Cu.gbr, Controller-F_Mask.gbr, Controller-F_Paste.gbr]
2021-04-30 Updated QR, and added 3D (not finished)
    [Controller-B_Cu.gbr, Controller-B_Mask.gbr, Controller-B_Paste.gbr, Controller-B_SilkS.gbr, Controller-Edge_Cuts.gbr, Controller-F_Cu.gbr, Controller-F_Mask.gbr, Controller-F_Paste.gbr]
2021-04-30 Access controller board
    [Access.kicad_pcb, Access.sch]
2021-04-30 Access control gerber and rill files
    [Access-B_Cu.gbr, Access-B_Mask.gbr, Access-B_Paste.gbr, Access-B_SilkS.gbr, Access-Edge_Cuts.gbr, Access-F_Cu.gbr, Access-F_Mask.gbr, Access-F_Paste.gbr]
2021-04-30 USB 27R added
    [Access-B_Cu.gbr, Access-B_Mask.gbr, Access-B_Paste.gbr, Access-B_SilkS.gbr, Access-Edge_Cuts.gbr, Access-F_Cu.gbr, Access-F_Mask.gbr, Access-F_Paste.gbr]
2021-05-01 Re-layout ready for tracking
    [Access.kicad_pcb, Access.sch]
2021-05-01 Diode so VBUS and 12V don't clash
    [Access-B_Cu.gbr, Access-B_Mask.gbr, Access-B_Paste.gbr, Access-B_SilkS.gbr, Access-Edge_Cuts.gbr, Access-F_Cu.gbr, Access-F_Mask.gbr, Access-F_Paste.gbr]
2021-05-01 Simpler labelling on silk screen
    [Access-B_Cu.gbr, Access-B_Mask.gbr, Access-B_Paste.gbr, Access-B_SilkS.gbr, Access-Edge_Cuts.gbr, Access-F_Cu.gbr, Access-F_Mask.gbr, Access-F_Paste.gbr]
2021-05-01 Track tidy
    [Access-B_Cu.gbr, Access-B_Mask.gbr, Access-B_Paste.gbr, Access-B_SilkS.gbr, Access-Edge_Cuts.gbr, Access-F_Cu.gbr, Access-F_Mask.gbr, Access-F_Paste.gbr]
2021-05-01 Date code
    [Access-B_Cu.gbr, Access-B_Mask.gbr, Access-B_Paste.gbr, Access-B_SilkS.gbr, Access-Edge_Cuts.gbr, Access-F_Cu.gbr, Access-F_Mask.gbr, Access-F_Paste.gbr]
2021-05-01 Tweaked pads
    [Access-B_Cu.gbr, Access-B_Mask.gbr, Access-B_Paste.gbr, Access-B_SilkS.gbr, Access-Edge_Cuts.gbr, Access-F_Cu.gbr, Access-F_Mask.gbr, Access-F_Paste.gbr]
2021-05-01 Tweak, 3D case, and change silk screen a bit
    [Access-B_Cu.gbr, Access-B_Mask.gbr, Access-B_Paste.gbr, Access-B_SilkS.gbr, Access-Edge_Cuts.gbr, Access-F_Cu.gbr, Access-F_Mask.gbr, Access-F_Paste.gbr]
2021-05-01 Redrawn regulator layout
    [Access-B_Cu.gbr, Access-B_Mask.gbr, Access-B_Paste.gbr, Access-B_SilkS.gbr, Access-Edge_Cuts.gbr, Access-F_Cu.gbr, Access-F_Mask.gbr, Access-F_Paste.gbr]
2021-05-02 Moved FT231 to same side as USB to make easier to solder
    [Access-B_Cu.gbr, Access-B_Mask.gbr, Access-B_Paste.gbr, Access-B_SilkS.gbr, Access-Edge_Cuts.gbr, Access-F_Cu.gbr, Access-F_Mask.gbr, Access-F_Paste.gbr]
2021-05-02 Change to regulator block
    [Access.kicad_pcb, Access.sch, Access.stl]
2021-05-02 Regulator modules
    [Access-B_Cu.gbr, Access-B_Mask.gbr, Access-B_Paste.gbr, Access-B_SilkS.gbr, Access-Edge_Cuts.gbr, Access-F_Cu.gbr, Access-F_Mask.gbr, Access-F_Paste.gbr]
2021-05-02 Tweak regulators
    [Access-B_Cu.gbr, Access-B_Mask.gbr, Access-B_Paste.gbr, Access-B_SilkS.gbr, Access-Edge_Cuts.gbr, Access-F_Cu.gbr, Access-F_Mask.gbr, Access-F_Paste.gbr]
2021-05-02 Case needs square corners as OLED has square corners!
    [Access.stl]
2021-05-02 New regulator
    [Controller-B_Cu.gbr, Controller-B_Mask.gbr, Controller-B_Paste.gbr, Controller-B_SilkS.gbr, Controller-Edge_Cuts.gbr, Controller-F_Cu.gbr, Controller-F_Mask.gbr, Controller-F_Paste.gbr]
2021-05-02 Changed to 0603
    [Access-B_Cu.gbr, Access-B_Mask.gbr, Access-B_Paste.gbr, Access-B_SilkS.gbr, Access-Edge_Cuts.gbr, Access-F_Cu.gbr, Access-F_Mask.gbr, Access-F_Paste.gbr]
2021-05-02 Reworked, dated, ready for order
    [Access-B_Cu.gbr, Access-B_Mask.gbr, Access-B_Paste.gbr, Access-B_SilkS.gbr, Access-Edge_Cuts.gbr, Access-F_Cu.gbr, Access-F_Mask.gbr, Access-F_Paste.gbr]
2021-05-03 Reworked spacing of SPOX
    [Access-B_Cu.gbr, Access-B_Mask.gbr, Access-B_Paste.gbr, Access-B_SilkS.gbr, Access-Edge_Cuts.gbr, Access-F_Cu.gbr, Access-F_Mask.gbr, Access-F_Paste.gbr]
2021-05-03 Yet more component tweaks
    [Access-B_Cu.gbr, Access-B_Mask.gbr, Access-B_Paste.gbr, Access-B_SilkS.gbr, Access-Edge_Cuts.gbr, Access-F_Cu.gbr, Access-F_Mask.gbr, Access-F_Paste.gbr]
2021-05-03 Cleaner regulator layout
    [Access-B_Cu.gbr, Access-B_Mask.gbr, Access-B_Paste.gbr, Access-B_SilkS.gbr, Access-Edge_Cuts.gbr, Access-F_Cu.gbr, Access-F_Mask.gbr, Access-F_Paste.gbr]
2021-05-03 Yet more tweaks!
    [Access-B_Cu.gbr, Access-B_Mask.gbr, Access-B_Paste.gbr, Access-B_SilkS.gbr, Access-Edge_Cuts.gbr, Access-F_Cu.gbr, Access-F_Mask.gbr, Access-F_Paste.gbr]
2021-05-03 More updates
    [Access-B_Cu.gbr, Access-B_Mask.gbr, Access-B_Paste.gbr, Access-B_SilkS.gbr, Access-Edge_Cuts.gbr, Access-F_Cu.gbr, Access-F_Mask.gbr, Access-F_Paste.gbr]
2021-05-03 More fettling
    [Access-B_Cu.gbr, Access-B_Mask.gbr, Access-B_Paste.gbr, Access-B_SilkS.gbr, Access-Edge_Cuts.gbr, Access-F_Cu.gbr, Access-F_Mask.gbr, Access-F_Paste.gbr]
2021-05-03 Ready to order
    [Access-B_Cu.gbr, Access-B_Mask.gbr, Access-B_Paste.gbr, Access-B_SilkS.gbr, Access-Edge_Cuts.gbr, Access-F_Cu.gbr, Access-F_Mask.gbr, Access-F_Paste.gbr]
2021-05-04 Added cap for FT231X 3.3V
    [Access-B_Cu.gbr, Access-B_Mask.gbr, Access-B_Paste.gbr, Access-B_SilkS.gbr, Access-Edge_Cuts.gbr, Access-F_Cu.gbr, Access-F_Mask.gbr, Access-F_Paste.gbr]
2021-05-04 Updated connector models and added 0.1uF
    [Access.stl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]
2021-05-04 Solder paste correction
    [Access-B_Cu.gbr, Access-B_Mask.gbr, Access-B_Paste.gbr, Access-B_SilkS.gbr, Access-Edge_Cuts.gbr, Access-F_Cu.gbr, Access-F_Mask.gbr, Access-F_Paste.gbr]
2021-05-04 Moved vias off pads and added date to stencil
    [Access-B_Cu.gbr, Access-B_Mask.gbr, Access-B_Paste.gbr, Access-B_SilkS.gbr, Access-Edge_Cuts.gbr, Access-F_Cu.gbr, Access-F_Mask.gbr, Access-F_Paste.gbr]
2021-05-05 Footprint tweak
    [Access-B_Cu.gbr, Access-B_Mask.gbr, Access-B_Paste.gbr, Access-B_SilkS.gbr, Access-Edge_Cuts.gbr, Access-F_Cu.gbr, Access-F_Mask.gbr, Access-F_Paste.gbr]
2021-05-05 Tidy case
    [Access.stl, Controller.stl]
2021-05-05 Tweak footprints
    [Access-B_Cu.gbr, Access-B_Mask.gbr, Access-B_Paste.gbr, Access-B_SilkS.gbr, Access-Edge_Cuts.gbr, Access-F_Cu.gbr, Access-F_Mask.gbr, Access-F_Paste.gbr]
2021-05-06 Tamper contacts - need to find suitable button or some such.
    [Access-B_Cu.gbr, Access-B_Mask.gbr, Access-B_Paste.gbr, Access-B_SilkS.gbr, Access-Edge_Cuts.gbr, Access-F_Cu.gbr, Access-F_Mask.gbr, Access-F_Paste.gbr]
2021-05-06 Tamper switch
    [Access-B_Cu.gbr, Access-B_Mask.gbr, Access-B_Paste.gbr, Access-B_SilkS.gbr, Access-Edge_Cuts.gbr, Access-F_Cu.gbr, Access-F_Mask.gbr, Access-F_Paste.gbr]
2021-05-06 Manual case design instead
    [Access.scad, Access.stl, Controller.stl]
2021-05-06 Manual for new PCB
2021-05-06 Blink LED amber on held
2021-05-07 Move things about a bit, and add external tamper contacts.
    [Access-B_Cu.gbr, Access-B_Mask.gbr, Access-B_Paste.gbr, Access-B_SilkS.gbr, Access-Edge_Cuts.gbr, Access-F_Cu.gbr, Access-F_Mask.gbr, Access-F_Paste.gbr]
2021-05-07 Fab layer tidy and document
    [Access-B_Cu.gbr, Access-B_Mask.gbr, Access-B_Paste.gbr, Access-B_SilkS.gbr, Access-Edge_Cuts.gbr, Access-F_Cu.gbr, Access-F_Mask.gbr, Access-F_Paste.gbr]
2021-05-07 GPIO for SHDN added
    [Access-B_Cu.gbr, Access-B_Mask.gbr, Access-B_Paste.gbr, Access-B_SilkS.gbr, Access-Edge_Cuts.gbr, Access-F_Cu.gbr, Access-F_Mask.gbr, Access-F_Paste.gbr]
2021-05-07 Major prune of old stuff, all KiCad and ESP32 now.
    [12VDoorControlV2Box.scad, 12VDoorControlV3Box.scad, 12VDoorControlV4Box.scad, 12VDoorControlV5Box.scad, Access.stl, Door.scad, ExitPlug.scad, FacePlate.scad]
2021-05-08 Improve fab diagrams
    [Access-B_Cu.gbr, Access-B_Mask.gbr, Access-B_Paste.gbr, Access-B_SilkS.gbr, Access-Edge_Cuts.gbr, Access-F_Cu.gbr, Access-F_Mask.gbr, Access-F_Paste.gbr]
2021-05-09 Tweak for stencil
    [Access-B_Cu.gbr, Access-B_Mask.gbr, Access-B_Paste.gbr, Access-B_SilkS.gbr, Access-Edge_Cuts.gbr, Access-F_Cu.gbr, Access-F_Mask.gbr, Access-F_Paste.gbr]
2021-05-10 Added 100R on rx/tx for ESD
    [Access-B_Cu.gbr, Access-B_Mask.gbr, Access-B_Paste.gbr, Access-B_SilkS.gbr, Access-Edge_Cuts.gbr, Access-F_Cu.gbr, Access-F_Mask.gbr, Access-F_Paste.gbr]
2021-05-10 Added a BAV99S to protect Tx/Rx from RFID
    [Access-B_Cu.gbr, Access-B_Mask.gbr, Access-B_Paste.gbr, Access-B_SilkS.gbr, Access-Edge_Cuts.gbr, Access-F_Cu.gbr, Access-F_Mask.gbr, Access-F_Paste.gbr]
2021-05-11 Changed inputs
    [Access-B_Cu.gbr, Access-B_Mask.gbr, Access-B_Paste.gbr, Access-B_SilkS.gbr, Access-Edge_Cuts.gbr, Access-F_Cu.gbr, Access-F_Mask.gbr, Access-F_Paste.gbr]
2021-05-11 Updated case
    [Access.scad]
2021-05-11 Paste update
    [Access.kicad_pcb]
2021-05-14 Fix double invert, D'Oh
    [nfc.c]
2021-05-15 Fix Fab drawing
    [Access-B_Cu.gbr, Access-B_Mask.gbr, Access-B_Paste.gbr, Access-B_SilkS.gbr, Access-Edge_Cuts.gbr, Access-F_Cu.gbr, Access-F_Mask.gbr, Access-F_Paste.gbr]
2021-05-15 Regulator updated
    [Keypad-B_Cu.gbr, Keypad-B_Mask.gbr, Keypad-B_Paste.gbr, Keypad-B_SilkS.gbr, Keypad-Edge_Cuts.gbr, Keypad-F_Cu.gbr, Keypad-F_Mask.gbr, Keypad-F_Paste.gbr]
2021-05-15 Power restart working better
2021-05-16 Blink LED
2021-05-18 A&A logo
    [Access-B_Cu.gbr, Access-B_Mask.gbr, Access-B_Paste.gbr, Access-B_SilkS.gbr, Access-Edge_Cuts.gbr, Access-F_Cu.gbr, Access-F_Mask.gbr, Access-F_Paste.gbr]
2021-05-18 Change LED logic
2021-05-19 Fix bugs, and improve logic a bit
    [door.c, nfc.c]
2021-05-19 Some multiple handling for standalone debug LED logic
2021-05-19 power off
2021-05-23 Regulator layout
    [Keypad-B_Cu.gbr, Keypad-B_Mask.gbr, Keypad-B_Paste.gbr, Keypad-B_SilkS.gbr, Keypad-Edge_Cuts.gbr, Keypad-F_Cu.gbr, Keypad-F_Mask.gbr, Keypad-F_Paste.gbr]
2021-05-23 New regulator footprint
    [Access-B_Cu.gbr, Access-B_Mask.gbr, Access-B_Paste.gbr, Access-B_SilkS.gbr, Access-Edge_Cuts.gbr, Access-F_Cu.gbr, Access-F_Mask.gbr, Access-F_Paste.gbr]
2021-05-23 Tweak regulater
    [Access-B_Cu.gbr, Access-B_Mask.gbr, Access-B_Paste.gbr, Access-B_SilkS.gbr, Access-Edge_Cuts.gbr, Access-F_Cu.gbr, Access-F_Mask.gbr, Access-F_Paste.gbr]
2021-05-26 Revised design for six GPIO on inputs (app protected)
    [Access-B_Cu.gbr, Access-B_Mask.gbr, Access-B_Paste.gbr, Access-B_SilkS.gbr, Access-Edge_Cuts.gbr, Access-F_Cu.gbr, Access-F_Mask.gbr, Access-F_Paste.gbr]
2021-05-26 Tidy up
    [Access-B_Cu.gbr, Access-B_Mask.gbr, Access-B_Paste.gbr, Access-B_SilkS.gbr, Access-Edge_Cuts.gbr, Access-F_Cu.gbr, Access-F_Mask.gbr, Access-F_Paste.gbr]
2021-05-26 Flip QR
    [Access-B_Cu.gbr, Access-B_Mask.gbr, Access-B_Paste.gbr, Access-B_SilkS.gbr, Access-Edge_Cuts.gbr, Access-F_Cu.gbr, Access-F_Mask.gbr, Access-F_Paste.gbr]
2021-05-27 power setting
2021-05-27 Updated docs for new PCB layout
    [Access.kicad_pcb]
2021-05-27 Revised mounting hole and logo
    [Access-B_Cu.gbr, Access-B_Mask.gbr, Access-B_Paste.gbr, Access-B_SilkS.gbr, Access-Edge_Cuts.gbr, Access-F_Cu.gbr, Access-F_Mask.gbr, Access-F_Paste.gbr]
2021-05-28 Added some 33pF
    [Access-B_Cu.gbr, Access-B_Mask.gbr, Access-B_Paste.gbr, Access-B_SilkS.gbr, Access-Edge_Cuts.gbr, Access-F_Cu.gbr, Access-F_Mask.gbr, Access-F_Paste.gbr]
2021-06-03 Tidy circuit
    [Keypad-B_Cu.gbr, Keypad-B_Mask.gbr, Keypad-B_Paste.gbr, Keypad-B_SilkS.gbr, Keypad-Edge_Cuts.gbr, Keypad-F_Cu.gbr, Keypad-F_Mask.gbr, Keypad-F_Paste.gbr]
2021-06-07 No reset on blacklist change
    [door.c]
2021-06-08 Was retry with fail set, duh
    [nfc.c]
2021-06-09 Docs, etc
    [Access.kicad_pcb]
2021-06-09 led now json
2021-06-10 Fix settings for dup
    [output.c]
2021-06-10 Cleaner reset and power control for NFC
    [nfc.c]
2021-06-10 Slight tidy
    [Access-B_Cu.gbr, Access-B_Mask.gbr, Access-B_Paste.gbr, Access-B_SilkS.gbr, Access-Edge_Cuts.gbr, Access-F_Cu.gbr, Access-F_Mask.gbr, Access-F_Paste.gbr]
2021-06-12 Start bell box
    [Bell.sch]
2021-06-12 Initially work on Bell box controller
    [Bell-B_Cu.gbr, Bell-B_Mask.gbr, Bell-B_Paste.gbr, Bell-B_SilkS.gbr, Bell-Edge_Cuts.gbr, Bell-F_Cu.gbr, Bell-F_Mask.gbr, Bell-F_Paste.gbr]
2021-06-12 New bell box controller
    [Access.sch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]
2021-06-13 Device setting
2021-06-15 Clean up board, etc
    [Bell-B_Cu.gbr, Bell-B_Mask.gbr, Bell-B_Paste.gbr, Bell-B_SilkS.gbr, Bell-Edge_Cuts.gbr, Bell-F_Cu.gbr, Bell-F_Mask.gbr, Bell-F_Paste.gbr]
2021-06-15 Document new modules
    [Bell-B_Cu.gbr, Bell-B_Mask.gbr, Bell-B_Paste.gbr, Bell-B_SilkS.gbr, Bell-Edge_Cuts.gbr, Bell-F_Cu.gbr, Bell-F_Mask.gbr, Bell-F_Paste.gbr]
2021-06-15 Fix keypad (diode and LED)
    [Bell-B_Cu.gbr, Bell-B_Mask.gbr, Bell-B_Paste.gbr, Bell-B_SilkS.gbr, Bell-Edge_Cuts.gbr, Bell-F_Cu.gbr, Bell-F_Mask.gbr, Bell-F_Paste.gbr]
2021-06-16 New Generic
    [Access.sch]
2021-06-17 Fix startup lock output state logic...
    [output.c]
2021-06-17 Better footprint for solder paste
    [Access-B_Cu.gbr, Access-B_Mask.gbr, Access-B_Paste.gbr, Access-B_SilkS.gbr, Access-Edge_Cuts.gbr, Access-F_Cu.gbr, Access-F_Mask.gbr, Access-F_Paste.gbr]
2021-06-17 Minor tweeak
    [Bell-B_Cu.gbr, Bell-B_Mask.gbr, Bell-B_Paste.gbr, Bell-B_SilkS.gbr, Bell-Edge_Cuts.gbr, Bell-F_Cu.gbr, Bell-F_Mask.gbr, Bell-F_Paste.gbr]
2021-06-17 Minor tweak
    [Bell-B_Cu.gbr, Bell-B_Mask.gbr, Bell-B_Paste.gbr, Bell-B_SilkS.gbr, Bell-Edge_Cuts.gbr, Bell-F_Cu.gbr, Bell-F_Mask.gbr, Bell-F_Paste.gbr]
2021-06-18 Pads around USB
    [Access-B_Cu.gbr, Access-B_Mask.gbr, Access-B_Paste.gbr, Access-B_SilkS.gbr, Access-Edge_Cuts.gbr, Access-F_Cu.gbr, Access-F_Mask.gbr, Access-F_Paste.gbr]
2021-06-18 Stupid error, FET upside down
    [Bell-B_Cu.gbr, Bell-B_Mask.gbr, Bell-B_Paste.gbr, Bell-B_SilkS.gbr, Bell-Edge_Cuts.gbr, Bell-F_Cu.gbr, Bell-F_Mask.gbr, Bell-F_Paste.gbr]
2021-06-19 New generic board
2021-06-19 Updated footprints
    [Access-B_Cu.gbr, Access-B_Mask.gbr, Access-B_Paste.gbr, Access-B_SilkS.gbr, Access-Edge_Cuts.gbr, Access-F_Cu.gbr, Access-F_Mask.gbr, Access-F_Paste.gbr]
2021-06-19 Changed to push/pull drive up to 18V using ISL89410
    [Bell-B_Cu.gbr, Bell-B_Mask.gbr, Bell-B_Paste.gbr, Bell-B_SilkS.gbr, Bell-Edge_Cuts.gbr, Bell-F_Cu.gbr, Bell-F_Mask.gbr, Bell-F_Paste.gbr]
2021-06-19 MOve around a bit
    [Bell-B_Cu.gbr, Bell-B_Mask.gbr, Bell-B_Paste.gbr, Bell-B_SilkS.gbr, Bell-Edge_Cuts.gbr, Bell-F_Cu.gbr, Bell-F_Mask.gbr, Bell-F_Paste.gbr]
2021-06-19 RGB LED
    [Bell-B_Cu.gbr, Bell-B_Mask.gbr, Bell-B_Paste.gbr, Bell-B_SilkS.gbr, Bell-Edge_Cuts.gbr, Bell-F_Cu.gbr, Bell-F_Mask.gbr, Bell-F_Paste.gbr]
2021-06-19 Clean up
    [Bell-B_Cu.gbr, Bell-B_Mask.gbr, Bell-B_Paste.gbr, Bell-B_SilkS.gbr, Bell-Edge_Cuts.gbr, Bell-F_Cu.gbr, Bell-F_Mask.gbr, Bell-F_Paste.gbr]
2021-06-20 Tidy for board order
    [Bell-B_Cu.gbr, Bell-B_Mask.gbr, Bell-B_Paste.gbr, Bell-B_SilkS.gbr, Bell-Edge_Cuts.gbr, Bell-F_Cu.gbr, Bell-F_Mask.gbr, Bell-F_Paste.gbr]
2021-06-20 Start manual
    [Bell.scad]
2021-06-22 deporting devices
2021-06-23 Major rework of command logic for all JSON
    [SS.c, door.c, input.c, keypad.c, nfc.c, output.c, ssdatabase.c]
2021-06-25 First stage permissions check...
2021-06-26 fob provisioning device trust flag
2021-06-26 Based PCB edit
2021-06-26 PCB template
2021-06-27 Insist on pin name
2021-06-27 External slot create
2021-06-27 Close slot
2021-06-27 Not working, but logic for local thraed
    [solarsystem.c, ssmqtt.c, ssmqtt.h]
2021-06-28 adopt by device
2021-06-28 device adopt
2021-06-29 Major rework, not finished
    [fobcommand.c, solarsystem.c, ssafile.c]
2021-06-29 Cut down a lot of device access
2021-06-30 Stupid afile read error
    [door.c]
2021-06-30 de-blacklist on confirmation
2021-06-30 New LED logic
2021-07-02 aid0key edge case
2021-07-02 Some fixes for new build env
    [door.h]
2021-07-02 Arm late setting
2021-07-03 Change of fob tags, separating arm and disarm functions
2021-07-03 Updated fob tags, separating arm and disarm
2021-07-03 Mystery solved... Issue with forced lock when deadlocked - fix when we do proper area logic for deadlock
    [door.c, nfc.c]
2021-07-04 Pick up nfc error on remote dx
    [fobcommand.c, message.c, nfc.c]
2021-07-04 Revert LED at end of NFC
    [nfc.c]
2021-07-05 can for --device fixed
    [can.c]
2021-07-05 Device ID in outgoing MQTT to allow for relayed IDs
2021-07-06 Back to linked ESP32-Revk for dev work
2021-07-06 New footprints
    [Access.kicad_pcb, Bell.kicad_pcb, Keypad.kicad_pcb]
2021-07-07 Parent device logic
2021-07-07 Time relay
2021-07-07 Time relay - next is mqtt
2021-07-08 MQTT server mode uses too much memory - revisit if/when we have WROVER device. Considering alternatives for now.
    [SS.c]
2021-07-09 Less solder on USB connector
    [Access-B_Cu.gbr, Access-B_Mask.gbr, Access-B_Paste.gbr, Access-B_SilkS.gbr, Access-Edge_Cuts.gbr, Access-F_Cu.gbr, Access-F_Mask.gbr, Access-F_Paste.gbr]
2021-07-10 SOlder paste
    [Access-B_Cu.gbr, Access-B_Mask.gbr, Access-B_Paste.gbr, Access-B_SilkS.gbr, Access-Edge_Cuts.gbr, Access-F_Cu.gbr, Access-F_Mask.gbr, Access-F_Paste.gbr]
2021-07-10 Fix LED
    [Bell-B_Cu.gbr, Bell-B_Mask.gbr, Bell-B_Paste.gbr, Bell-B_SilkS.gbr, Bell-Edge_Cuts.gbr, Bell-F_Cu.gbr, Bell-F_Mask.gbr, Bell-F_Paste.gbr]
2021-07-10 Starting on multi device login
2021-07-10 Multi device site connects
2021-07-12 Relayed upgrade
2021-07-13 Device areas
2021-07-13 Button case
2021-07-14 Fixing some logic on states
    [SS.c, alarm.c, alarm.h]
2021-07-15 iFix edit PCB for new settings
2021-07-15 Exit arm/disarm
2021-07-15 Door timers
2021-07-15 Change names to avoid clash
    [alarm.c]
2021-07-15 site level arm iot
2021-07-15 Name in arm/disarm
2021-07-16 sub online devices
2021-07-16 Avoid self sub again
    [alarm.c]
2021-07-16 LED started - needs cloud
2021-07-16 Bx arm override
2021-07-16 Default ledarea
2021-07-16 ledarea default
2021-07-17 Changes to event logging for arm/disarm
2021-07-18 Strong arm logic on fob
2021-07-18 Tidy and remake box
    [Access-B_Cu.gbr, Access-B_Mask.gbr, Access-B_Paste.gbr, Access-B_SilkS.gbr, Access-Edge_Cuts.gbr, Access-F_Cu.gbr, Access-F_Mask.gbr, Access-F_Paste.gbr]
2021-07-18 Cleaner LED
2021-07-18 Document area.led
2021-07-18 Edit area LED
2021-07-18 area led for any device
2021-07-18 LED tweak
2021-07-18 LED hole
    [Access.scad, Access.stl]
2021-07-18 Space for spox
    [Access.scad, Access.stl]
2021-07-18 Initial status from devices on connect
2021-07-19 Fixed STL
    [Bell.scad, Bell.stl]
2021-07-19 Pad size
    [Keypad.kicad_pcb, Keypad.sch]
2021-07-19 New design that should actually fit
    [Keypad-B_Cu.gbr, Keypad-B_Mask.gbr, Keypad-B_Paste.gbr, Keypad-B_SilkS.gbr, Keypad-Edge_Cuts.gbr, Keypad-F_Cu.gbr, Keypad-F_Mask.gbr, Keypad-F_Paste.gbr]
2021-07-19 New PCB
2021-07-20 Beeps and LED
2021-07-20 ESC was staying for timeout
2021-07-20 PIN entry
2021-07-20 Start on uber RIO
    [RIO.kicad_pcb, RIO.sch]
2021-07-21 door check on arm clear
2021-07-22 Try toggling LED to be clear
2021-07-22 remote arm/disarm
2021-07-22 Tidy remote arm/disarm
2021-07-22 Issues with * target
    [solarsystem.c]
2021-07-23 Handle new device
2021-07-23 Tidying device deport
2021-07-24 Pre-arm pick up events
2021-07-31 Copy PCB
2021-07-31 Can edit PCB
2021-07-31 Changed to FET for SHDN, and changed to RGB LED
    [Access-B_Cu.gbr, Access-B_Mask.gbr, Access-B_Paste.gbr, Access-B_SilkS.gbr, Access-Edge_Cuts.gbr, Access-F_Cu.gbr, Access-F_Mask.gbr, Access-F_Paste.gbr]
2021-08-02 Device and site off line sms
2021-08-05 Tweak keypad design
    [Keypad-B_Cu.gbr, Keypad-B_Mask.gbr, Keypad-B_Paste.gbr, Keypad-B_SilkS.gbr, Keypad-Edge_Cuts.gbr, Keypad-F_Cu.gbr, Keypad-F_Mask.gbr, Keypad-F_Paste.gbr]
2021-08-05 Cut out
    [Keypad-B_Cu.gbr, Keypad-B_Mask.gbr, Keypad-B_Paste.gbr, Keypad-B_SilkS.gbr, Keypad-Edge_Cuts.gbr, Keypad-F_Cu.gbr, Keypad-F_Mask.gbr, Keypad-F_Paste.gbr]
2021-08-05 arm clearing latched
2021-08-06 Update solder paste
    [Access-B_Cu.gbr, Access-B_Mask.gbr, Access-B_Paste.gbr, Access-B_SilkS.gbr, Access-Edge_Cuts.gbr, Access-F_Cu.gbr, Access-F_Mask.gbr, Access-F_Paste.gbr]
2021-08-06 Cleaner power on for NFC
2021-08-14 Get ready for card print logic
2021-08-14 Start on print logic
2021-08-14 Prints from clueless
2021-08-15 New print logic
2021-08-21 Report Tx issues too
    [keypad.c]
2021-08-22 Drop submodule ESP32/components/esp-wolfssl
2021-08-26 Stencil adjust
    [Access-B_Cu.gbr, Access-B_Mask.gbr, Access-B_Paste.gbr, Access-B_SilkS.gbr, Access-Edge_Cuts.gbr, Access-F_Cu.gbr, Access-F_Mask.gbr, Access-F_Paste.gbr]
2021-08-26 Report period was wrong
    [alarm.c]
2021-08-27 Strong arm
2021-08-27 View device
2021-08-27 View device logic
2021-08-27 Don't update site for device out of service
2021-09-01 Was sending IoT arm/disarm from every node
2021-09-04 Area impacts devices
2021-09-04 site commands would go to out of service devices, doh
2021-09-06 Remove the channel switch attempts as they don't work
2021-09-06 Tidy arm/disarm logging
2021-09-07 Don't arm when door open, but we'll allow strong arm
2021-09-07 Cleaner switching
2021-09-07 Blinky red on prearm (bodge)
    [nfc.c]
2021-09-09 Handle site switch
2021-09-09 Not SMS implied arm/disarm/strongarm, fixed
    [alarm.c]
2021-09-10 Allow more missed reports before considering off line - mesh can be slow at times
    [alarm.c]
2021-09-10 Try and avoid linking to mesh when out of service
    [solarsystem.c]
2021-09-10 Cleaner pre-arm logic
2021-09-11 Force arm cancel delay
2021-09-14 Handle edge case
2021-09-15 Fix some checks, seems to be working, now to remove old way...
    [SS.c, SS.h, input.c, ssdatabase.c]
2021-09-16 Start on new event logging and relaying system
2021-09-16 Show configured root device first
2021-09-17 Device summary status (back end)
2021-09-18 Database text size fix
    [ssdatabase.c]
2021-09-20 Sounder issue, but need to address why we have unreliable comms anyway...
    [keypad.c]
2021-09-21 Fit in with 10 minute WiFi stuck restart on devices
    [solarsystem.c]
2021-09-22 Prop is unauthorised prop
2021-09-22 Fixed logical prop
2021-09-22 Keypad change, A=arm B=strongarm ESC=cancel
2021-09-22 Don't arm when showing messages!
2021-09-23 Handle event with unknown fob without crashing
    [solarsystem.c]
2021-09-24 Avoid tabs as they SMS as 8 bit not 7
    [solarsystem.c]
2021-09-24 Change arm/disarm/armfail/strongarm event logging
2021-09-24 Reworked logic to be cleaner when overlapping requests
    [alarm.c]
2021-10-12 Don't log a simple timeout as a fail fob access
    [solarsystem.c]
2021-10-12 Added new input modes arm/strong/disarm, and changed strongarm to strong everywhere to limit field name length
2021-12-29 Kicad 6
    [Access.kicad_pcb, Access.kicad_sch, Access.sch]
2021-12-31 Kicad tidy
    [Keypad-B_Cu.gbr, Keypad-B_Mask.gbr, Keypad-B_Paste.gbr, Keypad-B_Silkscreen.gbr, Keypad-Edge_Cuts.gbr, Keypad-F_Cu.gbr, Keypad-F_Mask.gbr, Keypad-F_Paste.gbr]
2021-12-31 More KiCad 6 tweaks
    [Access-B_Cu.gbr, Access-B_Mask.gbr, Access-B_Paste.gbr, Access-B_Silkscreen.gbr, Access-Edge_Cuts.gbr, Access-F_Cu.gbr, Access-F_Mask.gbr, Access-F_Paste.gbr]
2022-01-02 Curvy tracks
    [Access-B_Cu.gbr, Access-B_Mask.gbr, Access-B_Paste.gbr, Access-B_Silkscreen.gbr, Access-Edge_Cuts.gbr, Access-F_Cu.gbr, Access-F_Mask.gbr, Access-F_Paste.gbr]
2022-01-03 Tidy for latest board
2022-01-16 Add arm, strong-arm and disarm to the API.
2022-01-16 Unsure of correct fix #183
    [solarsystem.c]
2022-01-20 Reworked for variable regulators
    [Access-B_Cu.gbr, Access-B_Mask.gbr, Access-B_Paste.gbr, Access-B_Silkscreen.gbr, Access-Edge_Cuts.gbr, Access-F_Cu.gbr, Access-F_Mask.gbr, Access-F_Paste.gbr]
2022-01-20 Update date, and tidy
    [Access-B_Cu.gbr, Access-B_Mask.gbr, Access-B_Paste.gbr, Access-B_Silkscreen.gbr, Access-Edge_Cuts.gbr, Access-F_Cu.gbr, Access-F_Mask.gbr, Access-F_Paste.gbr]
2022-01-22 Re issue #180 now handle JSON with id and afile for door access actions
    [door.c, door.h, nfc.c, nfc.h]
2022-01-25 Rework for PSu change
    [Keypad-B_Cu.gbr, Keypad-B_Mask.gbr, Keypad-B_Paste.gbr, Keypad-B_Silkscreen.gbr, Keypad-Edge_Cuts.gbr, Keypad-F_Cu.gbr, Keypad-F_Mask.gbr, Keypad-F_Paste.gbr]
2022-01-25 New PSU
    [Bell-B_Cu.gbr, Bell-B_Mask.gbr, Bell-B_Paste.gbr, Bell-B_Silkscreen.gbr, Bell-Edge_Cuts.gbr, Bell-F_Cu.gbr, Bell-F_Mask.gbr, Bell-F_Paste.gbr]
2022-02-07 Tidy artwork
    [Access-B_Cu.gbr, Access-B_Mask.gbr, Access-B_Paste.gbr, Access-B_Silkscreen.gbr, Access-Edge_Cuts.gbr, Access-F_Cu.gbr, Access-F_Mask.gbr, Access-F_Paste.gbr]
2022-02-18 Artwork update
    [Bell-B_Cu.gbr, Bell-B_Mask.gbr, Bell-B_Paste.gbr, Bell-B_Silkscreen.gbr, Bell-Edge_Cuts.gbr, Bell-F_Cu.gbr, Bell-F_Mask.gbr, Bell-F_Paste.gbr]
2022-02-18 GPS module started
    [GPS-B_Cu.gbr, GPS-B_Mask.gbr, GPS-B_Paste.gbr, GPS-B_Silkscreen.gbr, GPS-Edge_Cuts.gbr, GPS-F_Cu.gbr, GPS-F_Mask.gbr, GPS-F_Paste.gbr]
2022-02-19 Initial tracking
    [GPS-B_Cu.gbr, GPS-B_Mask.gbr, GPS-B_Paste.gbr, GPS-B_Silkscreen.gbr, GPS-Edge_Cuts.gbr, GPS-F_Cu.gbr, GPS-F_Mask.gbr, GPS-F_Paste.gbr]
2022-02-19 Tidy up a bit
    [GPS-B_Cu.gbr, GPS-B_Mask.gbr, GPS-B_Paste.gbr, GPS-B_Silkscreen.gbr, GPS-Edge_Cuts.gbr, GPS-F_Cu.gbr, GPS-F_Mask.gbr, GPS-F_Paste.gbr]
2022-02-19 Corrected jumpers any curvied up the tracks a bit
    [GPS-B_Cu.gbr, GPS-B_Mask.gbr, GPS-B_Paste.gbr, GPS-B_Silkscreen.gbr, GPS-Edge_Cuts.gbr, GPS-F_Cu.gbr, GPS-F_Mask.gbr, GPS-F_Paste.gbr]
2022-02-19 Tidy up GPIOs in use, and retrack
    [GPS-B_Cu.gbr, GPS-B_Mask.gbr, GPS-B_Paste.gbr, GPS-B_Silkscreen.gbr, GPS-Edge_Cuts.gbr, GPS-F_Cu.gbr, GPS-F_Mask.gbr, GPS-F_Paste.gbr]
2022-02-19 Adjusted GPIO again, and redrawn
    [GPS-B_Cu.gbr, GPS-B_Mask.gbr, GPS-B_Paste.gbr, GPS-B_Silkscreen.gbr, GPS-Edge_Cuts.gbr, GPS-F_Cu.gbr, GPS-F_Mask.gbr, GPS-F_Paste.gbr]
2022-02-19 Tidy scheamtic
    [GPS.kicad_sch]
2022-02-19 Date on silkscreen
    [GPS-B_Cu.gbr, GPS-B_Mask.gbr, GPS-B_Paste.gbr, GPS-B_Silkscreen.gbr, GPS-Edge_Cuts.gbr, GPS-F_Cu.gbr, GPS-F_Mask.gbr, GPS-F_Paste.gbr]
2022-02-20 Rework for VBUS and DC working
    [GPS-B_Cu.gbr, GPS-B_Mask.gbr, GPS-B_Paste.gbr, GPS-B_Silkscreen.gbr, GPS-Edge_Cuts.gbr, GPS-F_Cu.gbr, GPS-F_Mask.gbr, GPS-F_Paste.gbr]
2022-02-20 Updated for VBUS and GPIO changes
    [Access-B_Cu.gbr, Access-B_Mask.gbr, Access-B_Paste.gbr, Access-B_Silkscreen.gbr, Access-Edge_Cuts.gbr, Access-F_Cu.gbr, Access-F_Mask.gbr, Access-F_Paste.gbr]
2022-02-20 VBUS update
    [Bell-B_Cu.gbr, Bell-B_Mask.gbr, Bell-B_Paste.gbr, Bell-B_Silkscreen.gbr, Bell-Edge_Cuts.gbr, Bell-F_Cu.gbr, Bell-F_Mask.gbr, Bell-F_Paste.gbr]
2022-02-22 New Access2 PCB tracked
    [Access2-B_Cu.gbr, Access2-B_Mask.gbr, Access2-B_Paste.gbr, Access2-B_Silkscreen.gbr, Access2-Edge_Cuts.gbr, Access2-F_Cu.gbr, Access2-F_Mask.gbr, Access2-F_Paste.gbr]
2022-02-22 Start on new Bell2 board
    [Access2.kicad_sch, Bell2.kicad_pcb, Bell2.kicad_sch]
2022-02-22 Started Keypad2 - may scrap it though.
    [Access2.kicad_pcb, Access2.kicad_sch, Bell2.kicad_pcb, Bell2.kicad_sch, Keypad2.kicad_pcb, Keypad2.kicad_sch]
2022-02-22 Bell2 - tracks and DRC
    [Bell2-B_Cu.gbr, Bell2-B_Mask.gbr, Bell2-B_Paste.gbr, Bell2-B_Silkscreen.gbr, Bell2-Edge_Cuts.gbr, Bell2-F_Cu.gbr, Bell2-F_Mask.gbr, Bell2-F_Paste.gbr]
2022-02-22 Tweaked some GPIO, and added to documentation
    [Access2-B_Cu.gbr, Access2-B_Mask.gbr, Access2-B_Paste.gbr, Access2-B_Silkscreen.gbr, Access2-Edge_Cuts.gbr, Access2-F_Cu.gbr, Access2-F_Mask.gbr, Access2-F_Paste.gbr]
2022-02-28 Fix BOM
    [GPS.csv, GPS.kicad_pcb, GPS.kicad_sch]
2022-02-28 started logic for GPS, and trying to get PICO working
2022-03-01 Was blocking pins myself, fixed, and better error report
    [SS.c]
2022-03-01 Swapped two pins over concerns that GPIO20 may be limited usage
    [GPS-B_Cu.gbr, GPS-B_Mask.gbr, GPS-B_Paste.gbr, GPS-B_Silkscreen.gbr, GPS-Edge_Cuts.gbr, GPS-F_Cu.gbr, GPS-F_Mask.gbr, GPS-F_Paste.gbr]
2022-03-01 New 3D models (needs work on Access2 still)
    [Access.stl, Access2.scad, Access2.stl, Bell.stl, Bell2.scad, Bell2.stl, GPS.scad, GPS.stl]
2022-03-02 Silkscreen tidy
    [GPS.kicad_pcb]
2022-03-03 Reverted GPIOs, no issue
    [GPS-B_Cu.gbr, GPS-B_Mask.gbr, GPS-B_Paste.gbr, GPS-B_Silkscreen.gbr, GPS-Edge_Cuts.gbr, GPS-F_Cu.gbr, GPS-F_Mask.gbr, GPS-F_Paste.gbr]
2022-03-03 Tidy silk screen and 3D
    [GPS.kicad_pcb]
2022-03-03 Bugger, tx/rx swapped
    [Keypad2-B_Cu.gbr, Keypad2-B_Mask.gbr, Keypad2-B_Paste.gbr, Keypad2-B_Silkscreen.gbr, Keypad2-Edge_Cuts.gbr, Keypad2-F_Cu.gbr, Keypad2-F_Mask.gbr, Keypad2-F_Paste.gbr]
2022-03-03 New 3D models
    [Bell.scad, Bell.stl, Bell2.scad, Bell2.stl, GPS.scad, GPS.stl]
2022-03-05 Tweak, getting ready to order
    [Keypad2-B_Cu.gbr, Keypad2-B_Mask.gbr, Keypad2-B_Paste.gbr, Keypad2-B_Silkscreen.gbr, Keypad2-Edge_Cuts.gbr, Keypad2-F_Cu.gbr, Keypad2-F_Mask.gbr, Keypad2-F_Paste.gbr]
2022-03-05 New cases
    [Access2.scad, Access2.stl, Bell.scad, Bell.stl, Bell2.scad, Bell2.stl, GPS.scad, GPS.stl]
2022-03-06 New GPS module
    [GPS-B_Cu.gbr, GPS-B_Mask.gbr, GPS-B_Paste.gbr, GPS-B_Silkscreen.gbr, GPS-Edge_Cuts.gbr, GPS-F_Cu.gbr, GPS-F_Mask.gbr, GPS-F_Paste.gbr]
2022-03-06 Bell box with GPS add on
    [Bell2-B_Cu.gbr, Bell2-B_Mask.gbr, Bell2-B_Paste.gbr, Bell2-B_Silkscreen.gbr, Bell2-Edge_Cuts.gbr, Bell2-F_Cu.gbr, Bell2-F_Mask.gbr, Bell2-F_Paste.gbr]
2022-03-06 GPS tweaks
    [Bell2-B_Cu.gbr, Bell2-B_Mask.gbr, Bell2-B_Paste.gbr, Bell2-B_Silkscreen.gbr, Bell2-Edge_Cuts.gbr, Bell2-F_Cu.gbr, Bell2-F_Mask.gbr, Bell2-F_Paste.gbr]
2022-03-06 Pos on regulator
    [GPS-B_Cu.gbr, GPS-B_Mask.gbr, GPS-B_Paste.gbr, GPS-B_Silkscreen.gbr, GPS-Edge_Cuts.gbr, GPS-F_Cu.gbr, GPS-F_Mask.gbr, GPS-F_Paste.gbr]
2022-03-07 New battery holder
    [GPS-B_Cu.gbr, GPS-B_Mask.gbr, GPS-B_Paste.gbr, GPS-B_Silkscreen.gbr, GPS-Edge_Cuts.gbr, GPS-F_Cu.gbr, GPS-F_Mask.gbr, GPS-F_Paste.gbr]
2022-03-07 Updated carework
    [Access2.scad, Access2.stl, Bell.scad, Bell.stl, Bell2.scad, Bell2.stl, Bell2GPS.scad, Bell2GPS.stl]
2022-03-07 Workign on cases
    [Access2.scad, Access2.stl, Bell.scad, Bell.stl, Bell2.scad, Bell2.stl, Bell2GPS.scad, Bell2GPS.stl]
2022-03-09 New edge
    [Access2.stl]
2022-03-09 Revised 3D
    [Access2.scad, Access2.stl, Bell.scad, Bell.stl, Bell2.scad, Bell2.stl, Bell2GPS.scad, Bell2GPS.stl]
2022-03-10 DRC tidy
    [Access2-B_Cu.gbr, Access2-B_Mask.gbr, Access2-B_Paste.gbr, Access2-B_Silkscreen.gbr, Access2-Edge_Cuts.gbr, Access2-F_Cu.gbr, Access2-F_Mask.gbr, Access2-F_Paste.gbr]
2022-03-10 DRC cleanup
    [Bell2-B_Cu.gbr, Bell2-B_Mask.gbr, Bell2-B_Paste.gbr, Bell2-B_Silkscreen.gbr, Bell2-Edge_Cuts.gbr, Bell2-F_Cu.gbr, Bell2-F_Mask.gbr, Bell2-F_Paste.gbr]
2022-03-10 DRC tweaks
    [Bell2-B_Cu.gbr, Bell2-B_Mask.gbr, Bell2-B_Paste.gbr, Bell2-B_Silkscreen.gbr, Bell2-Edge_Cuts.gbr, Bell2-F_Cu.gbr, Bell2-F_Mask.gbr, Bell2-F_Paste.gbr]
2022-03-10 Tidy 3D
    [Access2.scad, Access2.stl, Bell2.scad, Bell2.stl, Bell2GPS.scad, Bell2GPS.stl, GPS.scad, GPS.stl]
2022-03-11 Tweak DRC
    [Access2.kicad_pcb, Access2.scad, Access2.stl, Bell2.kicad_pcb, Bell2.scad, Bell2.stl, Bell2GPS.scad, Bell2GPS.stl]
2022-03-17 Resistor fixes
    [Access.csv, Access.kicad_pcb, Access.kicad_sch, Access2.kicad_pcb, Access2.kicad_sch, Bell.csv, Bell.kicad_pcb, Bell.kicad_sch]
2022-03-29 C/R on EN
    [Keypad2-B_Cu.gbr, Keypad2-B_Mask.gbr, Keypad2-B_Paste.gbr, Keypad2-B_Silkscreen.gbr, Keypad2-Edge_Cuts.gbr, Keypad2-F_Cu.gbr, Keypad2-F_Mask.gbr, Keypad2-F_Paste.gbr]
2022-03-30 New logic for messages not taking over display and importantly not blocking the A=Arm function as all to easy for someone not to notice.
2022-04-19 Relay board
    [Bell2.kicad_pcb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]
2022-05-10 Clear display on error and start to ensure not shift or similar issues
    [keypad.c]
2022-05-18 No key clicks when FAILMSG
    [keypad.c]
2022-05-19 Replaced with Bell2GPS
    [Access2.scad, Bell2.csv, Bell2.scad, Bell2.stl]
2022-05-19 How I lost Bell2 I am unsure, restored
    [Access2.scad, Access2.stl, Bell2.kicad_pcb, Bell2.kicad_sch]
2022-05-25 Fix voltages
    [Access2-B_Cu.gbr, Access2-B_Mask.gbr, Access2-B_Paste.gbr, Access2-B_Silkscreen.gbr, Access2-Edge_Cuts.gbr, Access2-F_Cu.gbr, Access2-F_Mask.gbr, Access2-F_Paste.gbr]
2022-05-25 Remake STL
    [Access2.scad, Access2.stl, Bell.scad, Bell.stl, Bell2.scad, Bell2.stl, Bell2GPS.scad, Bell2GPS.stl]
2022-05-26 Handle mixed LED
2022-05-29 Added input
    [Relay.kicad_pcb, Relay.kicad_sch]
2022-05-31 Rename and added Relay10
    [Relay10.kicad_pcb, Relay10.kicad_sch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]
2022-05-31 Relay 10
    [Relay10-B_Cu.gbr, Relay10-B_Mask.gbr, Relay10-B_Paste.gbr, Relay10-B_Silkscreen.gbr, Relay10-Edge_Cuts.gbr, Relay10-F_Cu.gbr, Relay10-F_Mask.gbr, Relay10-F_Paste.gbr]
2022-05-31 New models
    [Access2.scad, Access2.stl, Bell.scad, Bell.stl, Bell2.scad, Bell2.stl, Bell2GPS.scad, Bell2GPS.stl]
2022-05-31 Tidy text
    [Relay10-B_Cu.gbr, Relay10-B_Mask.gbr, Relay10-B_Paste.gbr, Relay10-B_Silkscreen.gbr, Relay10-Edge_Cuts.gbr, Relay10-F_Cu.gbr, Relay10-F_Mask.gbr, Relay10-F_Paste.gbr]
2022-06-06 Allow pcb and gpio edit for new functions
2022-06-08 FFS crash on start, silly typo
    [input.c, output.c]
2022-06-08 Start up fix, and door any get fix
    [door.c, input.c]
2022-06-11 Bug with active low outputs
    [solarsystem.c]
2022-06-12 Cleaner startup, and fix logic when there are no door open inputs
    [SS.c, door.c, input.c]
2022-06-14 Fix node expect count
    [solarsystem.c]
2022-06-15 Now sends JSON id/afile for #180 Next step if to cache it at the device
2022-06-17 Better tamper switch
    [Access2.stl, Bell.scad, Bell.stl, Bell2.scad, Bell2.stl, Bell2GPS.scad, Bell2GPS.stl, GPS.scad]
2022-06-21 Address on device list
2022-07-24 Tidy up crystal solder paste and pads.
2022-07-28 Timer1 added #201 fixed
    [alarm.c, solarsystem.c]
2022-08-05 New tamper switch
    [Access-B_Cu.gbr, Access-B_Mask.gbr, Access-B_Paste.gbr, Access-B_Silkscreen.gbr, Access-Edge_Cuts.gbr, Access-F_Cu.gbr, Access-F_Mask.gbr, Access-F_Paste.gbr]
2022-08-05 Revised layout
    [Access2.scad, Access2.stl, Bell.scad, Bell.stl, Bell2.scad, Bell2.stl, Bell2GPS.scad, Bell2GPS.stl]
2022-08-07 Revised tamper
    [Access-B_Cu.gbr, Access-B_Mask.gbr, Access-B_Paste.gbr, Access-B_Silkscreen.gbr, Access-Edge_Cuts.gbr, Access-F_Cu.gbr, Access-F_Mask.gbr, Access-F_Paste.gbr]
2022-08-07 Avoid race on EL560 with manual, disarm, and access
    [alarm.c]
2022-08-10 Minor tweaks
    [Access2-B_Cu.gbr, Access2-B_Mask.gbr, Access2-B_Paste.gbr, Access2-B_Silkscreen.gbr, Access2-Edge_Cuts.gbr, Access2-F_Cu.gbr, Access2-F_Mask.gbr, Access2-F_Paste.gbr]
2022-08-15 Schematic cleanup
    [Access2.kicad_pcb, Access2.kicad_sch]
2022-08-15 Schematic cleanup, latest symbols, and added shelly tasmotizer connector when not using USB
    [Access2-B_Cu.gbr, Access2-B_Mask.gbr, Access2-B_Paste.gbr, Access2-B_Silkscreen.gbr, Access2-Edge_Cuts.gbr, Access2-F_Cu.gbr, Access2-F_Mask.gbr, Access2-F_Paste.gbr]
2022-08-15 Schematic cleanup and added shelly tasmotizer pads
    [Bell2-B_Cu.gbr, Bell2-B_Mask.gbr, Bell2-B_Paste.gbr, Bell2-B_Silkscreen.gbr, Bell2-Edge_Cuts.gbr, Bell2-F_Cu.gbr, Bell2-F_Mask.gbr, Bell2-F_Paste.gbr]
2022-08-15 Updated 3d
    [Access2.scad, Access2.stl, Bell2.scad, Bell2.stl, Bell2GPS.scad, Bell2GPS.stl]
2022-08-15 Unfinished adding programming pads
    [GPS.kicad_pcb, GPS.kicad_sch]
2022-08-15 Footprint change
    [Access2-B_Cu.gbr, Access2-B_Mask.gbr, Access2-B_Paste.gbr, Access2-B_Silkscreen.gbr, Access2-Edge_Cuts.gbr, Access2-F_Cu.gbr, Access2-F_Mask.gbr, Access2-F_Paste.gbr]
2022-08-15 Started revised layout
    [GPS.kicad_pcb, GPS.kicad_sch]
2022-08-15 Tracked new layout - needs tify
    [GPS-B_Cu.gbr, GPS-B_Mask.gbr, GPS-B_Paste.gbr, GPS-B_Silkscreen.gbr, GPS-Edge_Cuts.gbr, GPS-F_Cu.gbr, GPS-F_Mask.gbr, GPS-F_Paste.gbr]
2022-08-15 Retracked nicely.
    [Access2.scad, Access2.stl, Bell2.scad, Bell2.stl, Bell2GPS.scad, Bell2GPS.stl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]
2022-08-15 Make zip
    [Access-B_Cu.gbr, Access-B_Mask.gbr, Access-B_Paste.gbr, Access-B_Silkscreen.gbr, Access-Edge_Cuts.gbr, Access-F_Cu.gbr, Access-F_Mask.gbr, Access-F_Paste.gbr]
2022-08-16 New cases for non USB
    [Access2.stl, Access2NoUSB.scad, Access2NoUSB.stl, Bell.scad, Bell.stl, Bell2.scad, Bell2.stl, Bell2GPS.stl]
2022-08-17 No effective change, just logically correct
    [input.c]
2022-08-17 Advise disallowed fob as error
    [door.c]
2022-08-25 Backwards diode
    [Keypad2-B_Cu.gbr, Keypad2-B_Mask.gbr, Keypad2-B_Paste.gbr, Keypad2-B_Silkscreen.gbr, Keypad2-Edge_Cuts.gbr, Keypad2-F_Cu.gbr, Keypad2-F_Mask.gbr, Keypad2-F_Paste.gbr]
2022-08-25 Set device name
2023-01-11 Production files - not all finished yet.
    [Access-B_Cu.gbr, Access-B_Mask.gbr, Access-B_Paste.gbr, Access-B_Silkscreen.gbr, Access-Edge_Cuts.gbr, Access-F_Cu.gbr, Access-F_Mask.gbr, Access-F_Paste.gbr]
2023-01-11 Reverse polarity protection and additional capacitors for less clean supplies.
    [Access2.kicad_pcb, Access2.kicad_sch, bom.csv, designators.csv, positions.csv]
2023-01-22 Added FET on NFC Rx
    [Access2.kicad_pcb, Access2.kicad_sch, bom.csv, designators.csv, positions.csv]
2023-01-22 Allow inverted UART pins
    [nfc.c]
2023-02-24 Cleaned up device provisioning
2023-03-18 Moved old PCBs
    [Access.kicad_pcb, Access.kicad_sch, Bell.kicad_pcb, Bell.kicad_sch, Bell.scad, Bell.stl, Keypad.kicad_pcb, Keypad.kicad_sch]
2023-03-18 Started new board with two relay outputs
    [Access3.kicad_pcb, Access3.kicad_sch]
2023-03-18 New dual output board
    [Access3.kicad_pcb, Access3.kicad_sch, bom.csv, designators.csv, positions.csv]
2023-03-20 Latest boards
2023-03-24 Last module
    [Keypad2.kicad_pcb]
2023-03-24 Added dump of PCBs
2023-03-24 Added pcb dump
2023-03-25 PSTM connectors
    [Access3.kicad_pcb, Access3.kicad_sch, bom.csv, positions.csv]
2023-03-25 White socket
    [Access3.kicad_pcb, Access3.kicad_sch]
2023-03-25 Changed GPS to plug in module - will work with Generic when re-done
    [GPS.kicad_pcb, GPS.kicad_sch, GPS.stl, GPSNoUSB.scad, GPSNoUSB.stl, Generic.kicad_pcb, Generic.kicad_sch, Generic.scad]
2023-03-25 Other side of GPS
    [Generic.kicad_pcb, Generic.kicad_sch, bom.csv, designators.csv, positions.csv]
2023-03-25 New connectors, and separate GPS
    [Bell2.kicad_pcb, Bell2.kicad_sch, GPS.kicad_pcb, GPS.kicad_sch, Generic.kicad_pcb, Generic.kicad_sch, bom.csv, designators.csv]
2023-03-25 New boards
    [Bell2.kicad_pcb]
2023-03-26 New LED
    [Bell2.kicad_pcb, Bell2.kicad_sch, Generic.kicad_pcb, Generic.kicad_sch, bom.csv, positions.csv]
2023-03-26 Started work on new 3D models
    [GPS.scad, GPS.stl, GPSNoUSB.scad, GPSNoUSB.stl, Generic.scad]
2023-03-26 3D update
    [Access2.scad, Access2.stl, Access2NoUSB.scad, Access2NoUSB.stl, Access3.scad, Access3.stl, Access3NoUSB.scad, Access3NoUSB.stl]
2023-03-26 Deprecate Relay8 (use Relay10 instead)
    [Relay8.kicad_pcb, Relay8.kicad_sch, Relay8.scad, Relay8.stl, bom.csv, designators.csv, positions.csv]
2023-03-26 Update Relay10 and document
    [Access2.scad, Access2.stl, Access2NoUSB.scad, Access2NoUSB.stl, Access3.scad, Access3.stl, Access3NoUSB.scad, Access3NoUSB.stl]
2023-03-26 Renamed to Output
    [Output.kicad_pcb, Output.kicad_sch, Output.scad, Output.stl, bom.csv, designators.csv, positions.csv]
2023-03-26 Updated for locking smaller sockets
    [Access3.kicad_pcb, Access3.kicad_sch, bom.csv, positions.csv]
2023-03-26 New connectors
    [Access2.kicad_pcb, Access2.kicad_sch, bom.csv, positions.csv]
2023-03-26 Explain connectors
2023-03-26 Image and plugs
    [Access3.kicad_pcb]
2023-03-26 Clean up silkscreen
    [Access3.kicad_pcb]
2023-03-26 Footprints with plugs
    [Access2.kicad_pcb, Bell2.kicad_pcb, Generic.kicad_pcb, Output.kicad_pcb]
2023-03-29 Show PCB template name for GPIO and order by that
2023-03-29 Log button
2023-03-31 Started on new STL
2023-04-02 Upgrade restart issue, and GPS logging issue...
    [gps.c]
2023-04-04 New 3D
    [Access2.scad, Access2.stl, Access2NoUSB.scad, Access2NoUSB.stl, Access3.scad, Access3.stl, Access3NoUSB.scad, Access3NoUSB.stl]
2023-04-05 Inverted NFC rx option working now
    [nfc.c]
2023-04-06 Tidy STL
    [Access2.scad, Access2.stl, Access2NoUSB.scad, Access2NoUSB.stl, Access3.scad, Access3.stl, Access3NoUSB.scad, Access3NoUSB.stl]
2023-04-08 Revised for production
    [Output.kicad_pcb, Output.kicad_sch, bom.csv, positions.csv]
2023-04-19 Way cut down out of service
2023-05-27 Handle upgrade check cleanly in mesh system, for root device at least
2023-05-31 PCb tweak
    [Keypad2.kicad_pcb, Keypad2.kicad_sch, bom.csv, designators.csv, positions.csv]
2023-05-31 Tidy for production
    [Keypad2.kicad_pcb, Keypad2.kicad_sch, bom.csv, designators.csv, positions.csv]
2023-05-31 Order boards
    [Keypad2.kicad_pcb, Keypad2.kicad_sch, positions.csv]
2023-06-01 Cap change
    [Keypad2.kicad_pcb, Keypad2.kicad_sch, bom.csv]
2023-06-15 Prog header
    [Keypad2.kicad_pcb, positions.csv]
2023-06-18 Added a VEML for fun
    [Output.kicad_pcb, Output.kicad_sch, bom.csv, designators.csv, positions.csv]
2023-06-18 Fix regulator parts and update silk screen
    [Output.kicad_pcb, Output.kicad_sch, bom.csv, designators.csv, positions.csv]
2023-06-20 Tidy up - plan to change to CH340X
    [Generic.kicad_pcb]
2023-06-20 Weird, rotations were all wrong?!
    [Generic.kicad_pcb, Generic.kicad_sch, bom.csv, positions.csv]
2023-06-21 Rotation fixes
    [Generic.kicad_pcb, Generic.kicad_sch, positions.csv]
2023-06-22 Try new PSU
    [Generic.kicad_pcb, Generic.kicad_sch, bom.csv, designators.csv, positions.csv]
2023-06-22 Revised to not use tantalum
    [Generic.kicad_pcb, Generic.kicad_sch, bom.csv, positions.csv]
2023-06-22 New caps
    [Generic.kicad_pcb, Generic.kicad_sch, bom.csv, positions.csv]
2023-06-23 Tidy regulator
    [Generic.kicad_pcb, positions.csv]
2023-06-23 Tidy reg
    [Generic.kicad_pcb, positions.csv]
2023-06-24 Leave default
    [Generic.kicad_sch]
2023-06-28 CH340X DTR
    [Generic.kicad_pcb, Generic.kicad_sch, bom.csv, designators.csv, positions.csv]
2023-06-29 Fix RGB
    [Generic.kicad_pcb, Generic.kicad_sch, positions.csv]
2023-07-01 New reg, LED, UART
    [Output.kicad_pcb, Output.kicad_sch, bom.csv, designators.csv, positions.csv]
2023-07-01 Slight tidy, needs new LED/PSU/panel
    [Keypad2.kicad_pcb, Keypad2.kicad_sch, positions.csv]
2023-07-06 Fix output driver
    [Output.kicad_pcb, Output.kicad_sch]
2023-07-17 This was not the problem
    [solarsystem.c]
2023-07-17 More stack just in case
2023-07-18 Added rst, mem, and spi
2023-08-03 Reorg PCBs
    [Access.kicad_pcb, Access.kicad_sch, Access.scad, Access.stl, Access3NoUSB.stl, Bell.kicad_pcb, Bell.kicad_sch, Bell.scad]
2023-08-03 Started on Access4
    [Access.kicad_pcb, Access.kicad_sch, bom.csv, designators.csv, positions.csv]
2023-08-03 Basic size and placement
    [Access.kicad_pcb, Access.kicad_sch, bom.csv, designators.csv, positions.csv]
2023-08-03 Basic layout better
    [Access.kicad_pcb, Access.kicad_sch]
2023-08-03 Crashing KiCad
    [Access.kicad_pcb]
2023-08-03 Tracked (not pretty yet).
    [Access.kicad_pcb, Access.kicad_sch, designators.csv, positions.csv]
2023-08-04 Tidy old PCB design
    [Access.kicad_pcb, Access.kicad_sch, Access.scad, Access.stl, Access2.kicad_pcb, Access2NoUSB.scad, Access2NoUSB.stl, bom.csv]
2023-08-10 Reworked one access
    [Access.kicad_pcb, Access.kicad_sch, Access.scad, Access.stl, bom.csv, designators.csv, positions.csv]
2023-08-10 Changed version
    [Bell.kicad_pcb, Bell.kicad_sch, Bell.scad, Bell.stl, bom.csv, designators.csv, positions.csv]
2023-08-14 Moved GPIO off 48
    [Access.kicad_pcb, Access.kicad_sch]
2023-08-18 USB prog added
    [Access.kicad_pcb, Access.kicad_sch]
2023-08-19 New reg
    [Access.kicad_pcb, Access.kicad_sch, bom.csv, designators.csv, positions.csv]
2023-09-05 Reworked boarder, and added simple LED on GPIO 0
    [Output.kicad_pcb, Output.kicad_sch, bom.csv, designators.csv, positions.csv]
2023-09-06 Fixing JLC loader
    [Output.kicad_pcb, positions.csv]
2023-09-07 Tidy, new PSU and LED
    [Keypad.kicad_pcb, Keypad.kicad_sch, bom.csv, designators.csv, positions.csv]
2023-09-07 Re-designed for ESP32-S3
    [Keypad.kicad_pcb, Keypad.kicad_sch, bom.csv, designators.csv, positions.csv]
2023-10-15 Some improvement, needs to change to S3 though
    [Access.kicad_pcb, Generic.kicad_pcb, Generic.kicad_sch, bom.csv, designators.csv, positions.csv]
2023-10-16 Clean up a lot
    [Bell.kicad_pcb, Bell.kicad_sch, bom.csv, positions.csv]
2023-12-12 Reworked for simpler ESD protection
    [Access.kicad_pcb, Access.kicad_sch, bom.csv, designators.csv, positions.csv]
2023-12-13 LEDs on Access I/O
    [Access.kicad_pcb, Access.kicad_sch, bom.csv, designators.csv, positions.csv]
2023-12-13 Parts tidy
    [Access.kicad_pcb, Access.kicad_sch, bom.csv, positions.csv]
2023-12-16 ESP32 pull up/down on input
2023-12-17 More GPIOs allowed on ESP32S3
2023-12-17 Added RGB LED number fields for future use
2023-12-17 More caps
    [Access.kicad_pcb, Access.kicad_sch, bom.csv, designators.csv, positions.csv]
2023-12-17 RGB config on power
2023-12-17 Setting RGB LED in config
2023-12-17 RGB LED input/output logic
2023-12-18 Tidy for order
    [Access.kicad_pcb, Output.kicad_pcb, Output.kicad_sch, bom.csv, designators.csv, positions.csv]
2023-12-22 More work on 3D
    [Access.scad, Access.stl, Bell.scad, Bell.stl, GPS.scad, GPS.stl, Generic.scad, Generic.stl]
2023-12-27 Silly mistake in LED config
2023-12-27 Tidy LED
2024-01-01 Moved to GPS project
    [Access.kicad_pcb, Access.kicad_sch, Access.scad, Access.stl, GPS.kicad_pcb, GPS.kicad_sch, GPS.scad, GPS.stl]
2024-01-02 Clear to avoid solder draining down hole instead of pad
    [Access.kicad_pcb, positions.csv]
2024-01-05 Fix GPIO 40 limit
    [SS.h, input.c]
2024-01-05 Provision with device copy
2024-01-19 Default baud rate fix
    [nfc.c]
2024-01-23 No LED strip on V1
2024-01-23 Revert led_strip change
2024-02-10 Fixed PCb editr
2024-02-11 Split brain detect and reset
    [solarsystem.c]
2024-03-04 Tidy up PCb
    [Bell.kicad_pcb, Bell.kicad_sch, bom.csv, positions.csv]
2024-03-15 Tidy PCB
    [Bell.kicad_pcb, bom.csv, positions.csv]
2024-03-21 Colour wrong on inputs
    [input.c]
2024-05-12 Remove TOS as INVALID ARGUMENT error?!
    [alarm.c]
2024-08-16 Cannot make production files, FFS
    [Keypad.kicad_pcb, bom.csv, designators.csv, positions.csv]
2024-09-24 New PIN handling logic
2024-09-24 Strong PIN arm
2024-12-12 New PCB design using WAGOs
    [Access.kicad_pcb, Access.kicad_sch, Access.scad, Access.stl, bom.csv, designators.csv, positions.csv]
2024-12-16 Silkscreen, and 21
    [Access.kicad_pcb, Access.kicad_sch, designators.csv, positions.csv]
2024-12-31 Trying to sort led strip
2025-01-19 Latest WAGO boards
2025-01-23 PCB Update
    [Access.kicad_pcb, Access.kicad_sch, Bell.kicad_pcb, Bell.kicad_sch, Generic.kicad_pcb, Generic.kicad_sch, Keypad.kicad_pcb, Keypad.kicad_sch]
2025-03-26 Component fix
    [Access.kicad_pcb, Access.kicad_sch, bom.csv, positions.csv]
2025-04-18 Bell WAGO and other updates and renders
    [Access.kicad_pcb, Access.kicad_sch, Bell.kicad_pcb, Bell.kicad_sch, bom.csv, designators.csv, positions.csv]
2025-07-30 Expoental PIN backoff
2025-08-09 Case update
    [Access.scad, Access.stl, Bell.scad, Bell.stl, Generic.scad, Generic.stl, Output.scad]
2025-08-12 new render and case
    [AccessB.scad, AccessB.stl, AccessT.scad, AccessT.stl, BellB.stl, BellT.stl, GenericB.stl, GenericT.stl]
2025-08-13 New case
    [AccessB.scad, AccessB.stl, AccessT.scad, AccessT.stl, BellB.stl, GenericB.stl, OutputB.stl]
2025-08-18 WAGO pins
    [AccessB.scad, AccessB.stl, AccessT.scad, AccessT.stl, BellB.scad, BellB.stl, BellT.scad, BellT.stl]
2025-08-28 Added idle led timeout on NFC reader
2025-09-18 Avoid disarm/hold/arm scenario
2025-09-20 Fix disarm message, and more distinctive beep
    [keypad.c]
2025-09-20 Cleaner arm/disarm message and beep logic
2025-10-09 New LEDs
    [Access.kicad_pcb, Access.kicad_sch, AccessB.scad, AccessB.stl, AccessT.scad, AccessT.stl, BellB.scad, BellB.stl]
